D-Modem/hardware/hardware/README.md

<!-- SPDX-License-Identifier: CERN-OHL-S-2.0 -->
<!-- Copyright (C) 2026 D-Modem Authors -->
# pico-serial hardware

`netlist/build_netlist.py` defines every part and every connection on the
board. The netlist, the readable net list, the JLC parts list, the
schematic and the PCB are all generated from it, so change the script,
not the outputs.

It makes three boards. The **hood board** (the default) fits a standard DB25
hood. **pico-serial W** (`--variant w`, [SPEC-W.md](../SPEC-W.md)) adds an
RM2 Bluetooth module and lives in a 3D-printed hood (`enclosure/`). Its
files carry a `-w` suffix; see [pico-serial W](#pico-serial-w-bluetooth).
**pico-serial Line** (`--variant line`, [SPEC-L.md](../SPEC-L.md)) is a
different device on the same RP2040 core: a USB-C stick that connects to a
telephone line, for D-Modem; files `-line`, see
[pico-serial Line](#pico-serial-line-phone-line-stick).

Everything targets **KiCad 9**: KiCad 9 file formats and the KiCad 9.0
symbol and footprint libraries. KiCad 10 opens it too.

| File | What it is |
|---|---|
| `netlist/build_netlist.py` | The circuit: parts, nets, the checks |
| `netlist/pico-serial.net` | KiCad netlist (generated) |
| `netlist/NETLIST.md` | Every net and every part, readable (generated) |
| `netlist/bom-jlc.csv` | JLC assembly parts list with LCSC numbers (generated) |
| `kicad/build_schematic.py` | Draws the schematic from the netlist script |
| `kicad/pico-serial.kicad_sch` | KiCad schematic, one A2 sheet (generated) |
| `kicad/pico-serial.kicad_sym` | SP3238E and MAX3243E symbols, which KiCad doesn't ship (generated) |
| `kicad/preview.svg` | Rough drawing of the sheet for a quick look (generated) |
| `kicad/build_pcb.py` | Lays out and routes the PCB: outline, rules, placement, planes |
| `kicad/pico-serial.kicad_pcb` | KiCad PCB, 4 layers (generated) |
| `kicad/pico-serial.kicad_dru` | Two board-specific DRC rules (the DB25 cups and USB-C shell at the edges) |
| `kicad/fab/` | Gerbers + drill (zip) and the JLC placement file (generated) |
| `kicad/render-top.png`, `render-bottom.png` | KiCad 3D renders, without part models (generated) |
| `netlist/pico-serial-w.net`, `NETLIST-w.md`, `bom-jlc-w.csv` | The same for pico-serial W (generated) |
| `kicad/pico-serial-w.*`, `preview-w.svg`, `render-w-*.png` | pico-serial W's schematic, PCB, rules and renders |
| `kicad/lib/make_footprints.py` | Writes `lib/pico-serial.pretty/`: the RM2 (from its datasheet's drawing), the M2 screw hole, the RJ11 and the telecom fuse |
| `netlist/*-line.*`, `kicad/pico-serial-line.*`, `kicad/render-line-*.png` | pico-serial Line's netlist, BOM, schematic, PCB, rules and renders |
| `netlist/*-wb.*`, `kicad/pico-serial-wb.*`, `kicad/render-wb-*.png` | pico-serial WB's netlist, BOM, schematic, PCB, rules and renders |
| `enclosure/stick.py`, `enclosure/out-line/` | The Line stick's printed shell, its board outline and placement |
| `kicad/fp-lib-table` | Points KiCad at `lib/pico-serial.pretty` |

## Regenerate

```sh
python3 hardware/netlist/build_netlist.py       # checks + netlist, NETLIST.md, BOM
python3 hardware/kicad/build_schematic.py   # checks + schematic and preview
python3 hardware/kicad/build_pcb.py --kicad-fp kicad-footprints --route --fab   # PCB (see below)
```

Add `--variant w` to each for pico-serial W.

Neither needs KiCad or a network connection. The schematic script uses
symbols cached in `kicad/lib/symbol-cache.sexp`.

To check every pin against KiCad's own libraries, and to refresh the
symbol cache, point the scripts at the KiCad 9.0 library checkouts:

```sh
git clone --depth 1 --branch 9.0.6 https://gitlab.com/kicad/libraries/kicad-symbols.git
git clone --depth 1 --branch 9.0.6 https://gitlab.com/kicad/libraries/kicad-footprints.git
python3 hardware/netlist/build_netlist.py --kicad-sym kicad-symbols --kicad-fp kicad-footprints
python3 hardware/kicad/build_schematic.py --kicad-sym9 kicad-symbols
```

It stops with an error, and writes nothing, if:
- a pin is neither connected nor listed as deliberately open;
- a net has only one pin;
- a net has two outputs;
- an RS-232 line doesn't have exactly one driver and one receiver;
- a power input isn't on a supply net;
- with the KiCad checkouts: a pin number or name differs from KiCad's
  symbol, or a footprint lacks a pad for a pin.

## What's in it

The circuit follows `../SPEC.md` (draft 0.3): §4.2–4.8 for the parts and
§4.6 for the GPIO map.

- **Power and USB:**
  - USB-C (HRO TYPE-C-31-M-12) with its own 5.1 kΩ on each CC pin;
  - 0.5 A PTC fuse, 5 V TVS diode, USBLC6 ESD protection;
  - AP2112K 3.3 V regulator, VBUS ÷2 sense into GP29.
- **RP2040:**
  - Raspberry Pi's minimal design: per-pin decoupling, 12 MHz crystal
    with 15 pF caps and 1 kΩ on XOUT, 27 Ω USB series resistors;
  - W25Q128JV flash;
  - BOOTSEL and RESET buttons, 10 kΩ RUN pull-up.
- **RS-232:**
  - SP3238E (chip A, DCE) and MAX3243E (chip B, DTE) on the same 8 DB25
    pins, so every line has one driver and one receiver;
  - each chip has 220 nF + 1 µF charge-pump caps and 1 µF + 100 nF on VCC;
  - both chips are held off by 100 kΩ pull-downs until firmware chooses
    a role.
- **DB25:** solder-cup female (MH Connectors MHDB25SS). Pin 7 to GND, pin
  1 to GND through a 0 Ω link. All other unused pins stay open.
- **Optional:** six status LEDs on GP22–27, not fitted (DNP).
- **Test pads:** VBUS, 3V3, 1V1, GND, SWCLK, SWDIO, RUN, GP28, and the TX/RX
  lines of both chips.

The two RS-232 chips have no KiCad symbol. Their pin tables are copied
from the datasheets (MaxLinear SP3238E rev 1.0.1; TI MAX3243E SLLS657E,
Table 6-2) and marked as such in the script. Every other part's pins
match KiCad's library symbols.

## The schematic

`kicad/pico-serial.kicad_sch` is one A2 sheet in blocks:
- USB-C, protection and supply;
- RP2040 and its decoupling;
- crystal, flash and buttons;
- chip A (DCE) and chip B (DTE), each with its charge-pump capacitors;
- the DB25;
- the optional LEDs;
- test pads and the power flags ERC needs.

Every pin ends in a short wire with a net label or power symbol, so parts
connect by name, not by long wires. Each part carries its LCSC number, a
note on its purpose, and its footprint.

The schematic script refuses to write if:
- the connections read back from the drawing differ from the netlist in
  any way (a missing pin, an extra join, a pin touching the middle of a
  wire);
- any two texts, labels or symbols overlap.

It's generated, so hand edits are overwritten on the next run. Either
change `build_netlist.py` and regenerate, or stop generating and edit in
KiCad from then on.

## The PCB

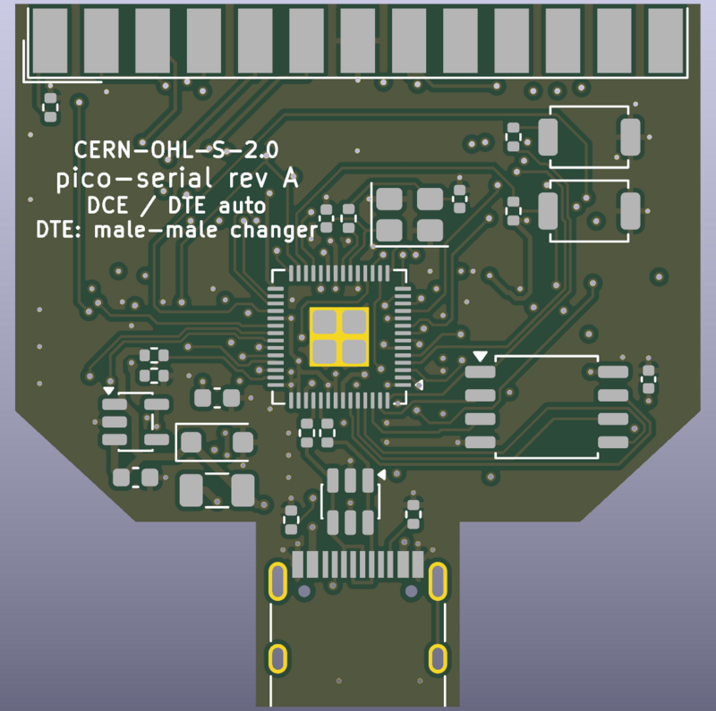
[picture p2: hardware/kicad/render-top.png]
Top

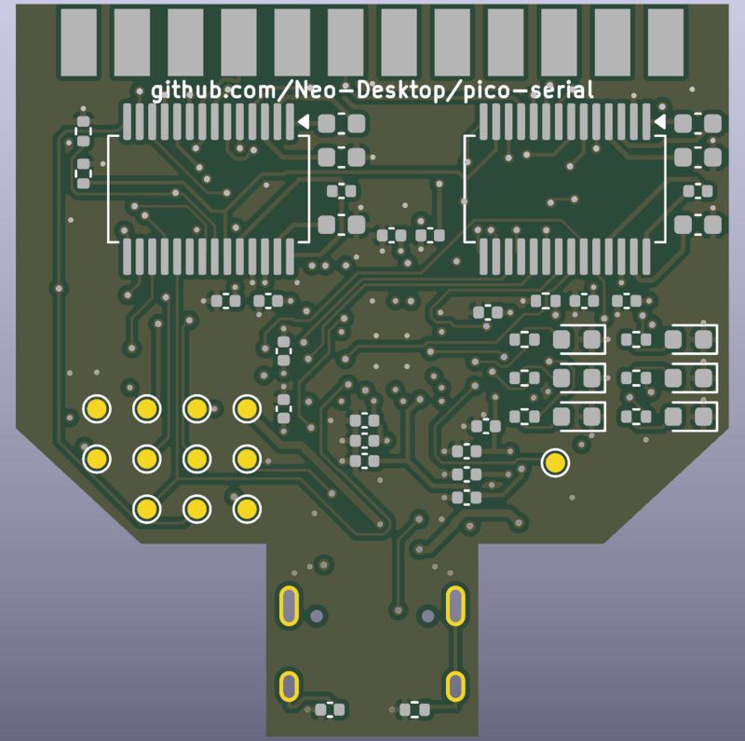
[picture p3: hardware/kicad/render-bottom.png]
Bottom


`kicad/pico-serial.kicad_pcb`, made by `kicad/build_pcb.py` with KiCad
9's Python module (pcbnew). **Status:** fully routed; KiCad 9.0.9's DRC
finds no errors, no warnings and nothing unconnected, and the PCB matches
the schematic exactly (DRC's schematic parity check). CI checks all of
this on every change (`.github/workflows/hardware.yml`). Not yet
reviewed by a person, and nothing has been built.

- **Board:** about 37 × 38 mm, 4 layers, 1.6 mm; JLCPCB's standard
  4-layer process with margin (0.127 mm clearance, 0.15 mm tracks,
  0.25 mm via drills). The outline is SPEC §7.2's inferred one: full width at the DB25,
  narrowing behind, and a tongue for the USB-C into the hood's cable exit.
  It's set at the top of the script; **confirm it on a sample hood**.
- **DB25:** the board's front edge slides between the solder cups: pins
  1-13 on top, 14-25 underneath.
- **Top:** RP2040, flash, crystal, buttons; USB-C, ESD, fuse, TVS and the
  regulator at the back.
- **Bottom:** both transceivers with their charge pumps, right behind the
  cups (seen from the top, chip A/U5 is on the left and chip B/U6 on the
  right, the order with the fewest crossing connections); the RP2040's
  decoupling, about 2 mm from its pins; test pads; the
  optional LEDs.
- **Layers:**
  - F.Cu: signals, then a GND pour;
  - In1.Cu: solid GND plane under everything;
  - In2.Cu: signals, then a +3V3 pour in the space left;
  - B.Cu: signals, then a GND pour.
- **Vias:** every GND and +3V3 pad gets its own short stub and via before
  routing. The RP2040's +3V3 pins have theirs under the package, between
  the pins and the exposed pad, so the ring around it stays free for the
  signals; the exposed pad has four.
- **Kept clear:**
  - the USB D+/D- path from the RP2040 to the series resistors and the
    ESD chip has no vias across it;
  - nothing passes under the crystal on the top layer (keep-outs between
    its pads); the In1 GND plane shields it from the rest;
  - a 0.35 mm band inside the board edge has no tracks or vias
    (Freerouting doesn't apply KiCad's edge clearance).
- **Silkscreen:** on top, name and revision, "DCE / DTE auto", the
  gender-changer note and `CERN-OHL-S-2.0`; underneath, between the cups
  and the chips, `github.com/D-Modem/hardware` (the licence's
  Source Location). Reference designators are on the fab layers; there's
  no room for them on the silkscreen.
- **Linked to the schematic:** every footprint carries its symbol's ID,
  and every pad its net under the name KiCad gives it.

### Test pads (bottom)

1 mm pads on a 2.6 mm grid behind the flash, for pogo pins; GP28 sits
apart, by the RP2040's left side. Coordinates in mm, from the middle of
the DB25 edge, toward the USB-C:

| y \ x | 6.5 | 9.1 | 11.7 | 14.3 |
|---|---|---|---|---|
| 21.0 | TP1 VBUS | TP2 3V3 | TP3 1V1 | TP4 GND |
| 23.6 | TP5 SWCLK | TP6 SWDIO | TP7 RUN | TP9 A_TX |
| 26.2 | TP10 A_RX | TP11 B_TX | TP12 B_RX | |

TP8 (GP28) is at x = -9.5, y = 23.8.

### Rebuilding it

```sh
python3 hardware/kicad/build_pcb.py --kicad-fp kicad-footprints \
    --route --freerouting freerouting-1.9.0.jar --fab
```

- **Needs:** KiCad 9 (its Python module and `kicad-cli`), the KiCad 9.0
  footprint libraries, Java, `xvfb-run`, and
  [Freerouting](https://github.com/freerouting/freerouting) 1.9.0.
  Freerouting 2.1 ignores its pass limit on the command line, so 1.9 it
  is; it wants a display, hence `xvfb-run`.
- **Routing:** Freerouting routes everything but GND, which the plane and
  the vias already connect. It runs in rounds, each starting from the
  last (`--rounds`). Then a small grid router in the script (A* on a
  0.1 mm grid over the three signal layers, checked against KiCad's own
  copper shapes) joins anything still apart.
- **Repeatable:** Freerouting gives the same result for the same board and
  pass count. If a pass count leaves something unrouted, the script tries
  the next in `--passes` (40, 30, 50, 35, 45) and keeps the first that
  routes everything. It says which it kept, and warns if none did.
- **Without `--route`** it writes the placed, unrouted board (with its
  vias and planes); `--ses` imports a saved Freerouting session instead.
- **`--fab`** writes `fab/pico-serial-gerbers.zip` and
  `fab/pico-serial-cpl-jlc.csv`. Upload the zip, `netlist/bom-jlc.csv` and
  the CPL file to JLCPCB. The DB25 is hand-soldered, so it's in neither
  list.
- **Before ordering assembly:** parts go on both sides (two-sided
  assembly costs extra). Check every part's rotation in JLC's preview,
  bottom-side ones especially: the CPL comes straight from KiCad, and
  JLC's footprints don't always agree on 0°.

## Using it in KiCad

1. Open `kicad/pico-serial.kicad_pro` in KiCad 9 or 10. The project
   table points at `pico-serial.kicad_sym`, which has the two RS-232
   symbols. Every symbol is also embedded in the schematic.
2. Run ERC: clean (KiCad 9.0.9, with the 9.0 libraries).
3. Open the PCB and run DRC, with the schematic parity check: clean.
4. The PCB is linked to the schematic, so **Update PCB from Schematic**
   works as usual. DRC's parity check, the same comparison, finds no
   difference. (The update itself hasn't been run: there was no KiCad GUI
   where this was made.)

## Before ordering

- **Have a person review the layout.** It's autorouted, so check what a
  router doesn't weigh: the crystal and its loop, the decoupling, the USB
  pair, the RS-232 lines near the cups. It routes cleanly, not
  necessarily well.
- Lock the board outline from the sample connector and hood (SPEC §7, §9),
  and check the board slides between the DB25's cups.
- Bench test the SP3238E's leakage while shut down (SPEC §8). If it fails,
  the DCE chip changes to the TI TRS3238E (TSSOP-28) and its footprint
  changes too.

## pico-serial W (Bluetooth)

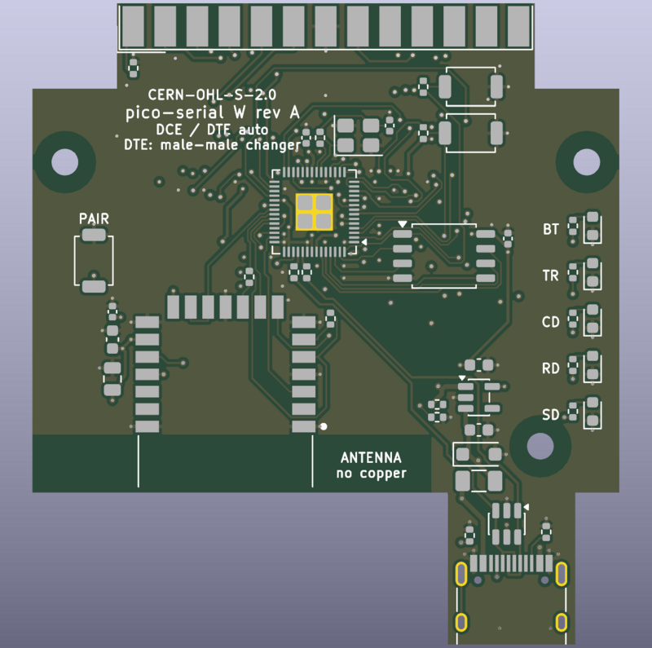
[picture p4: hardware/kicad/render-w-top.png]
W top

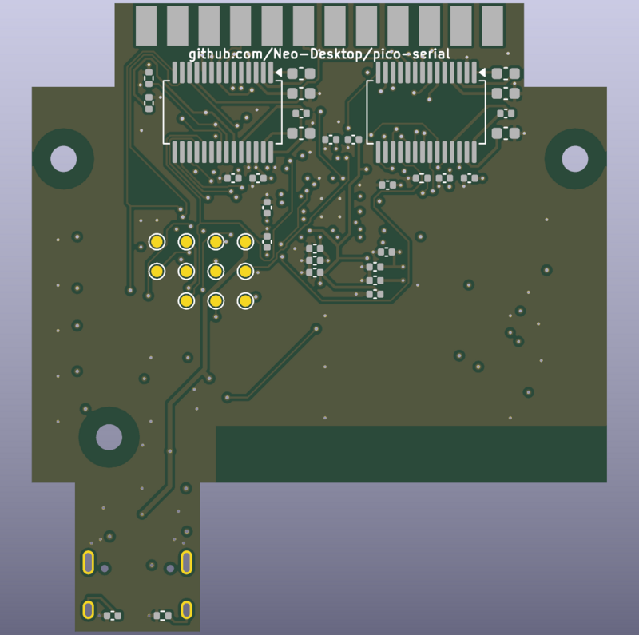
[picture p5: hardware/kicad/render-w-bottom.png]
W bottom


The same circuit plus a Raspberry Pi RM2 radio module, on a larger board
for the 3D-printed hood ([SPEC-W.md](../SPEC-W.md), `enclosure/`).
Every script takes `--variant w`; its files are `pico-serial-w.*`.

```sh
python3 hardware/netlist/build_netlist.py --variant w
python3 hardware/kicad/build_schematic.py --variant w
python3 hardware/kicad/build_pcb.py --variant w --kicad-fp kicad-footprints \
    --route --freerouting freerouting-1.9.0.jar --fab
```

**Status:** fully routed. DRC finds no errors and nothing unconnected,
and the PCB matches its schematic; ERC is clean. CI checks both boards.
Not reviewed by a person, nothing built.

- **Circuit changes** (SPEC-W §3): the RM2 on GP23-25 and GP29, wired as on
  Pico W (470 Ω and 10 kΩ into the shared GP24); 10 µF + 100 nF + 22 µF
  at its supply; five LEDs, fitted (BT, TR, CD on RP2040 pins; RD and SD
  on the RM2's own GPIOs); VBUS sense on the RM2's GPIO0; a pairing button
  on GP28 (so no GP28 test pad).
- **Outline and fixed positions** come from `enclosure/w_hood.py`, not
  from this script: the outline, three M2 screw holes, the RM2 (antenna
  end flush with the board's back edge), the USB-C in its tongue, the
  LEDs under the hood's light tubes and the button under its pinhole.
  Change them there and both stay in step.
- **Front half:** the DB25, both RS-232 chips, the RP2040, flash, crystal
  and buttons are placed as on the hood board. The front strip is 0.5 mm
  narrower (thumbscrew pockets), so chip A and its charge pumps sit
  0.6 mm further in.
- **Antenna keep-out:** a rule area with no copper on any layer (tracks,
  vias, pads, pours, planes) over the strip of board inside the RM2's
  35.5 × 18.5 mm keep-out. The rest of it is air inside the hood.
- **Screw holes:** 2.3 mm, unplated, with 5.4 mm kept free of copper and
  parts (screw head and the hood's bosses). They're board-only footprints
  (`lib/pico-serial.pretty/MountingHole_M2`), not in the schematic.
- **RM2 footprint:** `lib/make_footprints.py`, from the datasheet's
  Figure 6: 21 pads, 1.5 mm pitch, reaching 0.5 mm past the module. Check
  it against a real module before ordering.
- **Assembly:** the RM2 isn't stocked at LCSC, so it's marked
  hand-fitted and is in neither the BOM nor the CPL. Solder it by hand or
  send it to JLC as a consigned part. The DB25 is hand-soldered as on the
  hood board.
- **Before ordering:** everything under "Before ordering" above, plus a
  test print of the hood, to confirm the screw holes, LED and button
  positions.

## pico-serial Line (phone-line stick)

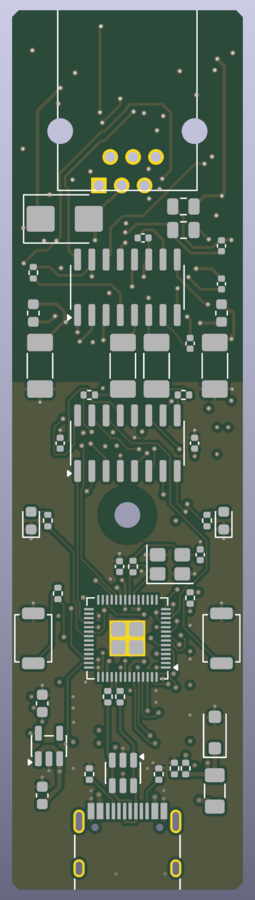
[picture p6: hardware/kicad/render-line-top.png]
Line top

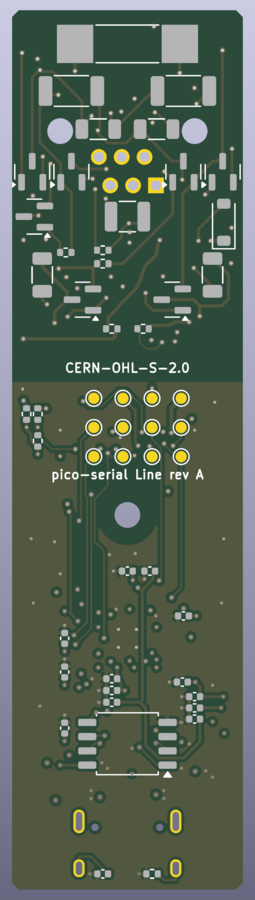
[picture p7: hardware/kicad/render-line-bottom.png]
Line bottom


A USB-C stick for a telephone line, shaped like Apple's USB Modem
([SPEC-L.md](../SPEC-L.md)): the RP2040 core and a Skyworks Si3056 +
Si3018 DAA. The modem itself is D-Modem on the computer or phone
(`dmodemd --usb`). Every script takes `--variant line`; the shell is
`enclosure/stick.py`.

```sh
python3 hardware/netlist/build_netlist.py --variant line
python3 hardware/kicad/build_schematic.py --variant line
python3 hardware/enclosure/stick.py          # the shell; needs CadQuery
python3 hardware/kicad/build_pcb.py --variant line --kicad-fp kicad-footprints \
    --route --freerouting freerouting-1.9.0.jar --fab
```

**Status:** fully routed (190 vias, 1036 tracks). KiCad's DRC finds no
errors and nothing unconnected, and the PCB matches its schematic; ERC is
clean. Not reviewed by a person, nothing built: **have the line side and
the isolation gap checked by someone who knows telecom safety before it
goes near a phone line.**

- **Board:** 78.4 × 20.6 mm, 4 layers, on the outline `stick.py` sets.
  The RJ11 at the front edge, its opening flush with the stick's end;
  the USB-C at the back.
- **Line side** (front, about 30 mm): the surge suppressor, the 1.25 A
  telecom fuse, the bridge, the Si3018 and its hook switch, DC
  termination and caller-ID parts, on both sides of the board. **No
  ground plane or pour** (Skyworks AN67): the planes and pours stop at
  the isolation gap.
- **Isolation gap:** a 2.5 mm band across the board, every layer, with no
  tracks, vias or pours; only the four Y2 capacitors (C1, C2: the data
  path; C8, C9: TIP and RING to ground) straddle it. A DRC rule
  (`pico-serial-line.kicad_dru`) also holds 2.5 mm between any line-side
  and USB-side copper.
- **Net classes:** `TipRing` (TIP, RING, the bridge's +: the ringing
  signal and loop current) 0.3 mm tracks, 0.4 mm clearance; `Line` (the
  Si3018's low-voltage side) 0.25 mm.
- **USB side:** the Si3056 by the gap, the one screw, the two LEDs under
  the shell's light tubes, the RP2040 with its flash underneath, then the
  USB-C with its ESD, fuse and regulator.
- **Hand-fitted or consigned:** the Si3056 and Si3018 (DigiKey; the
  Si3056 is "not for new designs") and the through-hole RJ11. They're in
  neither the JLC BOM nor the CPL.
- **Not checked yet:** the RJ11's body against a real one (its drawing
  gives the pins and pegs; the body's edges are read off it), and the
  shell's fit (not printed).

## pico-serial WB (wideband bare-pair stick)

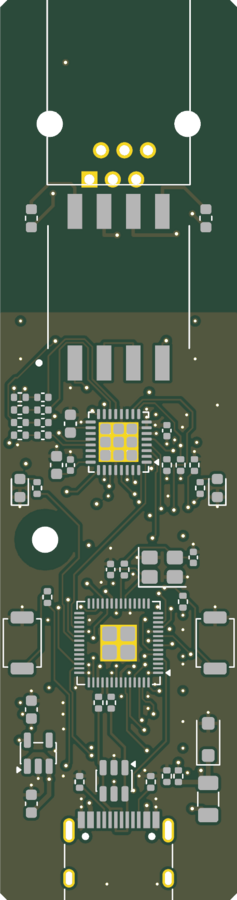
[picture p8: hardware/kicad/render-wb-top.png]
WB top

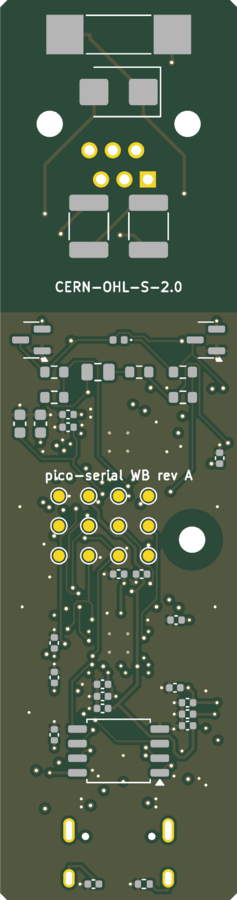
[picture p9: hardware/kicad/render-wb-bottom.png]
WB bottom


The Line stick's sibling for bare copper pairs ([SPEC-WB.md](../SPEC-WB.md)):
the same RP2040 core and USB end, a TI TLV320AIC3204 codec sampling at
96 kHz, and a Pulse PE-65848 line transformer. Two WB sticks talk to each
other over the pair; the modem is D-Modem's wideband mode on the
computer or phone. Every script takes `--variant wb`; the shell is the
Line stick's (`enclosure/stick.py --variant wb`).

```sh
python3 hardware/netlist/build_netlist.py --variant wb
python3 hardware/kicad/build_schematic.py --variant wb
python3 hardware/enclosure/stick.py --variant wb     # the shell; needs CadQuery
python3 hardware/kicad/build_pcb.py --variant wb --kicad-fp kicad-footprints \
    --route --freerouting freerouting-1.9.0.jar --fab
```

**Status:** fully routed. KiCad's DRC finds no errors and nothing unconnected, and the PCB matches its schematic; ERC is clean. Fab files in `kicad/fab/`. Not reviewed by a person, nothing built.

- **Board:** the Line stick's outline and USB end (RP2040, flash, USB-C,
  regulator). The screw is 6.4 mm off the centre line and the two LEDs
  (LINK and DATA) 3 mm further forward than on the Line stick, so the
  codec's connections can run down the middle; `stick.py --variant wb`
  moves the shell's boss and light tubes to match.
- **Pair side** (front): the RJ11, the 1.25 A telecom fuse and the
  sidactor underneath, ferrites beside the transformer, and the DC block
  (two 1 µF 250 V in series, 0.5 µF / 500 V) in the transformer's split
  line winding. **No ground plane or pour.**
- **Isolation gap:** a 4 mm band across the board under the transformer,
  every layer, no tracks, vias or pours. Only the transformer crosses
  it: its codec winding's pads and its line winding's are 10 mm apart. A
  DRC rule (`pico-serial-wb.kicad_dru`) also holds 2.5 mm between any
  pair-side (`TipRing`) and USB-side copper.
- **Codec side:** the hybrid on the bottom behind the transformer (60.4 Ω
  drive resistors, the ×10 replica arm, the 1 kΩ + 1 µF into each mixer
  input), the clamps (a 5 V TVS across the winding, a BAV99 on each
  end), and the codec on top with its supply and reference capacitors.
- **Hand-fitted:** the through-hole RJ11. The transformer is a JLC part
  (C7261159), but stock is low (about 250).
- **Not checked yet:** the transformer's bandwidth and saturation (its
  datasheet gives neither: sweep one from 1 to 200 kHz), the hybrid's
  values on a real cable, and the shell's fit (not printed). The 1812 DC
  block capacitors sit on the bottom, under the shell's 2.2 mm clearance.
