D-Modem/hardware/docs/README.md

# pico-serial documentation

## Specs

- [SPEC.md](../SPEC.md): pico-serial, the DB25 adapter
- [SPEC-W.md](../SPEC-W.md): pico-serial W, the Bluetooth variant
- [SPEC-L.md](../SPEC-L.md): pico-serial Line, the phone-line stick
- [SPEC-WB.md](../SPEC-WB.md): pico-serial WB, the wideband bare-pair stick

## Firmware

- [firmware/README.md](../firmware/README.md): build, flash, what it does, Bluetooth, automatic baud rate, tests, the Line and WB sticks
- [firmware/PROTOCOL.md](../firmware/PROTOCOL.md): the control protocol for host apps
- [Protocol reference](protocol-reference.md): every request, constant and wire struct in the protocol headers, made from them (`firmware/tools/protocol_ref.py`)

## Hardware

- [hardware/README.md](../hardware/README.md): the netlist script, schematic, PCB, test pads, ordering
- [hardware/enclosure/README.md](../hardware/enclosure/README.md): the 3D-printed enclosures
- Generated net lists: [NETLIST.md](../hardware/netlist/NETLIST.md), [NETLIST-w.md](../hardware/netlist/NETLIST-w.md), [NETLIST-line.md](../hardware/netlist/NETLIST-line.md), [NETLIST-wb.md](../hardware/netlist/NETLIST-wb.md)

## Licensing

- [LICENSING.md](../LICENSING.md)
