D-Modem/hardware/hardware/netlist/NETLIST-line.md

<!-- SPDX-License-Identifier: CERN-OHL-S-2.0 -->
<!-- Copyright (C) 2026 D-Modem Authors -->
# pico-serial Line netlist

Generated by `build_netlist.py`; edit that script, not this file.

99 parts, 76 nets. DNP = not fitted by default.

## Nets

| Net | Pins |
|---|---|
| `+1V1` | C13.1, C14.1, C15.1, TP3.1 (1), U1.23 (DVDD), U1.45 (VREG_VOUT), U1.50 (DVDD) |
| `+3V3` | C3.1, C4.1, C5.1, C6.1, C7.1, C8.1, C9.1, C10.1, C11.1, C12.1, C18.1, C19.1, R10.1, R11.1, R12.1, R13.1, TP2.1 (1), U1.1 (IOVDD), U1.10 (IOVDD), U1.22 (IOVDD), U1.33 (IOVDD), U1.42 (IOVDD), U1.43 (ADC_AVDD), U1.44 (VREG_IN), U1.48 (USB_VDD), U1.49 (IOVDD), U2.8 (VCC), U3.5 (VOUT), U5.4 (VD) |
| `BOOTSEL_SW` | R9.2, SW1.1 (1) |
| `CC1` | J1.A5 (CC1), R1.1 |
| `CC2` | J1.B5 (CC2), R2.1 |
| `DAA_C1A` | R14.1, U5.10 (C1A) |
| `DAA_C1A_R` | C21.1, R14.2 |
| `DAA_C2A` | R15.1, U5.9 (C2A) |
| `DAA_C2A_R` | C22.1, R15.2 |
| `DAA_FC` | U1.8 (GPIO6), U5.7 (FC/~{RGDT}) |
| `DAA_FSYNC` | TP10.1 (1), U1.5 (GPIO3), U5.2 (~{FSYNC}) |
| `DAA_INT_N` | R13.2, U1.11 (GPIO8), U5.11 (AOUT/~{INT}) |
| `DAA_M0` | U1.12 (GPIO9), U5.14 (M0) |
| `DAA_MCLK` | U1.32 (GPIO21), U5.1 (MCLK) |
| `DAA_OFHK_N` | R12.2, U1.14 (GPIO11), U5.16 (~{OFHK}) |
| `DAA_RESET_N` | U1.9 (GPIO7), U5.8 (~{RESET}) |
| `DAA_RGDT_N` | R11.2, U1.13 (GPIO10), U5.15 (~{RGDT}/FSD/M1) |
| `DAA_SCLK` | TP9.1 (1), U1.4 (GPIO2), U5.3 (SCLK) |
| `DAA_SDI` | TP12.1 (1), U1.7 (GPIO5), U5.6 (SDI) |
| `DAA_SDO` | TP11.1 (1), U1.6 (GPIO4), U5.5 (SDO) |
| `DAA_VA` | C20.1, U5.13 (VA) |
| `GND` | C1.2, C2.2, C3.2, C4.2, C5.2, C6.2, C7.2, C8.2, C9.2, C10.2, C11.2, C12.2, C13.2, C14.2, C15.2, C16.2, C17.2, C18.2, C19.2, C20.2, C29.2, C30.2, D1.2 (A), D5.1 (K), D6.1 (K), J1.A1 (GND), J1.A12 (GND), J1.B1 (GND), J1.B12 (GND), R1.2, R2.2, R3.2, R5.2, SW1.2 (2), SW2.2 (2), TP4.1 (1), U1.19 (TESTEN), U1.57 (GND), U2.4 (GND), U3.2 (GND), U4.2 (GND), U5.12 (GND), Y1.2 (2), Y1.4 (4) |
| `GP28` | TP8.1 (1), U1.40 (GPIO28_ADC2) |
| `LED_OH` | R29.1, U1.34 (GPIO22) |
| `LED_OH_A` | D5.2 (A), R29.2 |
| `LED_RI` | R30.1, U1.35 (GPIO23) |
| `LED_RI_A` | D6.2 (A), R30.2 |
| `LINE_RING` | J2.3 (RING), R28.2, RV1.2 |
| `LINE_RING_F` | D4.3 (K/A), FB2.1, R26.2 |
| `LINE_RING_M` | C30.1, FB2.2, R28.1 |
| `LINE_TIP` | F2.1, J2.4 (TIP) |
| `LINE_TIP_F` | D3.3 (K/A), FB1.1, R25.2 |
| `LINE_TIP_M` | C29.1, FB1.2, R27.1 |
| `LINE_TIP_P` | F2.2, R27.2, RV1.1 |
| `LINE_VP` | C27.2, C28.2, D3.2 (K), D4.2 (K), Q1.3 (C), Q2.2 (E), R24.2 |
| `LS_C1B` | C21.2, U6.5 (C1B) |
| `LS_C2B` | C22.2, U6.6 (C2B) |
| `LS_DCT` | R16.1, U6.2 (DCT) |
| `LS_DCT2` | Q3.1 (B), R19.2, R20.1, U6.16 (DCT2) |
| `LS_DCT3` | Q5.2 (E), U6.14 (DCT3) |
| `LS_E` | Q1.2 (E), Q4.3 (C), R18.2, R21.1, R23.1 |
| `LS_HB` | D2.1 (K), Q1.1 (B), Q2.3 (C), R19.1, R22.2, R23.2 |
| `LS_IB` | R17.1, U6.4 (IB) |
| `LS_IGND` | C24.2, C25.2, C26.2, C28.1, D3.1 (A), D4.1 (A), R17.2, U6.11 (SC), U6.15 (IGND) |
| `LS_Q2B` | C27.1, Q2.1 (B), Q3.3 (C), R24.1 |
| `LS_Q5B` | Q5.1 (B), R20.2 |
| `LS_Q5C` | Q5.3 (C), R21.2 |
| `LS_QB` | Q4.1 (B), R22.1, U6.13 (QB) |
| `LS_QE` | D2.2 (A), Q3.2 (E), U6.1 (QE) |
| `LS_QE2` | Q4.2 (E), U6.12 (QE2) |
| `LS_RNG1` | R25.1, U6.8 (RNG1) |
| `LS_RNG2` | R26.1, U6.9 (RNG2) |
| `LS_RX` | C23.2, U6.3 (RX) |
| `LS_TOP` | C23.1, C26.1, R16.2, R18.1 |
| `LS_VREG` | C24.1, U6.7 (VREG) |
| `LS_VREG2` | C25.1, U6.10 (VREG2) |
| `QSPI_SCLK` | U1.52 (QSPI_SCLK), U2.6 (CLK) |
| `QSPI_SD0` | U1.53 (QSPI_SD0), U2.5 (DI/IO_{0}) |
| `QSPI_SD1` | U1.55 (QSPI_SD1), U2.2 (DO/IO_{1}) |
| `QSPI_SD2` | U1.54 (QSPI_SD2), U2.3 (~{WP}/IO_{2}) |
| `QSPI_SD3` | U1.51 (QSPI_SD3), U2.7 (~{HOLD}/~{RESET}/IO_{3}) |
| `QSPI_SS` | R9.1, U1.56 (QSPI_SS), U2.1 (~{CS}) |
| `RUN` | R10.2, SW2.1 (1), TP7.1 (1), U1.26 (RUN) |
| `SWCLK` | TP5.1 (1), U1.24 (SWCLK) |
| `SWDIO` | TP6.1 (1), U1.25 (SWD) |
| `USB_CONN_DM` | J1.A7 (D-), J1.B7 (D-), R7.1, U4.3 (I/O2), U4.4 (I/O2) |
| `USB_CONN_DP` | J1.A6 (D+), J1.B6 (D+), R6.1, U4.1 (I/O1), U4.6 (I/O1) |
| `USB_DM` | R7.2, U1.46 (USB_DM) |
| `USB_DP` | R6.2, U1.47 (USB_DP) |
| `USB_SHIELD` | C1.1, J1.S1 (SHIELD), R3.1 |
| `VBUS` | C2.1, D1.1 (K), F1.2, R4.1, TP1.1 (1), U3.1 (VIN), U3.3 (EN), U4.5 (VBUS) |
| `VBUS_IN` | F1.1, J1.A4 (VBUS), J1.A9 (VBUS), J1.B4 (VBUS), J1.B9 (VBUS) |
| `VBUS_SENSE` | R4.2, R5.1, U1.41 (GPIO29_ADC3) |
| `XIN` | C16.1, U1.20 (XIN), Y1.1 (1) |
| `XOUT` | R8.1, U1.21 (XOUT) |
| `XTAL_OUT` | C17.1, R8.2, Y1.3 (3) |

## Parts

| Ref | Value | LCSC | Footprint | Note |
|---|---|---|---|---|
| C1 | 4.7nF | C1538 | `Capacitor_SMD:C_0402_1005Metric` | shell to GND, RF |
| C2 | 10uF | C19702 | `Capacitor_SMD:C_0603_1608Metric` | LDO input |
| C3 | 10uF | C19702 | `Capacitor_SMD:C_0603_1608Metric` | LDO output, 3V3 bulk |
| C4 | 100nF | C1525 | `Capacitor_SMD:C_0402_1005Metric` | IOVDD pin 1 |
| C5 | 100nF | C1525 | `Capacitor_SMD:C_0402_1005Metric` | IOVDD pin 10 |
| C6 | 100nF | C1525 | `Capacitor_SMD:C_0402_1005Metric` | IOVDD pin 22 |
| C7 | 100nF | C1525 | `Capacitor_SMD:C_0402_1005Metric` | IOVDD pin 33 |
| C8 | 100nF | C1525 | `Capacitor_SMD:C_0402_1005Metric` | IOVDD pin 42 |
| C9 | 100nF | C1525 | `Capacitor_SMD:C_0402_1005Metric` | IOVDD pin 49 |
| C10 | 100nF | C1525 | `Capacitor_SMD:C_0402_1005Metric` | USB_VDD |
| C11 | 100nF | C1525 | `Capacitor_SMD:C_0402_1005Metric` | ADC_AVDD |
| C12 | 1uF | C52923 | `Capacitor_SMD:C_0402_1005Metric` | VREG_VIN |
| C13 | 1uF | C52923 | `Capacitor_SMD:C_0402_1005Metric` | VREG_VOUT |
| C14 | 100nF | C1525 | `Capacitor_SMD:C_0402_1005Metric` | DVDD pin 23 |
| C15 | 100nF | C1525 | `Capacitor_SMD:C_0402_1005Metric` | DVDD pin 50 |
| C16 | 15pF | C1548 | `Capacitor_SMD:C_0402_1005Metric` | crystal load |
| C17 | 15pF | C1548 | `Capacitor_SMD:C_0402_1005Metric` | crystal load |
| C18 | 100nF | C1525 | `Capacitor_SMD:C_0402_1005Metric` | flash VCC |
| C19 | 100nF | C1525 | `Capacitor_SMD:C_0402_1005Metric` | Si3056 VD (C50) |
| C20 | 100nF | C1525 | `Capacitor_SMD:C_0402_1005Metric` | Si3056 VA (C51) |
| C21 | 33pF Y2 | C2915768 | `Capacitor_SMD:C_1808_4520Metric` | isolation barrier, Y2 safety |
| C22 | 33pF Y2 | C2915768 | `Capacitor_SMD:C_1808_4520Metric` | isolation barrier, Y2 safety |
| C23 | 1uF 50V | C28323 | `Capacitor_SMD:C_0805_2012Metric` |  |
| C24 | 100nF | C1525 | `Capacitor_SMD:C_0402_1005Metric` |  |
| C25 | 100nF | C1525 | `Capacitor_SMD:C_0402_1005Metric` |  |
| C26 | 2.7nF | C106251 | `Capacitor_SMD:C_0402_1005Metric` |  |
| C27 | 10nF | C60133 | `Capacitor_SMD:C_0402_1005Metric` |  |
| C28 | 10nF 250V | C106841 | `Capacitor_SMD:C_0805_2012Metric` |  |
| C29 | 680pF Y2 | C524545 | `Capacitor_SMD:C_1808_4520Metric` | TIP/RING to ground, Y2 safety (Murata) |
| C30 | 680pF Y2 | C524545 | `Capacitor_SMD:C_1808_4520Metric` | TIP/RING to ground, Y2 safety (Murata) |
| D1 | SMF5.0A | C151296 | `Diode_SMD:D_SOD-123F` | 5 V TVS, unidirectional |
| D2 | BZT52C43 | C2847220 | `Diode_SMD:D_SOD-123` | 43 V, 500 mW |
| D3 | MMBD3004S | C7436538 | `Package_TO_SOT_SMD:SOT-23` | two 350 V diodes in series |
| D4 | MMBD3004S | C7436538 | `Package_TO_SOT_SMD:SOT-23` | two 350 V diodes in series |
| D5 | LED_OH | C2286 | `LED_SMD:LED_0603_1608Metric` | OH status LED |
| D6 | LED_RI | C2286 | `LED_SMD:LED_0603_1608Metric` | RI status LED |
| F1 | 0.5A | C163512 | `Fuse:Fuse_1206_3216Metric` | Littelfuse 1206L050YR PTC |
| F2 | 1.25A | C99554 | `pico-serial:Fuse_Littelfuse_0461` | Littelfuse TeleLink 04611.25ER, 600 V |
| FB1 | 600R@100MHz | C19330 | `Inductor_SMD:L_0603_1608Metric` | Murata BLM18AG601SN1D, 200 mA |
| FB2 | 600R@100MHz | C19330 | `Inductor_SMD:L_0603_1608Metric` | Murata BLM18AG601SN1D, 200 mA |
| J1 | USB_C | C165948 | `Connector_USB:USB_C_Receptacle_HRO_TYPE-C-31-M-12` | HRO TYPE-C-31-M-12 |
| J2 | RJ11 | C189750 | `pico-serial:RJ11_Ckmtw_R-RJ11R06P-A800` | Ckmtw R-RJ11R06P-A800, 6P6C right angle; hand-soldered |
| Q1 | MMBTA42 | C94389 | `Package_TO_SOT_SMD:SOT-23` | NPN 300 V |
| Q2 | MMBTA92 | C82049 | `Package_TO_SOT_SMD:SOT-23` | PNP 300 V |
| Q3 | MMBTA42 | C94389 | `Package_TO_SOT_SMD:SOT-23` | NPN 300 V |
| Q4 | MMBTA06 | C77760 | `Package_TO_SOT_SMD:SOT-23` | NPN 80 V (the datasheet's MMBT2484 or MMBTA06) |
| Q5 | MMBTA06 | C77760 | `Package_TO_SOT_SMD:SOT-23` | NPN 80 V (the datasheet's MMBT2484 or MMBTA06) |
| R1 | 5.1k | C25905 | `Resistor_SMD:R_0402_1005Metric` | CC1 Rd: separate resistor per CC pin |
| R2 | 5.1k | C25905 | `Resistor_SMD:R_0402_1005Metric` | CC2 Rd |
| R3 | 1M | C26083 | `Resistor_SMD:R_0402_1005Metric` | shell bleed |
| R4 | 100k | C25741 | `Resistor_SMD:R_0402_1005Metric` | VBUS divider top |
| R5 | 100k | C25741 | `Resistor_SMD:R_0402_1005Metric` | VBUS divider bottom |
| R6 | 27R | C25100 | `Resistor_SMD:R_0402_1005Metric` | USB D+ series |
| R7 | 27R | C25100 | `Resistor_SMD:R_0402_1005Metric` | USB D- series |
| R8 | 1k | C11702 | `Resistor_SMD:R_0402_1005Metric` | crystal drive limit |
| R9 | 1k | C11702 | `Resistor_SMD:R_0402_1005Metric` | BOOTSEL |
| R10 | 10k | C25744 | `Resistor_SMD:R_0402_1005Metric` | RUN pull-up; RP2040 has a weak internal one, this adds noise margin |
| R11 | 4.7k | C25900 | `Resistor_SMD:R_0402_1005Metric` | DAA_RGDT_N pull-up |
| R12 | 4.7k | C25900 | `Resistor_SMD:R_0402_1005Metric` | DAA_OFHK_N pull-up |
| R13 | 4.7k | C25900 | `Resistor_SMD:R_0402_1005Metric` | DAA_INT_N pull-up |
| R14 | 56.2R | C51048309 | `Resistor_SMD:R_0402_1005Metric` | 1% |
| R15 | 56.2R | C51048309 | `Resistor_SMD:R_0402_1005Metric` | 1% |
| R16 | 1.07k | C51048343 | `Resistor_SMD:R_2010_5025Metric` | 1%, 750 mW |
| R17 | 1M | C26083 | `Resistor_SMD:R_0402_1005Metric` | 1% |
| R18 | 536R | C305048 | `Resistor_SMD:R_1206_3216Metric` | 1%, 250 mW |
| R19 | 3.65k | C877404 | `Resistor_SMD:R_2010_5025Metric` | 1%, 750 mW |
| R20 | 150R | C25082 | `Resistor_SMD:R_0402_1005Metric` |  |
| R21 | 73.2R | C2991291 | `Resistor_SMD:R_1210_3225Metric` | 1%, 500 mW |
| R22 | 2.49k | C6263440 | `Resistor_SMD:R_1206_3216Metric` | 1%, 500 mW |
| R23 | 100k | C25741 | `Resistor_SMD:R_0402_1005Metric` |  |
| R24 | 100k | C25741 | `Resistor_SMD:R_0402_1005Metric` |  |
| R25 | 20M | C71198 | `Resistor_SMD:R_1206_3216Metric` | 1%, 200 V (caller ID) |
| R26 | 20M | C71198 | `Resistor_SMD:R_1206_3216Metric` | 1%, 200 V (caller ID) |
| R27 | 0R | C17168 | `Resistor_SMD:R_0402_1005Metric` |  |
| R28 | 0R | C17168 | `Resistor_SMD:R_0402_1005Metric` |  |
| R29 | 1k | C11702 | `Resistor_SMD:R_0402_1005Metric` | OH LED current |
| R30 | 1k | C11702 | `Resistor_SMD:R_0402_1005Metric` | RI LED current |
| RV1 | P3100SC | C151191 | `Diode_SMD:D_SMB` | Littelfuse P3100SCLRP, 275 V, 250 A 8/20 |
| SW1 | BOOTSEL | C720477 | `Button_Switch_SMD:SW_SPST_TS-1088-xR020` | XUNPU TS-1088-AR02016 |
| SW2 | RESET | C720477 | `Button_Switch_SMD:SW_SPST_TS-1088-xR020` | XUNPU TS-1088-AR02016 |
| TP1 | VBUS |  | `TestPoint:TestPoint_Pad_D1.0mm` |  |
| TP2 | 3V3 |  | `TestPoint:TestPoint_Pad_D1.0mm` |  |
| TP3 | 1V1 |  | `TestPoint:TestPoint_Pad_D1.0mm` |  |
| TP4 | GND |  | `TestPoint:TestPoint_Pad_D1.0mm` |  |
| TP5 | SWCLK |  | `TestPoint:TestPoint_Pad_D1.0mm` |  |
| TP6 | SWDIO |  | `TestPoint:TestPoint_Pad_D1.0mm` |  |
| TP7 | RUN |  | `TestPoint:TestPoint_Pad_D1.0mm` |  |
| TP8 | GP28 |  | `TestPoint:TestPoint_Pad_D1.0mm` |  |
| TP9 | SCLK |  | `TestPoint:TestPoint_Pad_D1.0mm` |  |
| TP10 | FSYNC |  | `TestPoint:TestPoint_Pad_D1.0mm` |  |
| TP11 | SDO |  | `TestPoint:TestPoint_Pad_D1.0mm` |  |
| TP12 | SDI |  | `TestPoint:TestPoint_Pad_D1.0mm` |  |
| U1 | RP2040 | C2040 | `Package_DFN_QFN:QFN-56-1EP_7x7mm_P0.4mm_EP3.2x3.2mm` |  |
| U2 | W25Q128JVS | C97521 | `Package_SO:SOIC-8_5.3x5.3mm_P1.27mm` |  |
| U3 | AP2112K-3.3 | C51118 | `Package_TO_SOT_SMD:SOT-23-5` |  |
| U4 | USBLC6-2SC6 | C7519 | `Package_TO_SOT_SMD:SOT-23-6` |  |
| U5 | Si3056-D-FS |  | `Package_SO:SOIC-16_3.9x9.9mm_P1.27mm` | Skyworks Si3056 DAA, system side; from DigiKey, not at LCSC; hand-soldered |
| U6 | Si3018-F-FS |  | `Package_SO:SOIC-16_3.9x9.9mm_P1.27mm` | Skyworks Si3018 DAA, line side; DigiKey, not at LCSC; hand-soldered |
| Y1 | 12MHz | C20625731 | `Crystal:Crystal_SMD_3225-4Pin_3.2x2.5mm` | Abracon ABM8-272-T3 |

## Not connected (on purpose)

- J1.A8 (SBU1)
- J1.B8 (SBU2)
- J2.1 (1)
- J2.2 (2)
- J2.5 (5)
- J2.6 (6)
- U1.2 (GPIO0)
- U1.3 (GPIO1)
- U1.15 (GPIO12)
- U1.16 (GPIO13)
- U1.17 (GPIO14)
- U1.18 (GPIO15)
- U1.27 (GPIO16)
- U1.28 (GPIO17)
- U1.29 (GPIO18)
- U1.30 (GPIO19)
- U1.31 (GPIO20)
- U1.36 (GPIO24)
- U1.37 (GPIO25)
- U1.38 (GPIO26_ADC0)
- U1.39 (GPIO27_ADC1)
- U3.4 (NC)
