D-Modem/hardware/hardware/netlist/NETLIST-wb.md

<!-- SPDX-License-Identifier: CERN-OHL-S-2.0 -->
<!-- Copyright (C) 2026 D-Modem Authors -->
# pico-serial WB netlist

Generated by `build_netlist.py`; edit that script, not this file.

92 parts, 68 nets. DNP = not fitted by default.

## Nets

| Net | Pins |
|---|---|
| `+1V1` | C13.1, C14.1, C15.1, TP3.1 (1), U1.23 (DVDD), U1.45 (VREG_VOUT), U1.50 (DVDD) |
| `+3V3` | C3.1, C4.1, C5.1, C6.1, C7.1, C8.1, C9.1, C10.1, C11.1, C12.1, C18.1, C19.1, C20.1, C21.1, D3.2 (K), D4.2 (K), R10.1, R11.1, R12.1, TP2.1 (1), U1.1 (IOVDD), U1.10 (IOVDD), U1.22 (IOVDD), U1.33 (IOVDD), U1.42 (IOVDD), U1.43 (ADC_AVDD), U1.44 (VREG_IN), U1.48 (USB_VDD), U1.49 (IOVDD), U2.8 (VCC), U3.5 (VOUT), U5.6 (IOVDD), U5.26 (LDOIN/HPVDD), U5.30 (LDO_SELECT) |
| `BOOTSEL_SW` | R9.2, SW1.1 (1) |
| `CC1` | J1.A5 (CC1), R1.1 |
| `CC2` | J1.B5 (CC2), R2.1 |
| `CODEC_AVDD` | C22.1, C23.1, U5.24 (AVDD) |
| `CODEC_BCLK` | TP9.1 (1), U1.4 (GPIO2), U5.2 (BCLK) |
| `CODEC_DIN` | TP12.1 (1), U1.7 (GPIO5), U5.4 (DIN/MFP1) |
| `CODEC_DOUT` | TP11.1 (1), U1.6 (GPIO4), U5.5 (DOUT/MFP2) |
| `CODEC_DVDD` | C24.1, C25.1, U5.29 (DVDD) |
| `CODEC_IN13` | C28.2, U5.13 (IN1_L) |
| `CODEC_IN14` | C29.2, U5.14 (IN1_R) |
| `CODEC_IN16` | C30.2, U5.16 (IN2_R) |
| `CODEC_IN21` | C31.2, U5.21 (IN3_R) |
| `CODEC_IN_NC` | C32.1, U5.15 (IN2_L), U5.20 (IN3_L) |
| `CODEC_MCLK` | U1.32 (GPIO21), U5.1 (MCLK) |
| `CODEC_MFP5` | U1.12 (GPIO9), U5.32 (GPIO/MFP5) |
| `CODEC_REF` | C26.1, U5.18 (REF) |
| `CODEC_RESET_N` | R13.1, U1.11 (GPIO8), U5.31 (~{RESET}) |
| `CODEC_SCL` | R12.2, U1.9 (GPIO7), U5.9 (SCL/~{SS}) |
| `CODEC_SDA` | R11.2, U1.8 (GPIO6), U5.10 (SDA/MOSI) |
| `CODEC_WCLK` | TP10.1 (1), U1.5 (GPIO3), U5.3 (WCLK) |
| `GND` | C1.2, C2.2, C3.2, C4.2, C5.2, C6.2, C7.2, C8.2, C9.2, C10.2, C11.2, C12.2, C13.2, C14.2, C15.2, C16.2, C17.2, C18.2, C19.2, C20.2, C21.2, C22.2, C23.2, C24.2, C25.2, C26.2, C32.2, D1.2 (A), D3.1 (A), D4.1 (A), D5.1 (K), D6.1 (K), J1.A1 (GND), J1.A12 (GND), J1.B1 (GND), J1.B12 (GND), R1.2, R2.2, R3.2, R5.2, R13.2, SW1.2 (2), SW2.2 (2), TP4.1 (1), U1.19 (TESTEN), U1.57 (GND), U2.4 (GND), U3.2 (GND), U4.2 (GND), U5.7 (IOVSS), U5.8 (SCLK/MFP3), U5.12 (SPI_SELECT), U5.17 (AVSS), U5.28 (DVSS), U5.33 (EP), Y1.2 (2), Y1.4 (4) |
| `GP28` | TP8.1 (1), U1.40 (GPIO28_ADC2) |
| `HP_L` | R14.1, R16.1, U5.25 (HPL) |
| `HP_R` | R15.1, R17.1, U5.27 (HPR) |
| `LED_DATA` | R24.1, U1.35 (GPIO23) |
| `LED_DATA_A` | D6.2 (A), R24.2 |
| `LED_LINK` | R23.1, U1.34 (GPIO22) |
| `LED_LINK_A` | D5.2 (A), R23.2 |
| `LINE_BLK1` | C33.1, T1.7 (7) |
| `LINE_BLK2` | C34.2, T1.6 (6) |
| `LINE_BLKM` | C33.2, C34.1 |
| `LINE_RING` | FB2.1, J2.3 (RING), RV1.2 |
| `LINE_RING_X` | FB2.2, T1.5 (5) |
| `LINE_TIP` | F2.1, J2.4 (TIP) |
| `LINE_TIP_P` | F2.2, FB1.1, RV1.1 |
| `LINE_TIP_X` | FB1.2, T1.8 (8) |
| `MIX_13` | C28.1, R19.2 |
| `MIX_14` | C29.1, R20.2 |
| `MIX_16` | C30.1, R21.2 |
| `MIX_21` | C31.1, R22.2 |
| `QSPI_SCLK` | U1.52 (QSPI_SCLK), U2.6 (CLK) |
| `QSPI_SD0` | U1.53 (QSPI_SD0), U2.5 (DI/IO_{0}) |
| `QSPI_SD1` | U1.55 (QSPI_SD1), U2.2 (DO/IO_{1}) |
| `QSPI_SD2` | U1.54 (QSPI_SD2), U2.3 (~{WP}/IO_{2}) |
| `QSPI_SD3` | U1.51 (QSPI_SD3), U2.7 (~{HOLD}/~{RESET}/IO_{3}) |
| `QSPI_SS` | R9.1, U1.56 (QSPI_SS), U2.1 (~{CS}) |
| `REP_A` | R16.2, R18.1, R22.1 |
| `REP_B` | C27.2, R17.2, R20.1 |
| `REP_M` | C27.1, R18.2 |
| `RUN` | R10.2, SW2.1 (1), TP7.1 (1), U1.26 (RUN) |
| `SWCLK` | TP5.1 (1), U1.24 (SWCLK) |
| `SWDIO` | TP6.1 (1), U1.25 (SWD) |
| `USB_CONN_DM` | J1.A7 (D-), J1.B7 (D-), R7.1, U4.3 (I/O2), U4.4 (I/O2) |
| `USB_CONN_DP` | J1.A6 (D+), J1.B6 (D+), R6.1, U4.1 (I/O1), U4.6 (I/O1) |
| `USB_DM` | R7.2, U1.46 (USB_DM) |
| `USB_DP` | R6.2, U1.47 (USB_DP) |
| `USB_SHIELD` | C1.1, J1.S1 (SHIELD), R3.1 |
| `VBUS` | C2.1, D1.1 (K), F1.2, R4.1, TP1.1 (1), U3.1 (VIN), U3.3 (EN), U4.5 (VBUS) |
| `VBUS_IN` | F1.1, J1.A4 (VBUS), J1.A9 (VBUS), J1.B4 (VBUS), J1.B9 (VBUS) |
| `VBUS_SENSE` | R4.2, R5.1, U1.41 (GPIO29_ADC3) |
| `XF_A` | D2.1, D3.3 (K/A), R14.2, R19.1, T1.1 (1) |
| `XF_B` | D2.2, D4.3 (K/A), R15.2, R21.1, T1.4 (4) |
| `XF_MID` | T1.2 (2), T1.3 (3) |
| `XIN` | C16.1, U1.20 (XIN), Y1.1 (1) |
| `XOUT` | R8.1, U1.21 (XOUT) |
| `XTAL_OUT` | C17.1, R8.2, Y1.3 (3) |

## Parts

| Ref | Value | LCSC | Footprint | Note |
|---|---|---|---|---|
| C1 | 4.7nF | C1538 | `Capacitor_SMD:C_0402_1005Metric` | shell to GND, RF |
| C2 | 10uF | C19702 | `Capacitor_SMD:C_0603_1608Metric` | LDO input |
| C3 | 10uF | C19702 | `Capacitor_SMD:C_0603_1608Metric` | LDO output, 3V3 bulk |
| C4 | 100nF | C1525 | `Capacitor_SMD:C_0402_1005Metric` | IOVDD pin 1 |
| C5 | 100nF | C1525 | `Capacitor_SMD:C_0402_1005Metric` | IOVDD pin 10 |
| C6 | 100nF | C1525 | `Capacitor_SMD:C_0402_1005Metric` | IOVDD pin 22 |
| C7 | 100nF | C1525 | `Capacitor_SMD:C_0402_1005Metric` | IOVDD pin 33 |
| C8 | 100nF | C1525 | `Capacitor_SMD:C_0402_1005Metric` | IOVDD pin 42 |
| C9 | 100nF | C1525 | `Capacitor_SMD:C_0402_1005Metric` | IOVDD pin 49 |
| C10 | 100nF | C1525 | `Capacitor_SMD:C_0402_1005Metric` | USB_VDD |
| C11 | 100nF | C1525 | `Capacitor_SMD:C_0402_1005Metric` | ADC_AVDD |
| C12 | 1uF | C52923 | `Capacitor_SMD:C_0402_1005Metric` | VREG_VIN |
| C13 | 1uF | C52923 | `Capacitor_SMD:C_0402_1005Metric` | VREG_VOUT |
| C14 | 100nF | C1525 | `Capacitor_SMD:C_0402_1005Metric` | DVDD pin 23 |
| C15 | 100nF | C1525 | `Capacitor_SMD:C_0402_1005Metric` | DVDD pin 50 |
| C16 | 15pF | C1548 | `Capacitor_SMD:C_0402_1005Metric` | crystal load |
| C17 | 15pF | C1548 | `Capacitor_SMD:C_0402_1005Metric` | crystal load |
| C18 | 100nF | C1525 | `Capacitor_SMD:C_0402_1005Metric` | flash VCC |
| C19 | 100nF | C1525 | `Capacitor_SMD:C_0402_1005Metric` | codec IOVDD |
| C20 | 100nF | C1525 | `Capacitor_SMD:C_0402_1005Metric` | codec LDOIN |
| C21 | 10uF | C19702 | `Capacitor_SMD:C_0603_1608Metric` | codec LDOIN, headphone driver supply |
| C22 | 100nF | C1525 | `Capacitor_SMD:C_0402_1005Metric` | A-LDO output |
| C23 | 10uF | C19702 | `Capacitor_SMD:C_0603_1608Metric` | A-LDO output |
| C24 | 100nF | C1525 | `Capacitor_SMD:C_0402_1005Metric` | D-LDO output |
| C25 | 10uF | C19702 | `Capacitor_SMD:C_0603_1608Metric` | D-LDO output |
| C26 | 10uF | C19702 | `Capacitor_SMD:C_0603_1608Metric` | reference filter (datasheet 10.2.1.1) |
| C27 | 10nF C0G | C2971995 | `Capacitor_SMD:C_0805_2012Metric` | hybrid replica (cable C), tune per cable |
| C28 | 1uF | C52923 | `Capacitor_SMD:C_0402_1005Metric` | IN1_L: P, line +: AC coupling |
| C29 | 1uF | C52923 | `Capacitor_SMD:C_0402_1005Metric` | IN1_R: P, replica -: AC coupling |
| C30 | 1uF | C52923 | `Capacitor_SMD:C_0402_1005Metric` | IN2_R: M, line -: AC coupling |
| C31 | 1uF | C52923 | `Capacitor_SMD:C_0402_1005Metric` | IN3_R: M, replica +: AC coupling |
| C32 | 100nF | C1525 | `Capacitor_SMD:C_0402_1005Metric` | unused inputs (datasheet 10.2.2.1) |
| C33 | 1uF 250V | C381468 | `Capacitor_SMD:C_1812_4532Metric` | X7R, DC block (two in series) |
| C34 | 1uF 250V | C381468 | `Capacitor_SMD:C_1812_4532Metric` | X7R, DC block (two in series) |
| D1 | SMF5.0A | C151296 | `Diode_SMD:D_SOD-123F` | 5 V TVS, unidirectional |
| D2 | ESDSLC5V0LB | C2762104 | `Diode_SMD:D_0402_1005Metric` | 5 V bidirectional TVS, 0.8 pF, DFN1006 |
| D3 | BAV99 | C2500 | `Package_TO_SOT_SMD:SOT-23` | two diodes in series, clamp to 3.3 V and ground |
| D4 | BAV99 | C2500 | `Package_TO_SOT_SMD:SOT-23` | two diodes in series, clamp to 3.3 V and ground |
| D5 | LED_LINK | C2286 | `LED_SMD:LED_0603_1608Metric` | LINK status LED |
| D6 | LED_DATA | C2286 | `LED_SMD:LED_0603_1608Metric` | DATA status LED |
| F1 | 0.5A | C163512 | `Fuse:Fuse_1206_3216Metric` | Littelfuse 1206L050YR PTC |
| F2 | 1.25A | C99554 | `pico-serial:Fuse_Littelfuse_0461` | Littelfuse TeleLink 04611.25ER, 600 V |
| FB1 | 600R@100MHz | C19330 | `Inductor_SMD:L_0603_1608Metric` | Murata BLM18AG601SN1D, 200 mA |
| FB2 | 600R@100MHz | C19330 | `Inductor_SMD:L_0603_1608Metric` | Murata BLM18AG601SN1D, 200 mA |
| J1 | USB_C | C165948 | `Connector_USB:USB_C_Receptacle_HRO_TYPE-C-31-M-12` | HRO TYPE-C-31-M-12 |
| J2 | RJ11 | C189750 | `pico-serial:RJ11_Ckmtw_R-RJ11R06P-A800` | Ckmtw R-RJ11R06P-A800, 6P6C right angle; hand-soldered |
| R1 | 5.1k | C25905 | `Resistor_SMD:R_0402_1005Metric` | CC1 Rd: separate resistor per CC pin |
| R2 | 5.1k | C25905 | `Resistor_SMD:R_0402_1005Metric` | CC2 Rd |
| R3 | 1M | C26083 | `Resistor_SMD:R_0402_1005Metric` | shell bleed |
| R4 | 100k | C25741 | `Resistor_SMD:R_0402_1005Metric` | VBUS divider top |
| R5 | 100k | C25741 | `Resistor_SMD:R_0402_1005Metric` | VBUS divider bottom |
| R6 | 27R | C25100 | `Resistor_SMD:R_0402_1005Metric` | USB D+ series |
| R7 | 27R | C25100 | `Resistor_SMD:R_0402_1005Metric` | USB D- series |
| R8 | 1k | C11702 | `Resistor_SMD:R_0402_1005Metric` | crystal drive limit |
| R9 | 1k | C11702 | `Resistor_SMD:R_0402_1005Metric` | BOOTSEL |
| R10 | 10k | C25744 | `Resistor_SMD:R_0402_1005Metric` | RUN pull-up; RP2040 has a weak internal one, this adds noise margin |
| R11 | 4.7k | C25900 | `Resistor_SMD:R_0402_1005Metric` | I2C pull-up |
| R12 | 4.7k | C25900 | `Resistor_SMD:R_0402_1005Metric` | I2C pull-up |
| R13 | 10k | C25744 | `Resistor_SMD:R_0402_1005Metric` | codec held in reset until the firmware starts |
| R14 | 60.4R | C2933247 | `Resistor_SMD:R_0603_1608Metric` | 1%, line drive |
| R15 | 60.4R | C2933247 | `Resistor_SMD:R_0603_1608Metric` | 1%, line drive |
| R16 | 604R | C32183 | `Resistor_SMD:R_0603_1608Metric` | 1%, hybrid replica |
| R17 | 604R | C32183 | `Resistor_SMD:R_0603_1608Metric` | 1%, hybrid replica |
| R18 | 1.21k | C22835 | `Resistor_SMD:R_0603_1608Metric` | 1%, hybrid replica (cable R) |
| R19 | 1k | C11702 | `Resistor_SMD:R_0402_1005Metric` | IN1_L: P, line +: input series R |
| R20 | 1k | C11702 | `Resistor_SMD:R_0402_1005Metric` | IN1_R: P, replica -: input series R |
| R21 | 1k | C11702 | `Resistor_SMD:R_0402_1005Metric` | IN2_R: M, line -: input series R |
| R22 | 1k | C11702 | `Resistor_SMD:R_0402_1005Metric` | IN3_R: M, replica +: input series R |
| R23 | 1k | C11702 | `Resistor_SMD:R_0402_1005Metric` | LINK LED current |
| R24 | 1k | C11702 | `Resistor_SMD:R_0402_1005Metric` | DATA LED current |
| RV1 | P3100SC | C151191 | `Diode_SMD:D_SMB` | Littelfuse P3100SCLRP, 275 V, 250 A 8/20 |
| SW1 | BOOTSEL | C720477 | `Button_Switch_SMD:SW_SPST_TS-1088-xR020` | XUNPU TS-1088-AR02016 |
| SW2 | RESET | C720477 | `Button_Switch_SMD:SW_SPST_TS-1088-xR020` | XUNPU TS-1088-AR02016 |
| T1 | PE-65848NL | C7261159 | `pico-serial:Pulse_PE-65848` | Pulse PE-65848NLT line transformer, 1500 Vrms |
| TP1 | VBUS |  | `TestPoint:TestPoint_Pad_D1.0mm` |  |
| TP2 | 3V3 |  | `TestPoint:TestPoint_Pad_D1.0mm` |  |
| TP3 | 1V1 |  | `TestPoint:TestPoint_Pad_D1.0mm` |  |
| TP4 | GND |  | `TestPoint:TestPoint_Pad_D1.0mm` |  |
| TP5 | SWCLK |  | `TestPoint:TestPoint_Pad_D1.0mm` |  |
| TP6 | SWDIO |  | `TestPoint:TestPoint_Pad_D1.0mm` |  |
| TP7 | RUN |  | `TestPoint:TestPoint_Pad_D1.0mm` |  |
| TP8 | GP28 |  | `TestPoint:TestPoint_Pad_D1.0mm` |  |
| TP9 | BCLK |  | `TestPoint:TestPoint_Pad_D1.0mm` |  |
| TP10 | WCLK |  | `TestPoint:TestPoint_Pad_D1.0mm` |  |
| TP11 | DOUT |  | `TestPoint:TestPoint_Pad_D1.0mm` |  |
| TP12 | DIN |  | `TestPoint:TestPoint_Pad_D1.0mm` |  |
| U1 | RP2040 | C2040 | `Package_DFN_QFN:QFN-56-1EP_7x7mm_P0.4mm_EP3.2x3.2mm` |  |
| U2 | W25Q128JVS | C97521 | `Package_SO:SOIC-8_5.3x5.3mm_P1.27mm` |  |
| U3 | AP2112K-3.3 | C51118 | `Package_TO_SOT_SMD:SOT-23-5` |  |
| U4 | USBLC6-2SC6 | C7519 | `Package_TO_SOT_SMD:SOT-23-6` |  |
| U5 | TLV320AIC3204 | C24109 | `Package_DFN_QFN:QFN-32-1EP_5x5mm_P0.5mm_EP3.45x3.45mm` | TI TLV320AIC3204IRHBR stereo codec, 96 kHz |
| Y1 | 12MHz | C20625731 | `Crystal:Crystal_SMD_3225-4Pin_3.2x2.5mm` | Abracon ABM8-272-T3 |

## Not connected (on purpose)

- J1.A8 (SBU1)
- J1.B8 (SBU2)
- J2.1 (1)
- J2.2 (2)
- J2.5 (5)
- J2.6 (6)
- U1.2 (GPIO0)
- U1.3 (GPIO1)
- U1.13 (GPIO10)
- U1.14 (GPIO11)
- U1.15 (GPIO12)
- U1.16 (GPIO13)
- U1.17 (GPIO14)
- U1.18 (GPIO15)
- U1.27 (GPIO16)
- U1.28 (GPIO17)
- U1.29 (GPIO18)
- U1.30 (GPIO19)
- U1.31 (GPIO20)
- U1.36 (GPIO24)
- U1.37 (GPIO25)
- U1.38 (GPIO26_ADC0)
- U1.39 (GPIO27_ADC1)
- U3.4 (NC)
- U5.11 (MISO/MFP4)
- U5.19 (MICBIAS)
- U5.22 (LOL)
- U5.23 (LOR)
