D-Modem/hardware/hardware/enclosure/out-wb/placement.md

<!-- SPDX-License-Identifier: CERN-OHL-S-2.0 -->
<!-- Copyright (C) 2026 D-Modem Authors -->
# pico-serial WB: placement fixed by the stick

Generated by `stick.py`. Coordinates in mm; x = 0 at the RJ11 end's outer face, +x toward the USB-C end; y = 0 on the centre line. Board top = the side facing the top half.

| Item | Position | Notes |
|---|---|---|
| Board outline | `board-outline.dxf` | x 1.8–80.2, y ±10.3 |
| RJ11 (top) | opening at x = 0.0, rear contact row at x = 17.42, centred y = 0 | Ckmtw R-RJ11R06P-A800, opening flush with the end face |
| USB-C (top) | mouth at x = 80.9, centred y = 0 | overhangs the board edge by 0.7; 1.1 inside the end face, in a 13.2 × 7.6 opening |
| Screw holes, Ø2.3, no copper within Ø5.4 | (48.8, -6.4) | M2 × 8 self-tapping, from below |
| LEDs, 0603 (top) | LINK (44.3, 8.6), DATA (44.3, -8.6) | under light tubes |
| Isolation gap | across x 24.8–28.8 | line side toward the RJ11, USB side beyond |
| Height limits | top ≤ 13.0 mm, bottom ≤ 1.9 mm (through-hole pins trimmed) | |
