D-Modem/hardware/hardware/netlist/bom-jlc-wb.csv

Comment | Designator | Footprint | LCSC Part #
4.7nF | C1 | C_0402_1005Metric | C1538
10uF | C2,C3,C21,C23,C25,C26 | C_0603_1608Metric | C19702
100nF | C4,C5,C6,C7,C8,C9,C10,C11,C14,C15,C18,C19,C20,C22,C24,C32 | C_0402_1005Metric | C1525
1uF | C12,C13,C28,C29,C30,C31 | C_0402_1005Metric | C52923
15pF | C16,C17 | C_0402_1005Metric | C1548
10nF C0G | C27 | C_0805_2012Metric | C2971995
1uF 250V | C33,C34 | C_1812_4532Metric | C381468
SMF5.0A | D1 | D_SOD-123F | C151296
ESDSLC5V0LB | D2 | D_0402_1005Metric | C2762104
BAV99 | D3,D4 | SOT-23 | C2500
LED_LINK | D5 | LED_0603_1608Metric | C2286
LED_DATA | D6 | LED_0603_1608Metric | C2286
0.5A | F1 | Fuse_1206_3216Metric | C163512
1.25A | F2 | Fuse_Littelfuse_0461 | C99554
600R@100MHz | FB1,FB2 | L_0603_1608Metric | C19330
USB_C | J1 | USB_C_Receptacle_HRO_TYPE-C-31-M-12 | C165948
5.1k | R1,R2 | R_0402_1005Metric | C25905
1M | R3 | R_0402_1005Metric | C26083
100k | R4,R5 | R_0402_1005Metric | C25741
27R | R6,R7 | R_0402_1005Metric | C25100
1k | R8,R9,R19,R20,R21,R22,R23,R24 | R_0402_1005Metric | C11702
10k | R10,R13 | R_0402_1005Metric | C25744
4.7k | R11,R12 | R_0402_1005Metric | C25900
60.4R | R14,R15 | R_0603_1608Metric | C2933247
604R | R16,R17 | R_0603_1608Metric | C32183
1.21k | R18 | R_0603_1608Metric | C22835
P3100SC | RV1 | D_SMB | C151191
BOOTSEL | SW1 | SW_SPST_TS-1088-xR020 | C720477
RESET | SW2 | SW_SPST_TS-1088-xR020 | C720477
PE-65848NL | T1 | Pulse_PE-65848 | C7261159
RP2040 | U1 | QFN-56-1EP_7x7mm_P0.4mm_EP3.2x3.2mm | C2040
W25Q128JVS | U2 | SOIC-8_5.3x5.3mm_P1.27mm | C97521
AP2112K-3.3 | U3 | SOT-23-5 | C51118
USBLC6-2SC6 | U4 | SOT-23-6 | C7519
TLV320AIC3204 | U5 | QFN-32-1EP_5x5mm_P0.5mm_EP3.45x3.45mm | C24109
12MHz | Y1 | Crystal_SMD_3225-4Pin_3.2x2.5mm | C20625731
