D-Modem/hardware/hardware/enclosure/out-line/assembly.step

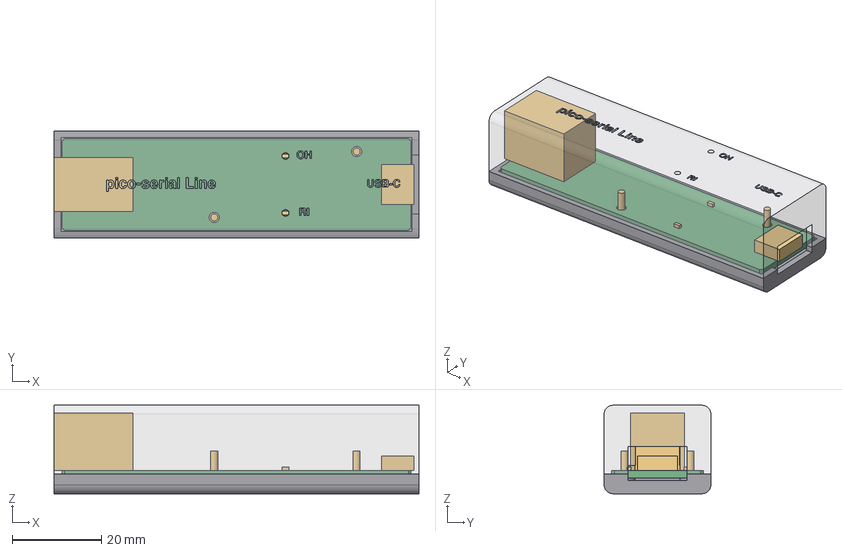
[picture p10: CAD file, 2026-10-22]
hardware/enclosure/out-line/assembly.step
82.0 x 24.0 x 19.9 mm
stick-bottom
stick-top
pcb
rj11
usb
led_OH
led_RI
M2_screw_1
M2_screw_2
