D-Modem/hardware/hardware/enclosure/out/assembly.step

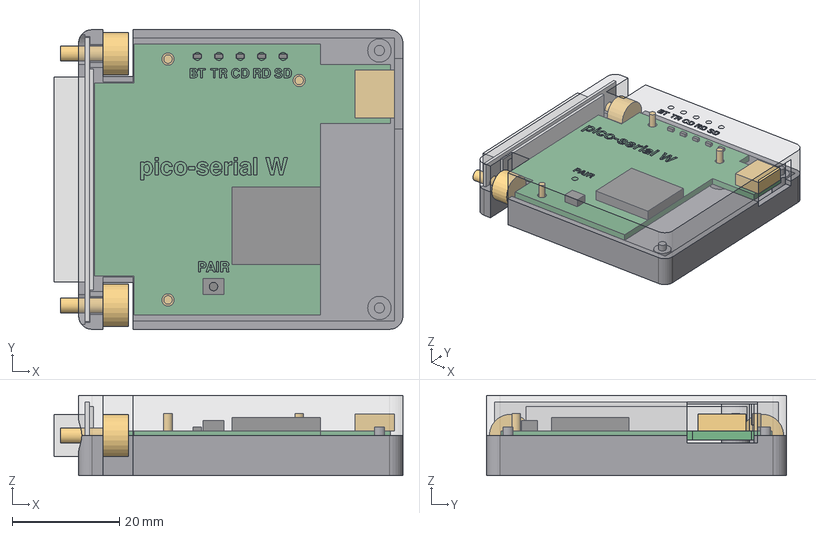
[picture p11: CAD file, 2026-10-18]
hardware/enclosure/out/assembly.step
65.2 x 56.0 x 15.0 mm
hood-bottom
hood-top
pcb
db25
rm2
usb
led_BT
led_TR
led_CD
led_RD
led_SD
pair_button
thumbscrew_m1
thumbscrew_p1
M2_screw_1
M2_screw_2
M2_screw_3
