D-Modem/hardware/hardware/enclosure/out/rf-keepout.dxf

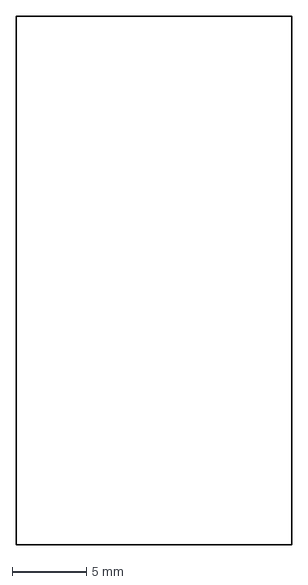
[picture p12: CAD file, 2026-10-18]
hardware/enclosure/out/rf-keepout.dxf
18.5 x 35.5 mm
