D-Modem/hardware/hardware/enclosure/out-line/stick-top.step

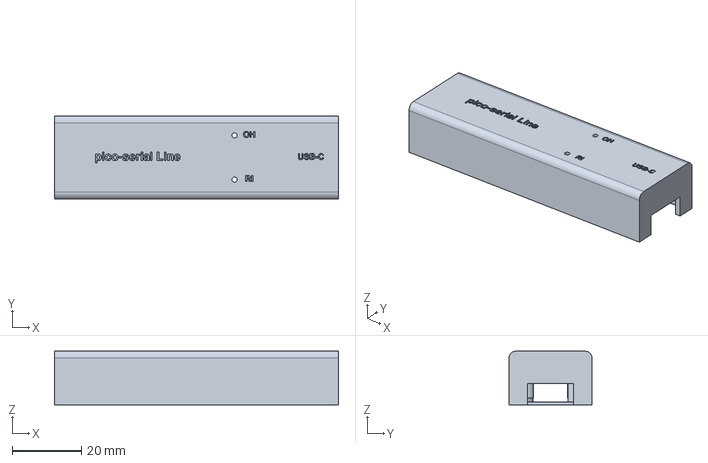
[picture p13: CAD file, 2026-10-22]
hardware/enclosure/out-line/stick-top.step
82.0 x 24.0 x 15.5 mm
