D-Modem/hardware/hardware/enclosure/out-wb/board-outline.dxf

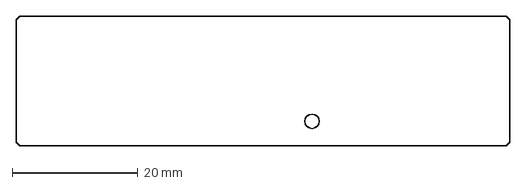
[picture p14: CAD file, 2026-10-27]
hardware/enclosure/out-wb/board-outline.dxf
78.4 x 20.6 mm
