D-Modem/hardware/hardware/enclosure/out/hood-bottom.step

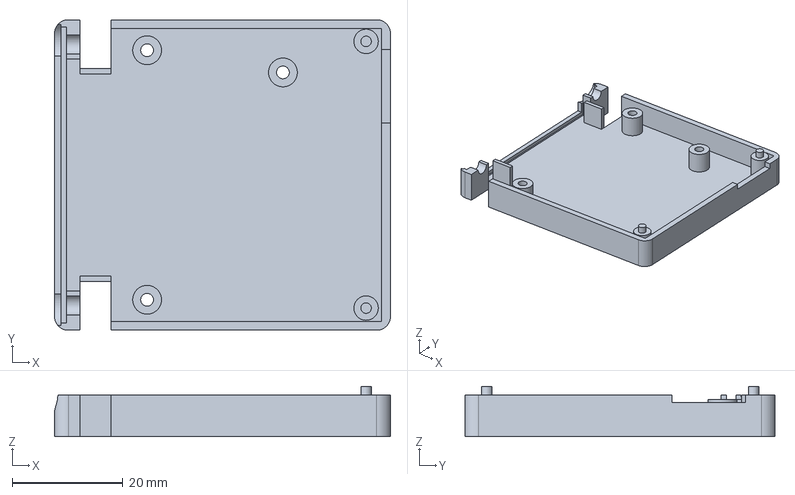
[picture p15: CAD file, 2026-10-18]
hardware/enclosure/out/hood-bottom.step
60.6 x 56.0 x 9.10 mm
