D-Modem/hardware/hardware/enclosure/out-line/board-outline.dxf

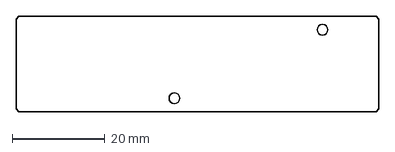
[picture p16: CAD file, 2026-10-22]
hardware/enclosure/out-line/board-outline.dxf
78.4 x 20.6 mm
