D-Modem/hardware/hardware/enclosure/out-line/stick-bottom.step

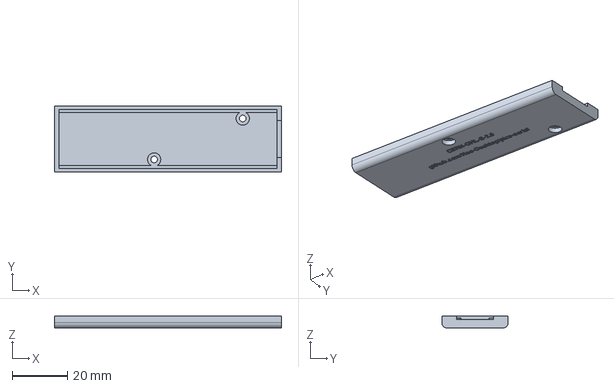
[picture p17: CAD file, 2026-10-22]
hardware/enclosure/out-line/stick-bottom.step
82.0 x 24.0 x 4.40 mm
