D-Modem/hardware/hardware/enclosure/out/board-outline.dxf

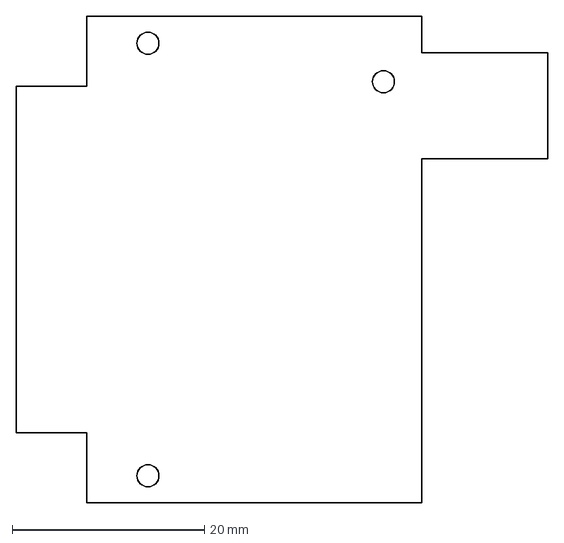
[picture p18: CAD file, 2026-10-18]
hardware/enclosure/out/board-outline.dxf
55.3 x 50.6 mm
