D-Modem/hardware/hardware/enclosure/out/hood-top.step

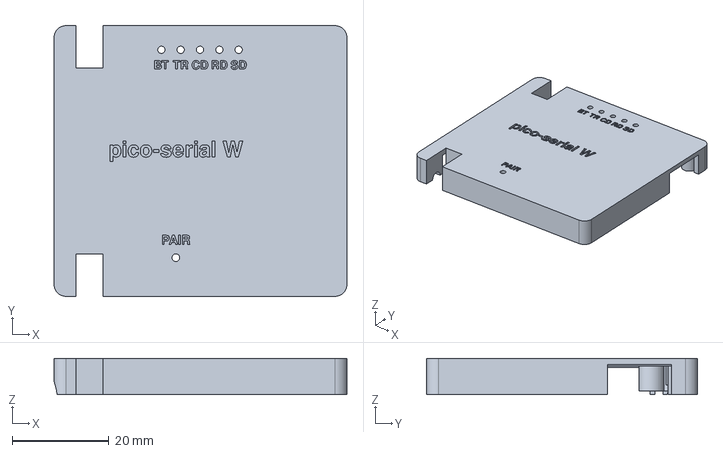
[picture p19: CAD file, 2026-10-18]
hardware/enclosure/out/hood-top.step
60.6 x 56.0 x 7.50 mm
