D-Modem/hardware/(list of files, cad)

Other CAD files:
hardware/enclosure/out-wb/assembly.step
hardware/enclosure/out-wb/stick-top.step
hardware/enclosure/out-wb/stick-bottom.step
hardware/enclosure/out-line/stick-bottom.stl
hardware/enclosure/out-line/stick-top.stl
hardware/enclosure/out-wb/stick-bottom.stl
hardware/enclosure/out-wb/stick-top.stl
hardware/enclosure/out/hood-bottom.stl
hardware/enclosure/out/hood-top.stl
