D-Modem/hardware/hardware/kicad/pico-serial.kicad_pcb

## KiCad design hardware/kicad/pico-serial.kicad_pcb (2026-10-29)

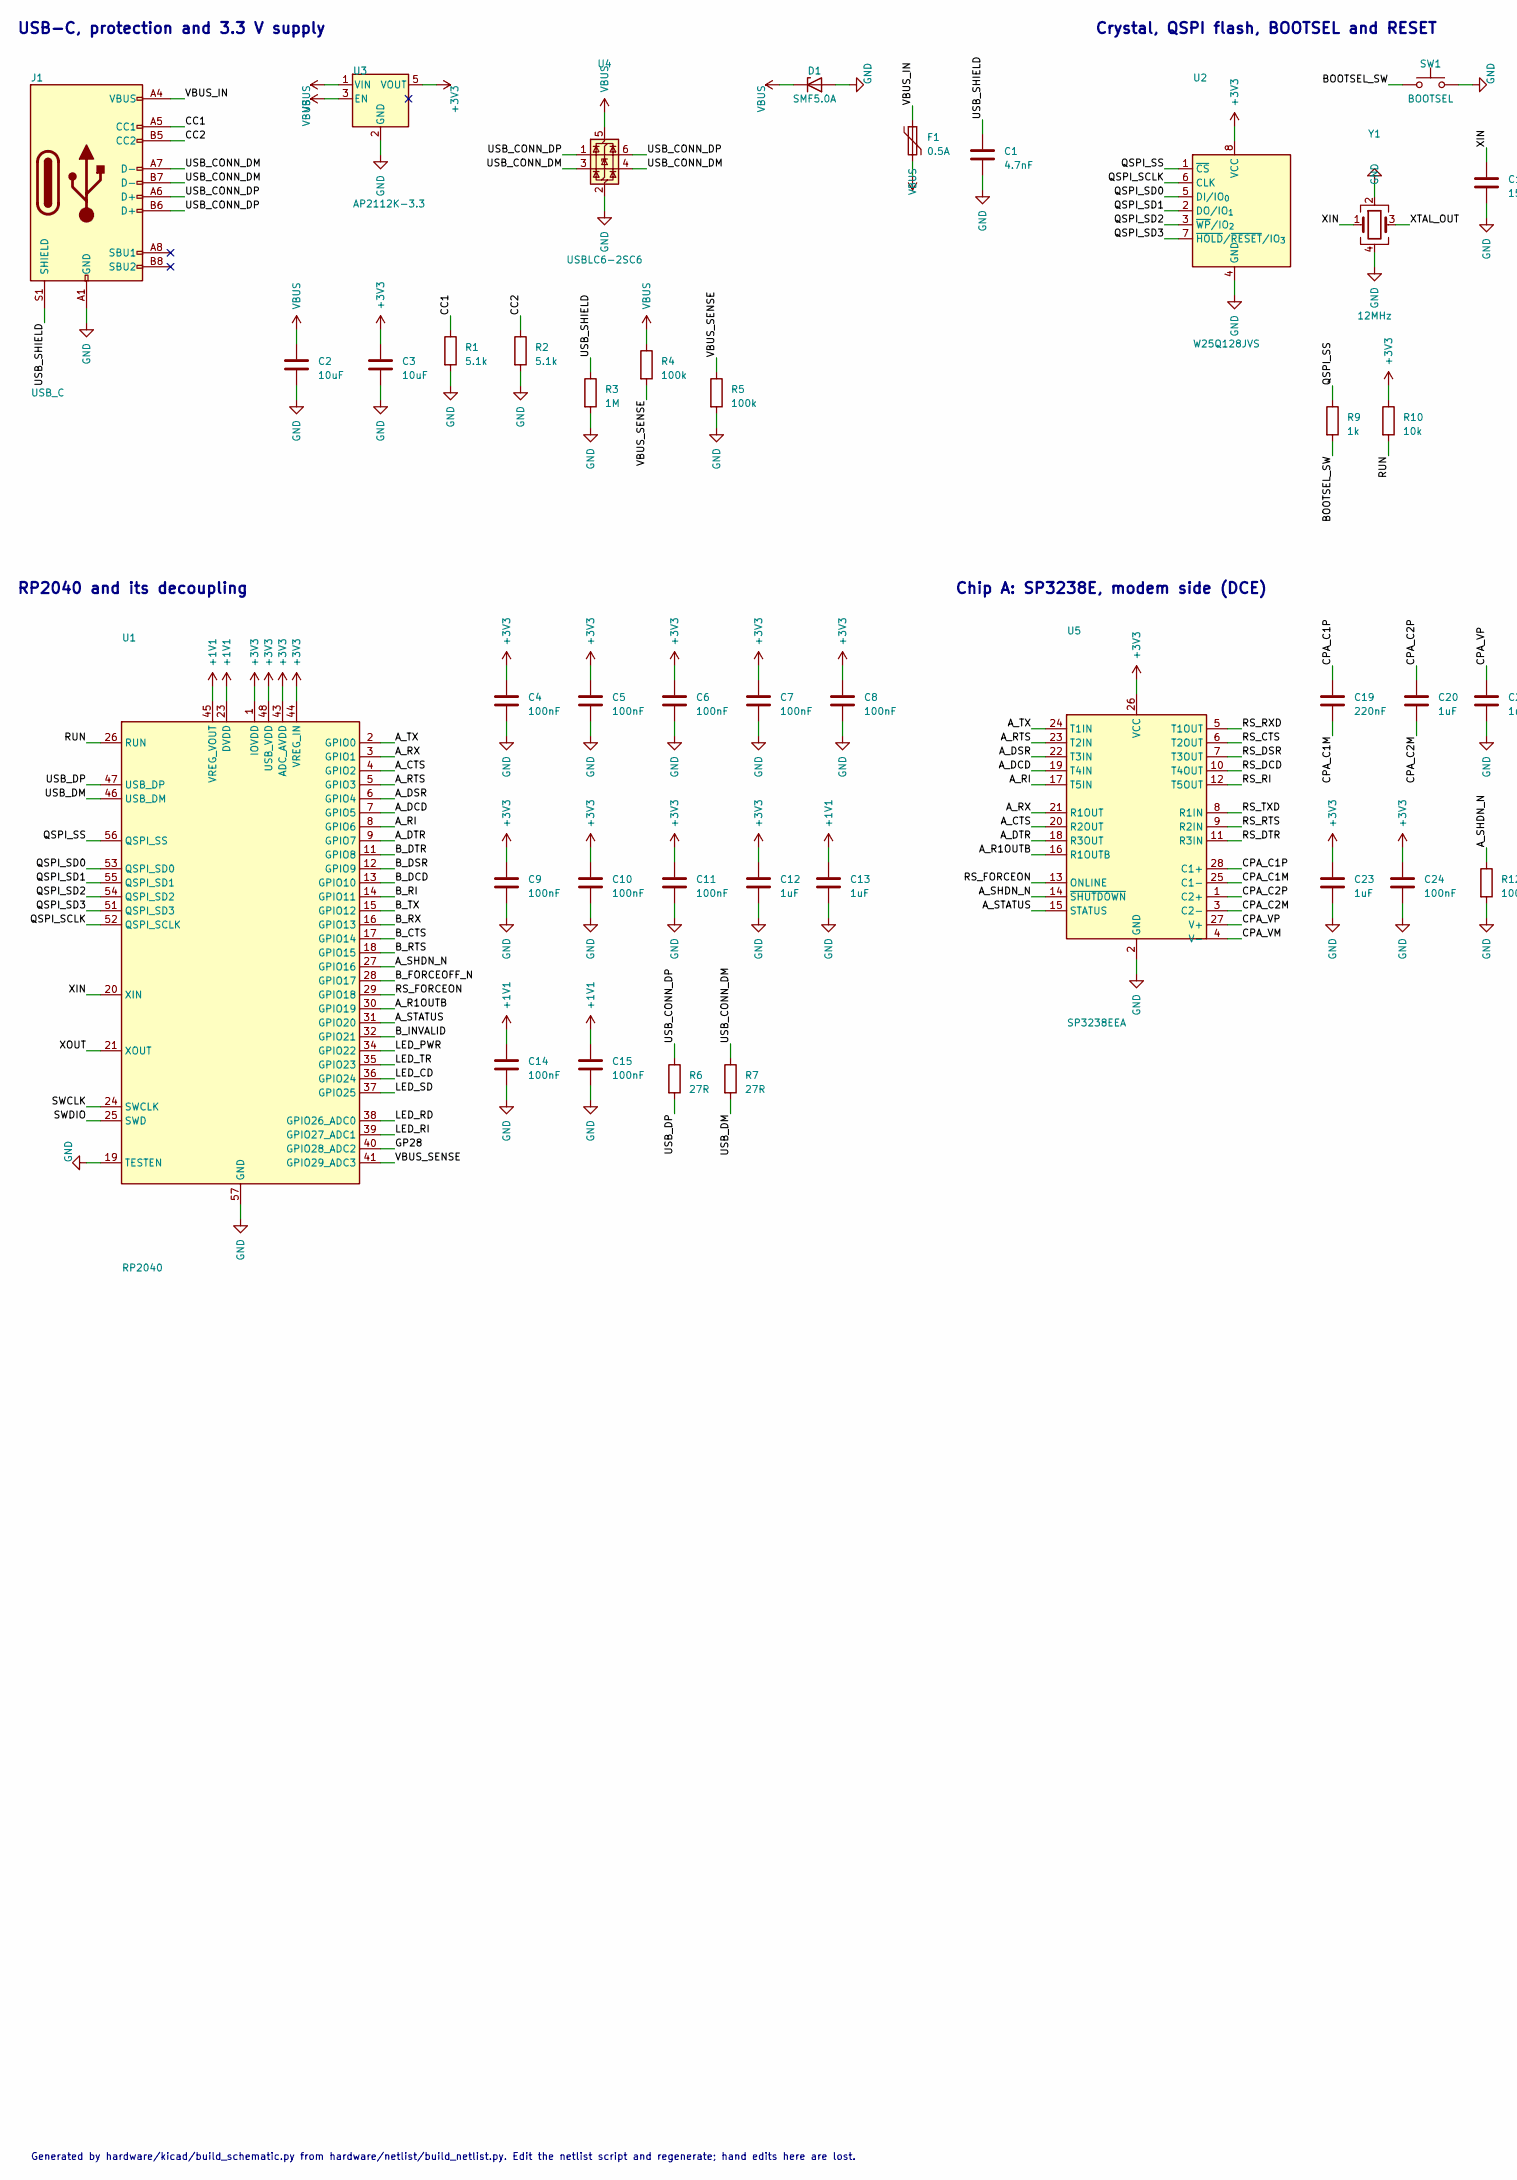
[picture p20: schematic pico-serial.kicad_sch, pico-serial: USB-C to DB25 RS-232 (DCE/DTE), part in row 1, column 1]

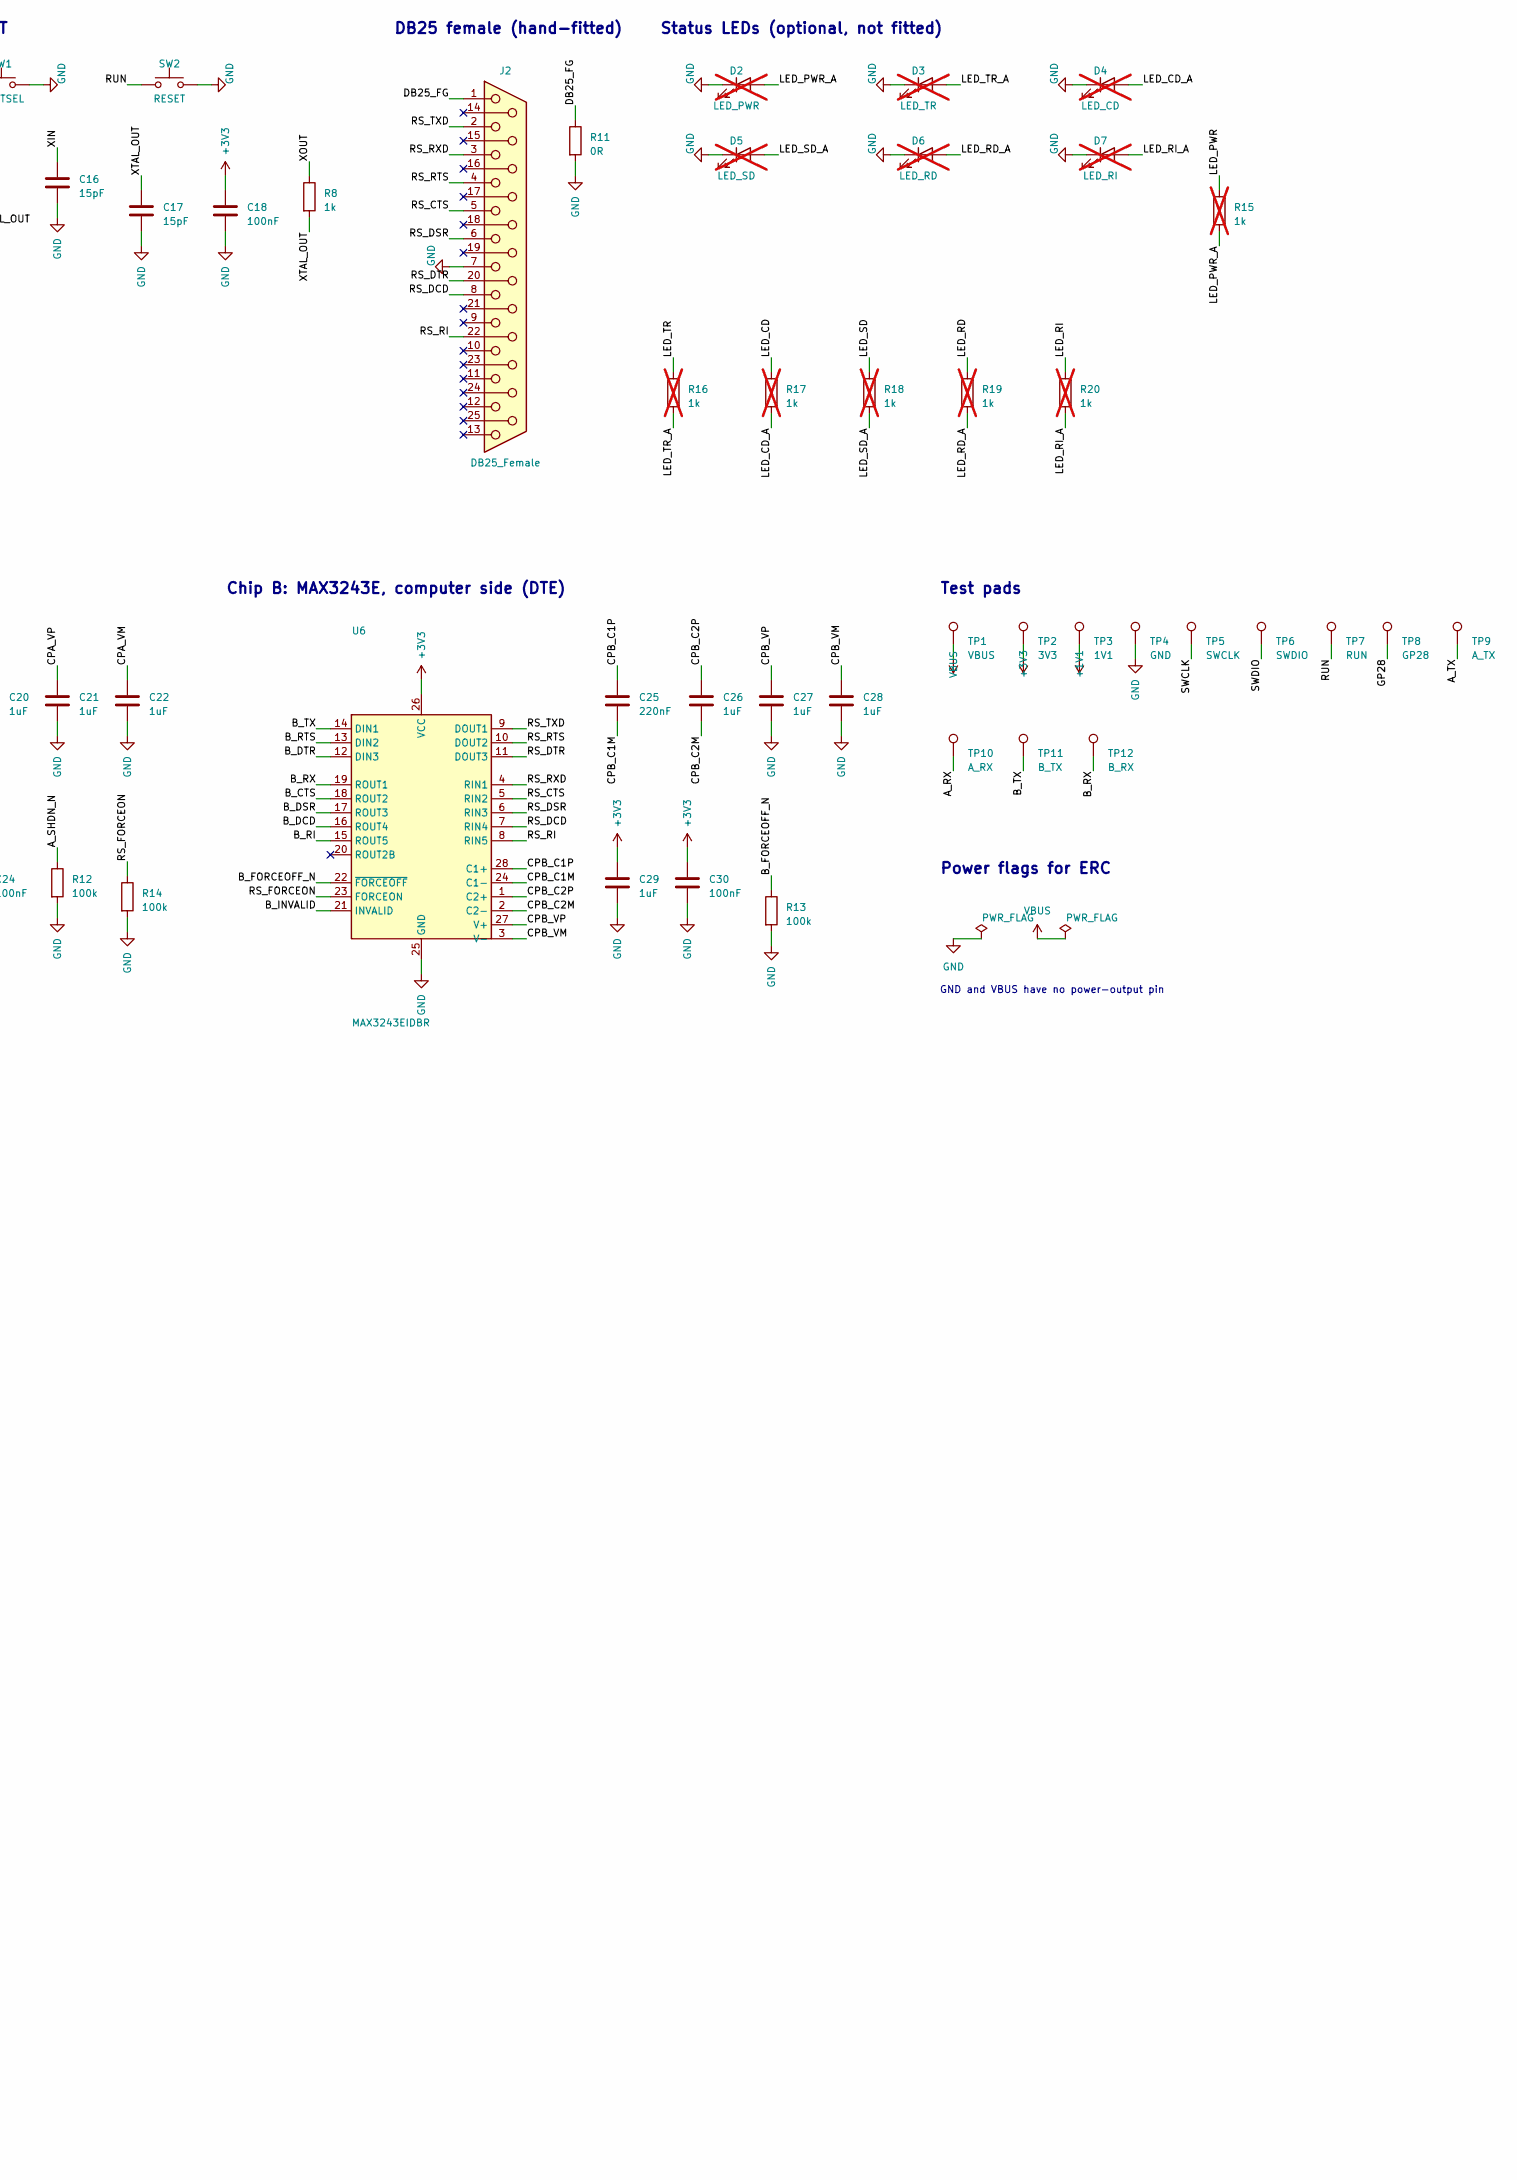
[picture p21: schematic pico-serial.kicad_sch, pico-serial: USB-C to DB25 RS-232 (DCE/DTE), part in row 1, column 2]

Parts:
C1: 4.7nF; C_0402_1005Metric; LCSC C1538
C2, C3: 10uF; C_0603_1608Metric; LCSC C19702
C4, C5, C6, C7, C8, C9, C10, C11, C14, C15, C18, C24, C30: 100nF; C_0402_1005Metric; LCSC C1525
C12, C13, C23, C29: 1uF; C_0402_1005Metric; LCSC C52923
C16, C17: 15pF; C_0402_1005Metric; LCSC C1548
C19, C25: 220nF; C_0402_1005Metric; LCSC C16772
C20, C21, C22, C26, C27, C28: 1uF; C_0603_1608Metric; LCSC C15849
D1: SMF5.0A; D_SOD-123F; LCSC C151296
D2: LED_PWR; LED_0603_1608Metric; LCSC C2286; not fitted
D3: LED_TR; LED_0603_1608Metric; LCSC C2286; not fitted
D4: LED_CD; LED_0603_1608Metric; LCSC C2286; not fitted
D5: LED_SD; LED_0603_1608Metric; LCSC C2286; not fitted
D6: LED_RD; LED_0603_1608Metric; LCSC C2286; not fitted
D7: LED_RI; LED_0603_1608Metric; LCSC C2286; not fitted
F1: 0.5A; Fuse_1206_3216Metric; LCSC C163512
J1: USB_C; USB_C_Receptacle_HRO_TYPE-C-31-M-12; LCSC C165948
J2: DB25_Female; DSUB-25_Socket_EdgeMount_P2.77mm; LCSC C19601171
R1, R2: 5.1k; R_0402_1005Metric; LCSC C25905
R3: 1M; R_0402_1005Metric; LCSC C26083
R4, R5, R12, R13, R14: 100k; R_0402_1005Metric; LCSC C25741
R6, R7: 27R; R_0402_1005Metric; LCSC C25100
R8, R9: 1k; R_0402_1005Metric; LCSC C11702
R10: 10k; R_0402_1005Metric; LCSC C25744
R11: 0R; R_0402_1005Metric; LCSC C17168
R15, R16, R17, R18, R19, R20: 1k; R_0402_1005Metric; LCSC C11702; not fitted
SW1: BOOTSEL; SW_SPST_TS-1088-xR020; LCSC C720477
SW2: RESET; SW_SPST_TS-1088-xR020; LCSC C720477
TP1: VBUS; TestPoint_Pad_D1.0mm
TP2: 3V3; TestPoint_Pad_D1.0mm
TP3: 1V1; TestPoint_Pad_D1.0mm
TP4: GND; TestPoint_Pad_D1.0mm
TP5: SWCLK; TestPoint_Pad_D1.0mm
TP6: SWDIO; TestPoint_Pad_D1.0mm
TP7: RUN; TestPoint_Pad_D1.0mm
TP8: GP28; TestPoint_Pad_D1.0mm
TP9: A_TX; TestPoint_Pad_D1.0mm
TP10: A_RX; TestPoint_Pad_D1.0mm
TP11: B_TX; TestPoint_Pad_D1.0mm
TP12: B_RX; TestPoint_Pad_D1.0mm
U1: RP2040; QFN-56-1EP_7x7mm_P0.4mm_EP3.2x3.2mm; LCSC C2040
U2: W25Q128JVS; SOIC-8_5.3x5.3mm_P1.27mm; LCSC C97521
U3: AP2112K-3.3; SOT-23-5; LCSC C51118
U4: USBLC6-2SC6; SOT-23-6; LCSC C7519
U5: SP3238EEA; SSOP-28_5.3x10.2mm_P0.65mm; LCSC C49669
U6: MAX3243EIDBR; SSOP-28_5.3x10.2mm_P0.65mm; LCSC C353887
Y1: 12MHz; Crystal_SMD_3225-4Pin_3.2x2.5mm; LCSC C20625731

Connections:
+1V1: C13.1, C14.1, C15.1, TP3.1, U1.23 (DVDD), U1.45 (VREG_VOUT), U1.50 (DVDD)
+3V3: C3.1, C4.1, C5.1, C6.1, C7.1, C8.1, C9.1, C10.1, C11.1, C12.1, C18.1, C23.1, C24.1, C29.1, C30.1, R10.1, TP2.1, U1.1 (IOVDD), U1.10 (IOVDD), U1.22 (IOVDD), U1.33 (IOVDD), U1.42 (IOVDD), U1.43 (ADC_AVDD), U1.44 (VREG_IN), U1.48 (USB_VDD), U1.49 (IOVDD), U2.8 (VCC), U3.5 (VOUT), U5.26 (VCC), U6.26 (VCC)
/A_CTS: U1.4 (GPIO2), U5.20 (R2OUT)
/A_DCD: U1.7 (GPIO5), U5.19 (T4IN)
/A_DSR: U1.6 (GPIO4), U5.22 (T3IN)
/A_DTR: U1.9 (GPIO7), U5.18 (R3OUT)
/A_R1OUTB: U1.30 (GPIO19), U5.16 (R1OUTB)
/A_RI: U1.8 (GPIO6), U5.17 (T5IN)
/A_RTS: U1.5 (GPIO3), U5.23 (T2IN)
/A_RX: TP10.1, U1.3 (GPIO1), U5.21 (R1OUT)
/A_SHDN_N: R12.1, U1.27 (GPIO16), U5.14 (~SHUTDOWN)
/A_STATUS: U1.31 (GPIO20), U5.15 (STATUS)
/A_TX: TP9.1, U1.2 (GPIO0), U5.24 (T1IN)
/BOOTSEL_SW: R9.2, SW1.1
/B_CTS: U1.17 (GPIO14), U6.18 (ROUT2)
/B_DCD: U1.13 (GPIO10), U6.16 (ROUT4)
/B_DSR: U1.12 (GPIO9), U6.17 (ROUT3)
/B_DTR: U1.11 (GPIO8), U6.12 (DIN3)
/B_FORCEOFF_N: R13.1, U1.28 (GPIO17), U6.22 (~FORCEOFF)
/B_INVALID: U1.32 (GPIO21), U6.21 (INVALID)
/B_RI: U1.14 (GPIO11), U6.15 (ROUT5)
/B_RTS: U1.18 (GPIO15), U6.13 (DIN2)
/B_RX: TP12.1, U1.16 (GPIO13), U6.19 (ROUT1)
/B_TX: TP11.1, U1.15 (GPIO12), U6.14 (DIN1)
/CC1: J1.A5 (CC1), R1.1
/CC2: J1.B5 (CC2), R2.1
/CPA_C1M: C19.2, U5.25 (C1-)
/CPA_C1P: C19.1, U5.28 (C1+)
/CPA_C2M: C20.2, U5.3 (C2-)
/CPA_C2P: C20.1, U5.1 (C2+)
/CPA_VM: C22.1, U5.4 (V-)
/CPA_VP: C21.1, U5.27 (V+)
/CPB_C1M: C25.2, U6.24 (C1-)
/CPB_C1P: C25.1, U6.28 (C1+)
/CPB_C2M: C26.2, U6.2 (C2-)
/CPB_C2P: C26.1, U6.1 (C2+)
/CPB_VM: C28.1, U6.3 (V-)
/CPB_VP: C27.1, U6.27 (V+)
/DB25_FG: J2.1, R11.1
/GP28: TP8.1, U1.40 (GPIO28_ADC2)
/LED_CD: R17.1, U1.36 (GPIO24)
/LED_CD_A: D4.2 (A), R17.2
/LED_PWR: R15.1, U1.34 (GPIO22)
/LED_PWR_A: D2.2 (A), R15.2
/LED_RD: R19.1, U1.38 (GPIO26_ADC0)
/LED_RD_A: D6.2 (A), R19.2
/LED_RI: R20.1, U1.39 (GPIO27_ADC1)
/LED_RI_A: D7.2 (A), R20.2
/LED_SD: R18.1, U1.37 (GPIO25)
/LED_SD_A: D5.2 (A), R18.2
/LED_TR: R16.1, U1.35 (GPIO23)
/LED_TR_A: D3.2 (A), R16.2
/QSPI_SCLK: U1.52 (QSPI_SCLK), U2.6 (CLK)
/QSPI_SD0: U1.53 (QSPI_SD0), U2.5 (DI/IO_{0})
/QSPI_SD1: U1.55 (QSPI_SD1), U2.2 (DO/IO_{1})
/QSPI_SD2: U1.54 (QSPI_SD2), U2.3 (~WP/IO_{2})
/QSPI_SD3: U1.51 (QSPI_SD3), U2.7 (~HOLD/~RESET/IO_{3})
/QSPI_SS: R9.1, U1.56 (QSPI_SS), U2.1 (~CS)
/RS_CTS: J2.5, U5.6 (T2OUT), U6.5 (RIN2)
/RS_DCD: J2.8, U5.10 (T4OUT), U6.7 (RIN4)
/RS_DSR: J2.6, U5.7 (T3OUT), U6.6 (RIN3)
/RS_DTR: J2.20, U5.11 (R3IN), U6.11 (DOUT3)
/RS_FORCEON: R14.1, U1.29 (GPIO18), U5.13 (ONLINE), U6.23 (FORCEON)
/RS_RI: J2.22, U5.12 (T5OUT), U6.8 (RIN5)
/RS_RTS: J2.4, U5.9 (R2IN), U6.10 (DOUT2)
/RS_RXD: J2.3, U5.5 (T1OUT), U6.4 (RIN1)
/RS_TXD: J2.2, U5.8 (R1IN), U6.9 (DOUT1)
/RUN: R10.2, SW2.1, TP7.1, U1.26 (RUN)
/SWCLK: TP5.1, U1.24 (SWCLK)
/SWDIO: TP6.1, U1.25 (SWD)
/USB_CONN_DM: J1.A7 (D-), J1.B7 (D-), R7.1, U4.3 (I/O2), U4.4 (I/O2)
/USB_CONN_DP: J1.A6 (D+), J1.B6 (D+), R6.1, U4.1 (I/O1), U4.6 (I/O1)
/USB_DM: R7.2, U1.46 (USB_DM)
/USB_DP: R6.2, U1.47 (USB_DP)
/USB_SHIELD: C1.1, J1.S1 (SHIELD), R3.1
/VBUS_IN: F1.1, J1.A4 (VBUS), J1.A9 (VBUS), J1.B4 (VBUS), J1.B9 (VBUS)
/VBUS_SENSE: R4.2, R5.1, U1.41 (GPIO29_ADC3)
/XIN: C16.1, U1.20 (XIN), Y1.1
/XOUT: R8.1, U1.21 (XOUT)
/XTAL_OUT: C17.1, R8.2, Y1.3
GND: C1.2, C2.2, C3.2, C4.2, C5.2, C6.2, C7.2, C8.2, C9.2, C10.2, C11.2, C12.2, C13.2, C14.2, C15.2, C16.2, C17.2, C18.2, C21.2, C22.2, C23.2, C24.2, C27.2, C28.2, C29.2, C30.2, D1.2 (A), D2.1 (K), D3.1 (K), D4.1 (K), D5.1 (K), D6.1 (K), D7.1 (K), J1.A1 (GND), J1.A12 (GND), J1.B1 (GND), J1.B12 (GND), J2.7, R1.2, R2.2, R3.2, R5.2, R11.2, R12.2, R13.2, R14.2, SW1.2, SW2.2, TP4.1, U1.19 (TESTEN), U1.57 (GND), U2.4 (GND), U3.2 (GND), U4.2 (GND), U5.2 (GND), U6.25 (GND), Y1.2, Y1.4
VBUS: C2.1, D1.1 (K), F1.2, R4.1, TP1.1, U3.1 (VIN), U3.3 (EN), U4.5 (VBUS)

Notes on the sheet:
GND and VBUS have no power-output pin
USB-C, protection and 3.3 V supply
Crystal, QSPI flash, BOOTSEL and RESET
DB25 female (hand-fitted)
Status LEDs (optional, not fitted)
RP2040 and its decoupling
Chip A: SP3238E, modem side (DCE)
Chip B: MAX3243E, computer side (DTE)
Test pads
Power flags for ERC
Generated by hardware/kicad/build_schematic.py from hardware/netlist/build_netlist.py. Edit the netlist script and regenerate; hand edits here are lost.

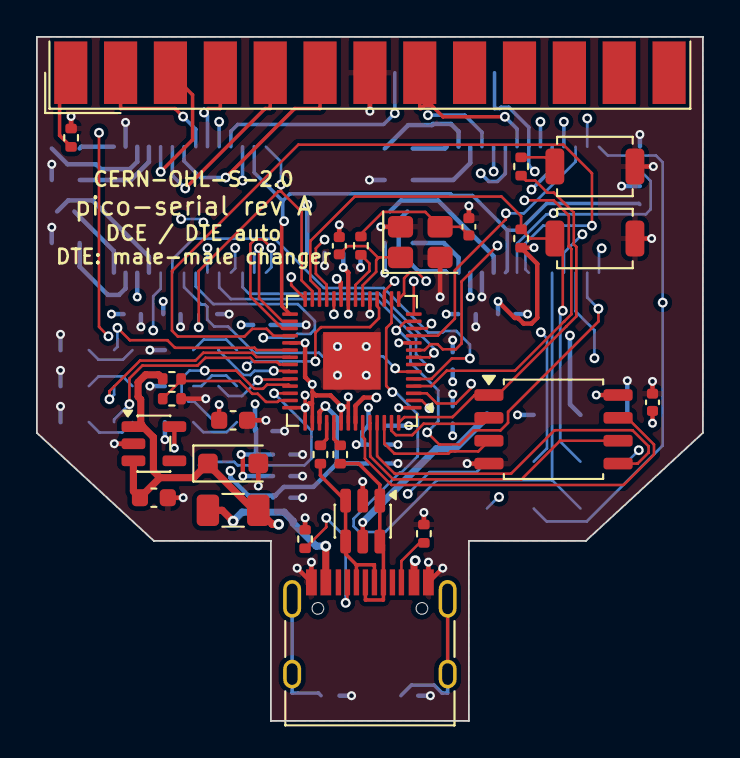
[picture p22: board pico-serial.kicad_pcb from above]

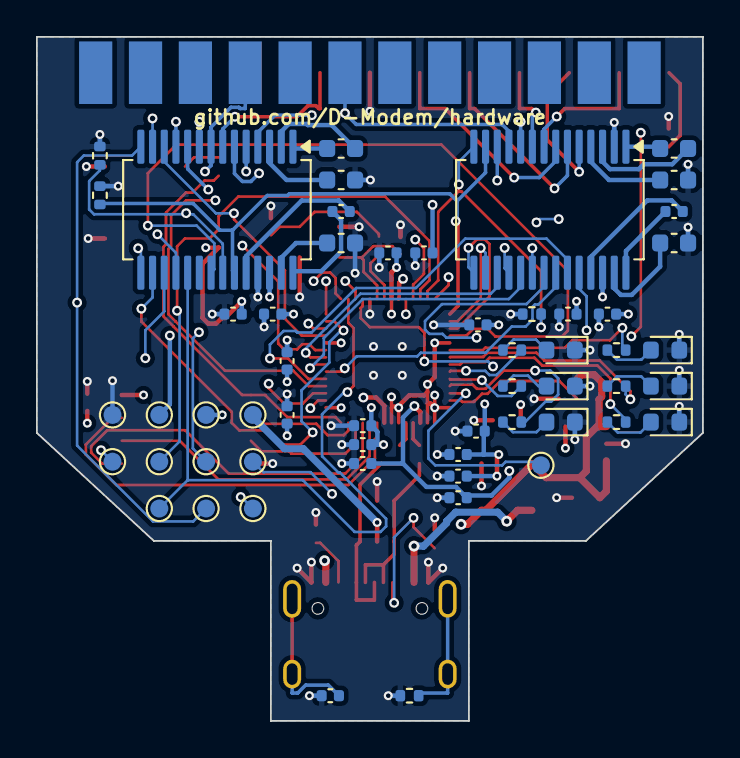
[picture p23: board pico-serial.kicad_pcb from below]

Board: 4 copper layers, 37.0 x 38.0 mm, 81 parts (55 on the bottom side), 82 nets.
