D-Modem/hardware/hardware/kicad/pico-serial-wb.kicad_pcb

## KiCad design hardware/kicad/pico-serial-wb.kicad_pcb (2026-10-27)

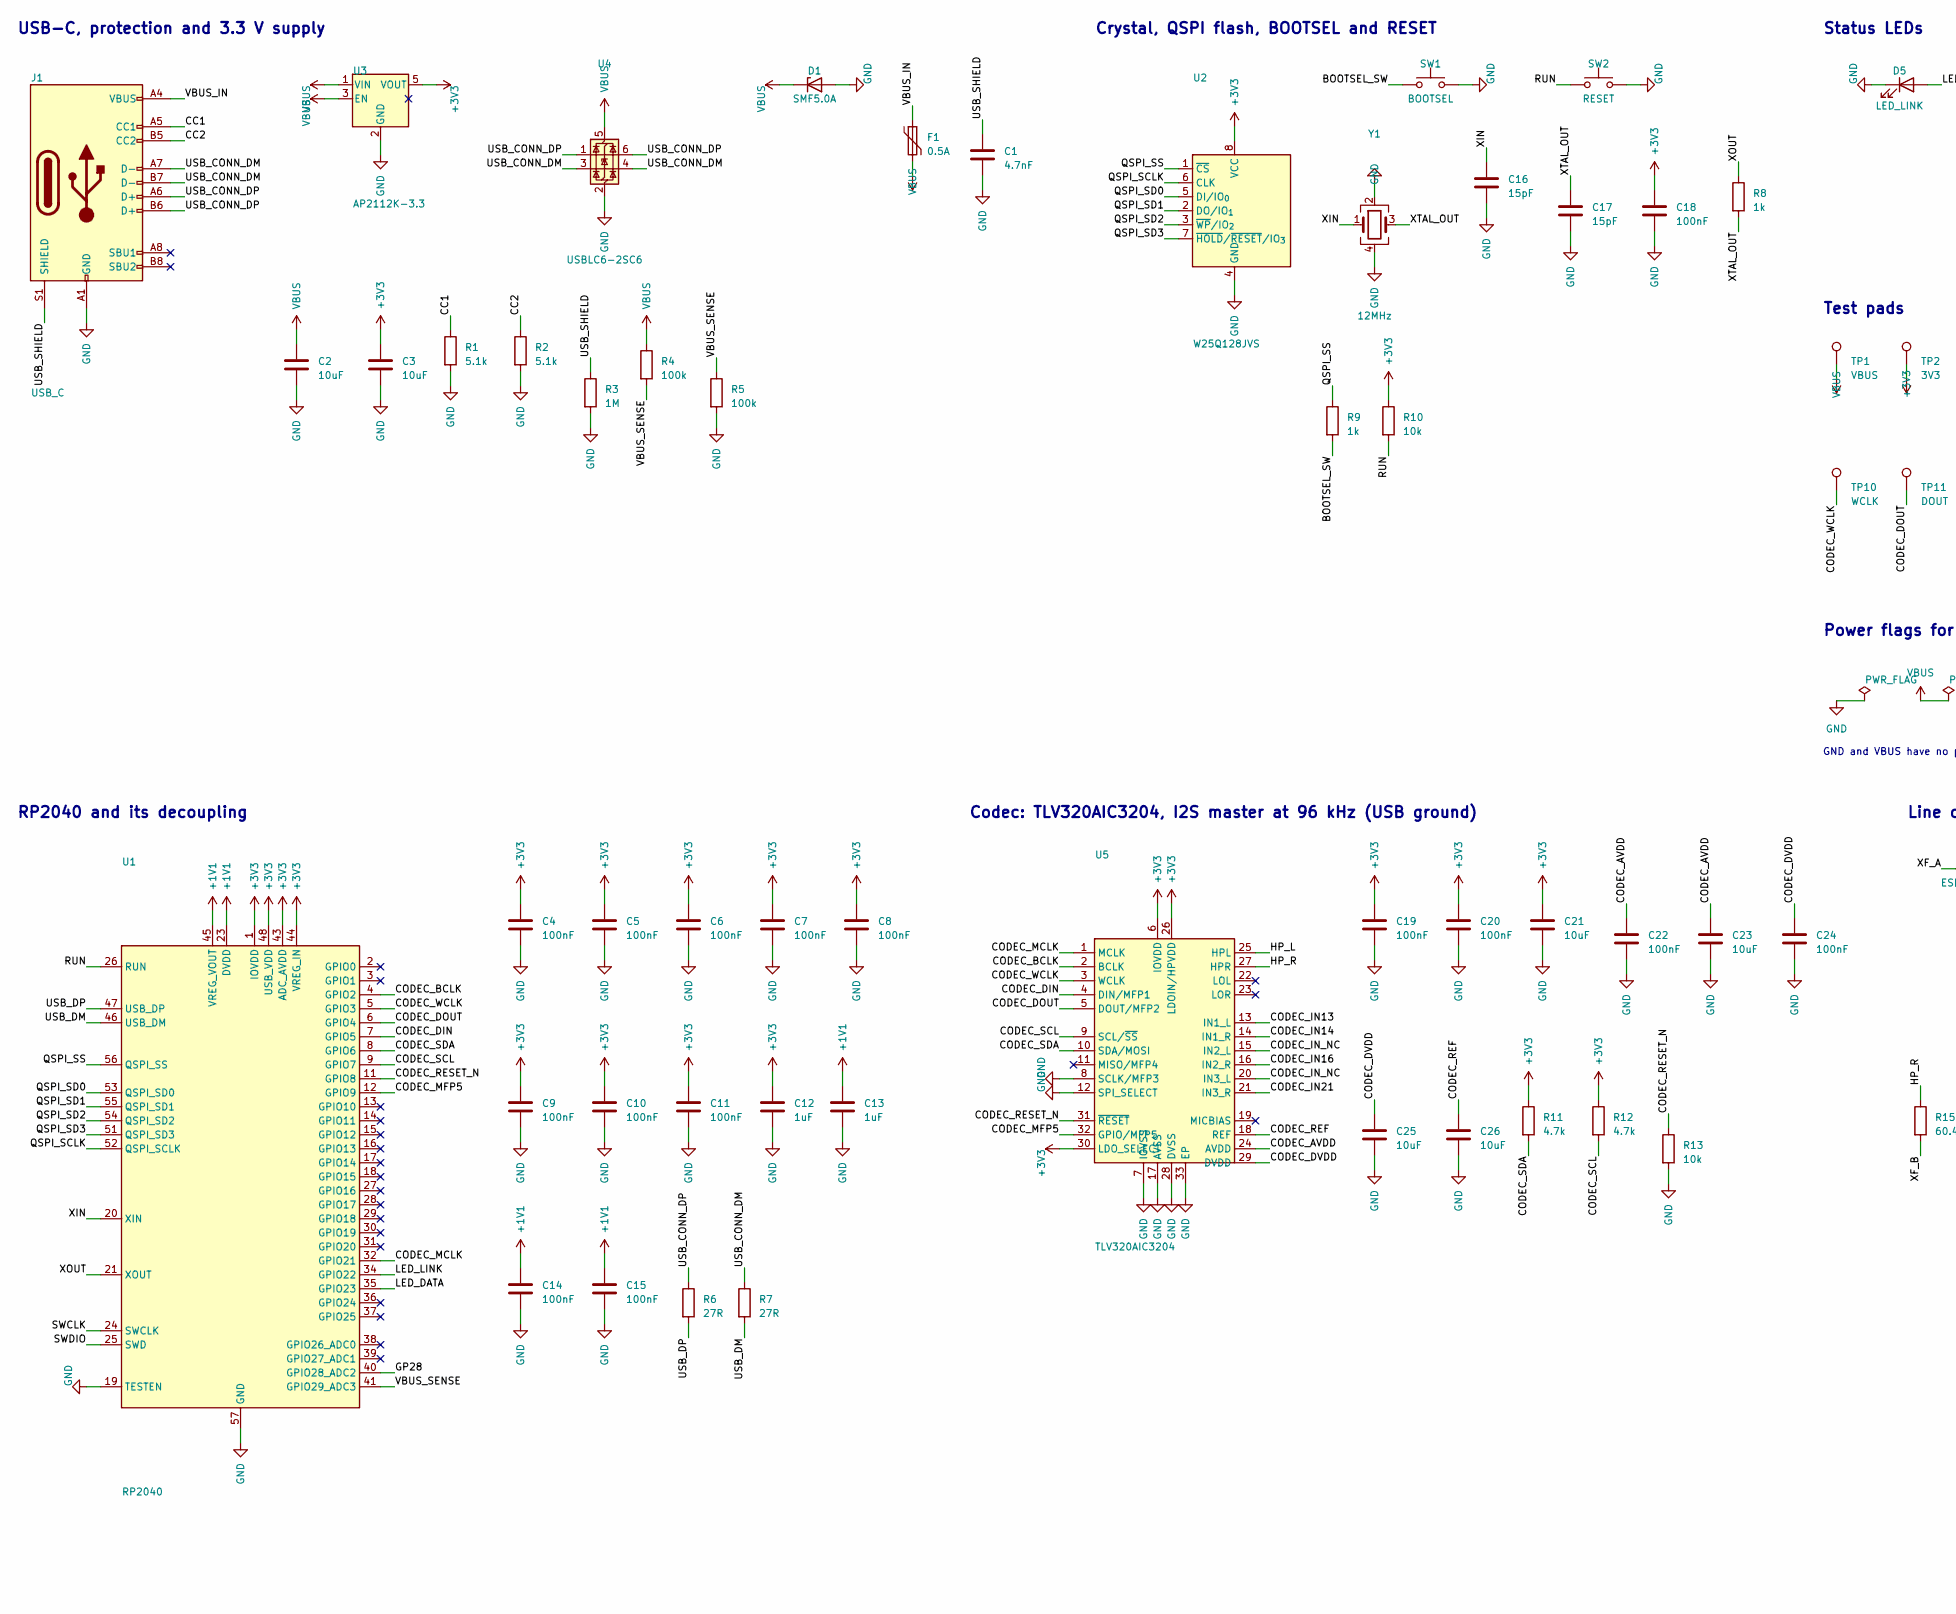
[picture p24: schematic pico-serial-wb.kicad_sch, pico-serial WB: USB-C wideband bare-pair interface for D-Mo…, part in row 1, column 1]

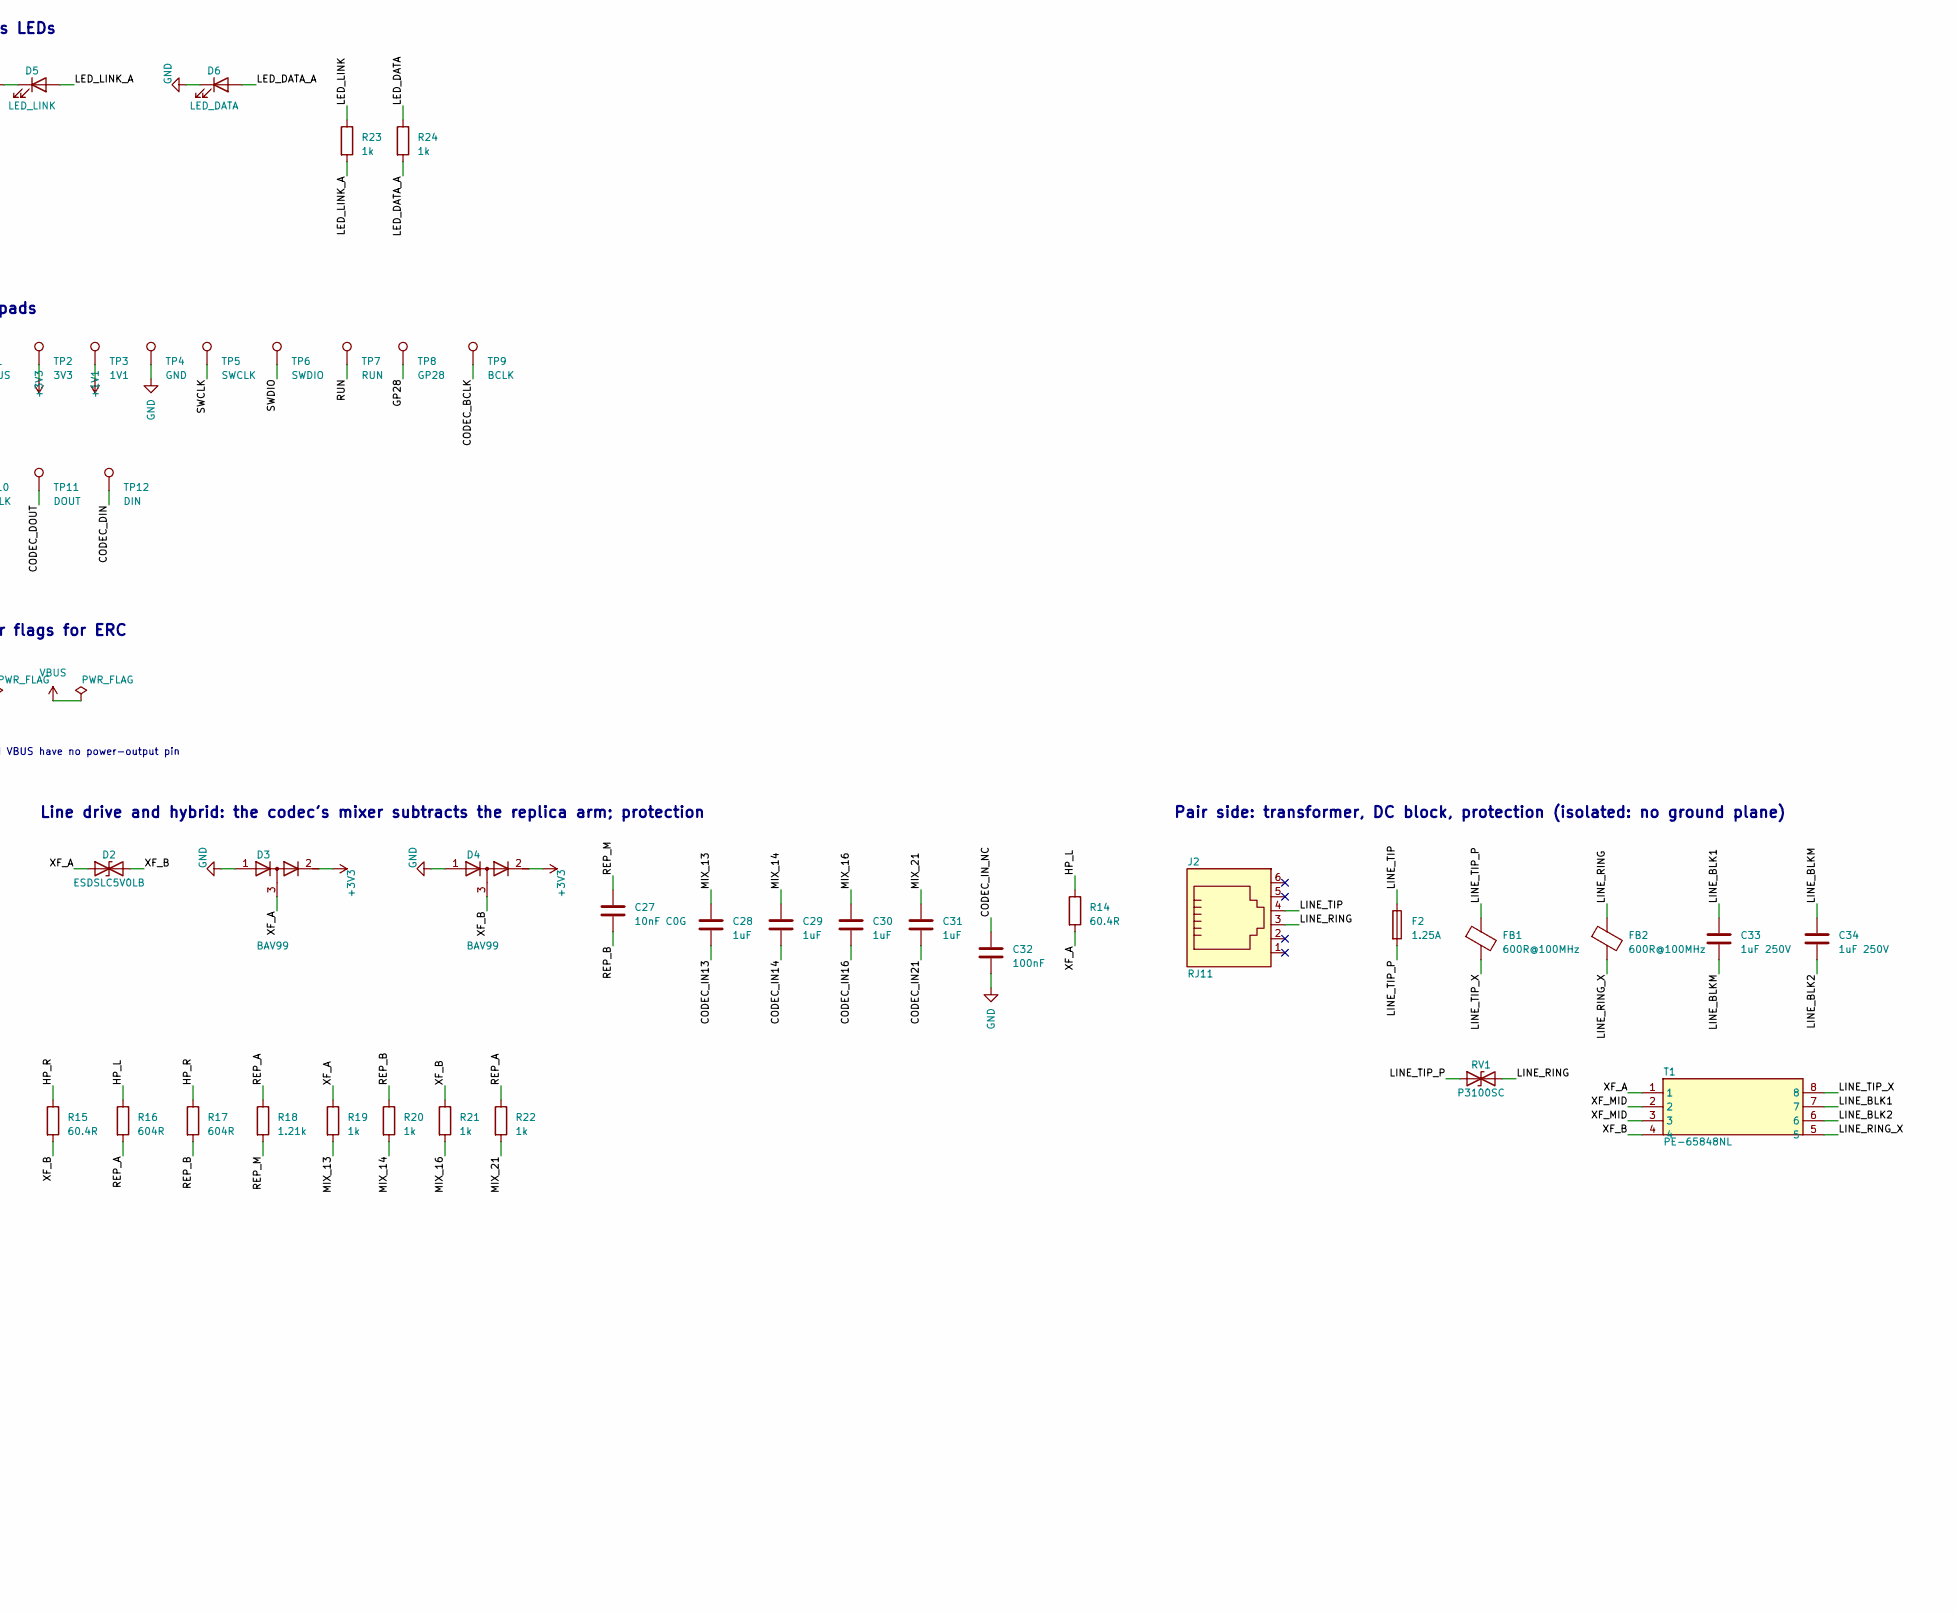
[picture p25: schematic pico-serial-wb.kicad_sch, pico-serial WB: USB-C wideband bare-pair interface for D-Mo…, part in row 1, column 2]

Parts:
C1: 4.7nF; C_0402_1005Metric; LCSC C1538
C2, C3, C21, C23, C25, C26: 10uF; C_0603_1608Metric; LCSC C19702
C4, C5, C6, C7, C8, C9, C10, C11, C14, C15, C18, C19, C20, C22, C24, C32: 100nF; C_0402_1005Metric; LCSC C1525
C12, C13, C28, C29, C30, C31: 1uF; C_0402_1005Metric; LCSC C52923
C16, C17: 15pF; C_0402_1005Metric; LCSC C1548
C27: 10nF C0G; C_0805_2012Metric; LCSC C2971995
C33, C34: 1uF 250V; C_1812_4532Metric; LCSC C381468
D1: SMF5.0A; D_SOD-123F; LCSC C151296
D2: ESDSLC5V0LB; D_0402_1005Metric; LCSC C2762104
D3, D4: BAV99; SOT-23; LCSC C2500
D5: LED_LINK; LED_0603_1608Metric; LCSC C2286
D6: LED_DATA; LED_0603_1608Metric; LCSC C2286
F1: 0.5A; Fuse_1206_3216Metric; LCSC C163512
F2: 1.25A; Fuse_Littelfuse_0461; LCSC C99554
FB1, FB2: 600R@100MHz; L_0603_1608Metric; LCSC C19330
J1: USB_C; USB_C_Receptacle_HRO_TYPE-C-31-M-12; LCSC C165948
J2: RJ11; RJ11_Ckmtw_R-RJ11R06P-A800; LCSC C189750
R1, R2: 5.1k; R_0402_1005Metric; LCSC C25905
R3: 1M; R_0402_1005Metric; LCSC C26083
R4, R5: 100k; R_0402_1005Metric; LCSC C25741
R6, R7: 27R; R_0402_1005Metric; LCSC C25100
R8, R9, R19, R20, R21, R22, R23, R24: 1k; R_0402_1005Metric; LCSC C11702
R10, R13: 10k; R_0402_1005Metric; LCSC C25744
R11, R12: 4.7k; R_0402_1005Metric; LCSC C25900
R14, R15: 60.4R; R_0603_1608Metric; LCSC C2933247
R16, R17: 604R; R_0603_1608Metric; LCSC C32183
R18: 1.21k; R_0603_1608Metric; LCSC C22835
RV1: P3100SC; D_SMB; LCSC C151191
SW1: BOOTSEL; SW_SPST_TS-1088-xR020; LCSC C720477
SW2: RESET; SW_SPST_TS-1088-xR020; LCSC C720477
T1: PE-65848NL; Pulse_PE-65848; LCSC C7261159
TP1: VBUS; TestPoint_Pad_D1.0mm
TP2: 3V3; TestPoint_Pad_D1.0mm
TP3: 1V1; TestPoint_Pad_D1.0mm
TP4: GND; TestPoint_Pad_D1.0mm
TP5: SWCLK; TestPoint_Pad_D1.0mm
TP6: SWDIO; TestPoint_Pad_D1.0mm
TP7: RUN; TestPoint_Pad_D1.0mm
TP8: GP28; TestPoint_Pad_D1.0mm
TP9: BCLK; TestPoint_Pad_D1.0mm
TP10: WCLK; TestPoint_Pad_D1.0mm
TP11: DOUT; TestPoint_Pad_D1.0mm
TP12: DIN; TestPoint_Pad_D1.0mm
U1: RP2040; QFN-56-1EP_7x7mm_P0.4mm_EP3.2x3.2mm; LCSC C2040
U2: W25Q128JVS; SOIC-8_5.3x5.3mm_P1.27mm; LCSC C97521
U3: AP2112K-3.3; SOT-23-5; LCSC C51118
U4: USBLC6-2SC6; SOT-23-6; LCSC C7519
U5: TLV320AIC3204; QFN-32-1EP_5x5mm_P0.5mm_EP3.45x3.45mm; LCSC C24109
Y1: 12MHz; Crystal_SMD_3225-4Pin_3.2x2.5mm; LCSC C20625731

Connections:
+1V1: C13.1, C14.1, C15.1, TP3.1, U1.23 (DVDD), U1.45 (VREG_VOUT), U1.50 (DVDD)
+3V3: C3.1, C4.1, C5.1, C6.1, C7.1, C8.1, C9.1, C10.1, C11.1, C12.1, C18.1, C19.1, C20.1, C21.1, D3.2 (K), D4.2 (K), R10.1, R11.1, R12.1, TP2.1, U1.1 (IOVDD), U1.10 (IOVDD), U1.22 (IOVDD), U1.33 (IOVDD), U1.42 (IOVDD), U1.43 (ADC_AVDD), U1.44 (VREG_IN), U1.48 (USB_VDD), U1.49 (IOVDD), U2.8 (VCC), U3.5 (VOUT), U5.6 (IOVDD), U5.26 (LDOIN/HPVDD), U5.30 (LDO_SELECT)
/BOOTSEL_SW: R9.2, SW1.1
/CC1: J1.A5 (CC1), R1.1
/CC2: J1.B5 (CC2), R2.1
/CODEC_AVDD: C22.1, C23.1, U5.24 (AVDD)
/CODEC_BCLK: TP9.1, U1.4 (GPIO2), U5.2 (BCLK)
/CODEC_DIN: TP12.1, U1.7 (GPIO5), U5.4 (DIN/MFP1)
/CODEC_DOUT: TP11.1, U1.6 (GPIO4), U5.5 (DOUT/MFP2)
/CODEC_DVDD: C24.1, C25.1, U5.29 (DVDD)
/CODEC_IN13: C28.2, U5.13 (IN1_L)
/CODEC_IN14: C29.2, U5.14 (IN1_R)
/CODEC_IN16: C30.2, U5.16 (IN2_R)
/CODEC_IN21: C31.2, U5.21 (IN3_R)
/CODEC_IN_NC: C32.1, U5.15 (IN2_L), U5.20 (IN3_L)
/CODEC_MCLK: U1.32 (GPIO21), U5.1 (MCLK)
/CODEC_MFP5: U1.12 (GPIO9), U5.32 (GPIO/MFP5)
/CODEC_REF: C26.1, U5.18 (REF)
/CODEC_RESET_N: R13.1, U1.11 (GPIO8), U5.31 (~RESET)
/CODEC_SCL: R12.2, U1.9 (GPIO7), U5.9 (SCL/~SS)
/CODEC_SDA: R11.2, U1.8 (GPIO6), U5.10 (SDA/MOSI)
/CODEC_WCLK: TP10.1, U1.5 (GPIO3), U5.3 (WCLK)
/GP28: TP8.1, U1.40 (GPIO28_ADC2)
/HP_L: R14.1, R16.1, U5.25 (HPL)
/HP_R: R15.1, R17.1, U5.27 (HPR)
/LED_DATA: R24.1, U1.35 (GPIO23)
/LED_DATA_A: D6.2 (A), R24.2
/LED_LINK: R23.1, U1.34 (GPIO22)
/LED_LINK_A: D5.2 (A), R23.2
/LINE_BLK1: C33.1, T1.7
/LINE_BLK2: C34.2, T1.6
/LINE_BLKM: C33.2, C34.1
/LINE_RING: FB2.1, J2.3, RV1.2 (A2)
/LINE_RING_X: FB2.2, T1.5
/LINE_TIP: F2.1, J2.4
/LINE_TIP_P: F2.2, FB1.1, RV1.1 (A1)
/LINE_TIP_X: FB1.2, T1.8
/MIX_13: C28.1, R19.2
/MIX_14: C29.1, R20.2
/MIX_16: C30.1, R21.2
/MIX_21: C31.1, R22.2
/QSPI_SCLK: U1.52 (QSPI_SCLK), U2.6 (CLK)
/QSPI_SD0: U1.53 (QSPI_SD0), U2.5 (DI/IO_{0})
/QSPI_SD1: U1.55 (QSPI_SD1), U2.2 (DO/IO_{1})
/QSPI_SD2: U1.54 (QSPI_SD2), U2.3 (~WP/IO_{2})
/QSPI_SD3: U1.51 (QSPI_SD3), U2.7 (~HOLD/~RESET/IO_{3})
/QSPI_SS: R9.1, U1.56 (QSPI_SS), U2.1 (~CS)
/REP_A: R16.2, R18.1, R22.1
/REP_B: C27.2, R17.2, R20.1
/REP_M: C27.1, R18.2
/RUN: R10.2, SW2.1, TP7.1, U1.26 (RUN)
/SWCLK: TP5.1, U1.24 (SWCLK)
/SWDIO: TP6.1, U1.25 (SWD)
/USB_CONN_DM: J1.A7 (D-), J1.B7 (D-), R7.1, U4.3 (I/O2), U4.4 (I/O2)
/USB_CONN_DP: J1.A6 (D+), J1.B6 (D+), R6.1, U4.1 (I/O1), U4.6 (I/O1)
/USB_DM: R7.2, U1.46 (USB_DM)
/USB_DP: R6.2, U1.47 (USB_DP)
/USB_SHIELD: C1.1, J1.S1 (SHIELD), R3.1
/VBUS_IN: F1.1, J1.A4 (VBUS), J1.A9 (VBUS), J1.B4 (VBUS), J1.B9 (VBUS)
/VBUS_SENSE: R4.2, R5.1, U1.41 (GPIO29_ADC3)
/XF_A: D2.1 (A1), D3.3 (common), R14.2, R19.1, T1.1
/XF_B: D2.2 (A2), D4.3 (common), R15.2, R21.1, T1.4
/XF_MID: T1.2, T1.3
/XIN: C16.1, U1.20 (XIN), Y1.1
/XOUT: R8.1, U1.21 (XOUT)
/XTAL_OUT: C17.1, R8.2, Y1.3
GND: C1.2, C2.2, C3.2, C4.2, C5.2, C6.2, C7.2, C8.2, C9.2, C10.2, C11.2, C12.2, C13.2, C14.2, C15.2, C16.2, C17.2, C18.2, C19.2, C20.2, C21.2, C22.2, C23.2, C24.2, C25.2, C26.2, C32.2, D1.2 (A), D3.1 (A), D4.1 (A), D5.1 (K), D6.1 (K), J1.A1 (GND), J1.A12 (GND), J1.B1 (GND), J1.B12 (GND), R1.2, R2.2, R3.2, R5.2, R13.2, SW1.2, SW2.2, TP4.1, U1.19 (TESTEN), U1.57 (GND), U2.4 (GND), U3.2 (GND), U4.2 (GND), U5.7 (IOVSS), U5.8 (SCLK/MFP3), U5.12 (SPI_SELECT), U5.17 (AVSS), U5.28 (DVSS), U5.33 (EP), Y1.2, Y1.4
VBUS: C2.1, D1.1 (K), F1.2, R4.1, TP1.1, U3.1 (VIN), U3.3 (EN), U4.5 (VBUS)

Notes on the sheet:
GND and VBUS have no power-output pin
USB-C, protection and 3.3 V supply
Crystal, QSPI flash, BOOTSEL and RESET
Status LEDs
Test pads
Power flags for ERC
RP2040 and its decoupling
Codec: TLV320AIC3204, I2S master at 96 kHz (USB ground)
Line drive and hybrid: the codec's mixer subtracts the replica arm; protection
Pair side: transformer, DC block, protection (isolated: no ground plane)
Generated by hardware/kicad/build_schematic.py from hardware/netlist/build_netlist.py. Edit the netlist script and regenerate; hand edits here are lost.

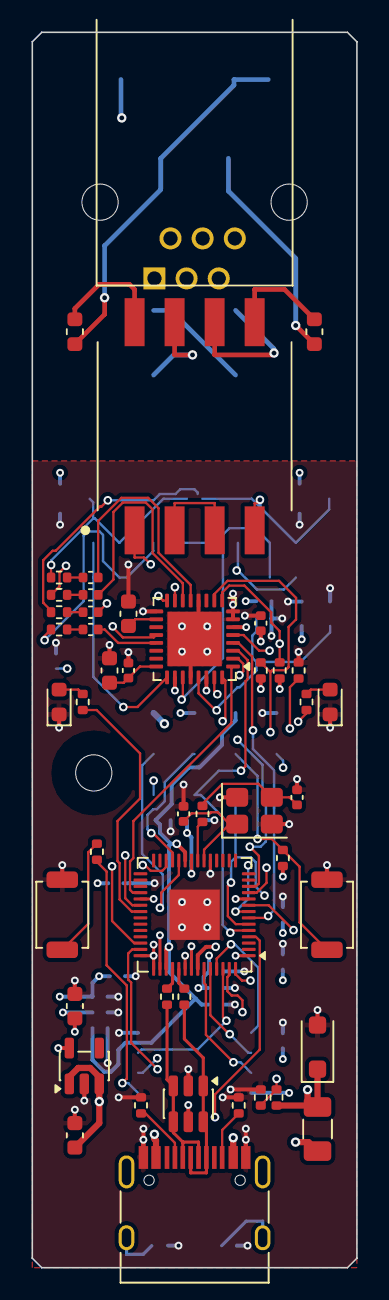
[picture p26: board pico-serial-wb.kicad_pcb from above]

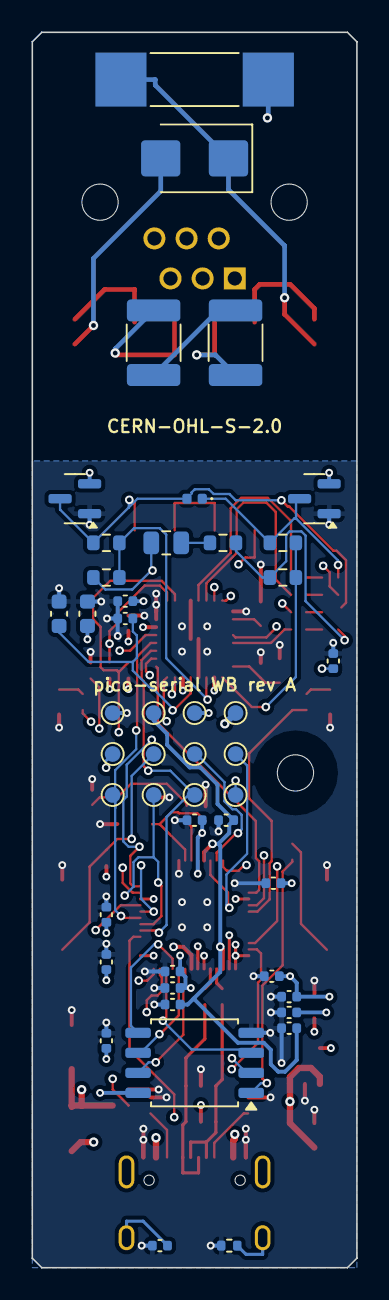
[picture p27: board pico-serial-wb.kicad_pcb from below]

Board: 4 copper layers, 20.6 x 78.4 mm, 93 parts (46 on the bottom side), 68 nets.

Other parts of the board:
H1: M2 screw; MountingHole_M2
