D-Modem/hardware/hardware/netlist/build_netlist.py

#!/usr/bin/env python3
# SPDX-License-Identifier: CERN-OHL-S-2.0
# Copyright (C) 2026 D-Modem Authors
"""pico-serial netlist: every part and connection on the board, in one place.

Two boards come from this script (--variant, or $PS_VARIANT for the
scripts that import it):
  hood  the wired board inside a standard DB25 hood (SPEC.md)
  w     pico-serial W: the same plus an RM2 Bluetooth module (SPEC-W.md)

Writes, next to this script (W files carry a "-w" suffix):
  pico-serial.net   KiCad netlist (import into Pcbnew: File > Import > Netlist)
  NETLIST.md        the same nets, readable: by net and by part
  bom-jlc.csv       JLC assembly BOM (Comment, Designator, Footprint, LCSC)
and firmware/src/generated/board_pins.h (board_pins_w.h).

Checks before writing (exit 1 on any error):
  - every pin of every part is on a net or listed as not connected
  - no net has fewer than two pins
  - no net has two outputs driving it
  - every RS-232 line has exactly one driver and one receiver
  - every power input sits on a supply net
  - with --kicad-sym/--kicad-fp: pin numbers and names match KiCad's
    symbol, and every pin has a pad in the footprint

Spec: ../../SPEC.md (section numbers below refer to it).
"""
import argparse, os, re, sys, uuid
from collections import defaultdict

# Design date, written into the netlist and the schematic's title block. A
# fixed value, so regenerating on another day changes nothing (CI diffs the
# output). Bump it with the revision when the circuit changes.
DATE = "2026-10-18"

VARIANTS = ("hood", "w", "line", "wb")
VARIANT = os.environ.get("PS_VARIANT", "hood")
if "--variant" in sys.argv[1:-1]:          # read early: the circuit is built on import
    VARIANT = sys.argv[sys.argv.index("--variant") + 1]
if VARIANT not in VARIANTS:
    raise SystemExit(f"unknown variant {VARIANT!r}; one of {VARIANTS}")
W = VARIANT == "w"
LINE = VARIANT == "line"     # the phone-line stick (SPEC-L.md): a DAA, no RS-232
WB = VARIANT == "wb"         # the wideband bare-pair stick (SPEC-WB.md): a codec and a transformer
STICK = LINE or WB           # the two sticks: no RS-232, the stick shell
SUFFIX = {"hood": "", "w": "-w", "line": "-line", "wb": "-wb"}[VARIANT]
HERE = os.path.dirname(os.path.abspath(__file__))
LOCAL_FP = os.path.join(HERE, "..", "kicad", "lib")   # our own footprints (pico-serial.pretty)

# ---------------------------------------------------------------------------
# Pin tables. RP2040, flash, LDO, USBLC6 and connectors are copied from
# KiCad's symbol library (checked with --kicad-sym). KiCad has no symbol for
# the two RS-232 chips; theirs come from the datasheets:
#   SP3238E  MaxLinear rev 1.0.1, pin description table
#   MAX3243E TI SLLS657E, Table 6-2 (DB/DW/PW 28-pin)
# Pin names and types follow KiCad 9.0 (kicad-symbols tag 9.0.x).
# ---------------------------------------------------------------------------
P, PI, PO, I, O, B, NC = "passive", "power_in", "power_out", "input", "output", "bidirectional", "no_connect"

RP2040 = {
    "1": ("IOVDD", PI), "2": ("GPIO0", B), "3": ("GPIO1", B), "4": ("GPIO2", B), "5": ("GPIO3", B),
    "6": ("GPIO4", B), "7": ("GPIO5", B), "8": ("GPIO6", B), "9": ("GPIO7", B), "10": ("IOVDD", P),
    "11": ("GPIO8", B), "12": ("GPIO9", B), "13": ("GPIO10", B), "14": ("GPIO11", B), "15": ("GPIO12", B),
    "16": ("GPIO13", B), "17": ("GPIO14", B), "18": ("GPIO15", B), "19": ("TESTEN", I), "20": ("XIN", I),
    "21": ("XOUT", O), "22": ("IOVDD", P), "23": ("DVDD", PI), "24": ("SWCLK", I), "25": ("SWD", B),
    "26": ("RUN", I), "27": ("GPIO16", B), "28": ("GPIO17", B), "29": ("GPIO18", B), "30": ("GPIO19", B),
    "31": ("GPIO20", B), "32": ("GPIO21", B), "33": ("IOVDD", P), "34": ("GPIO22", B), "35": ("GPIO23", B),
    "36": ("GPIO24", B), "37": ("GPIO25", B), "38": ("GPIO26_ADC0", B), "39": ("GPIO27_ADC1", B),
    "40": ("GPIO28_ADC2", B), "41": ("GPIO29_ADC3", B), "42": ("IOVDD", P), "43": ("ADC_AVDD", PI),
    "44": ("VREG_IN", PI), "45": ("VREG_VOUT", PO), "46": ("USB_DM", B), "47": ("USB_DP", B),
    "48": ("USB_VDD", PI), "49": ("IOVDD", P), "50": ("DVDD", P), "51": ("QSPI_SD3", B),
    "52": ("QSPI_SCLK", O), "53": ("QSPI_SD0", B), "54": ("QSPI_SD2", B), "55": ("QSPI_SD1", B),
    "56": ("QSPI_SS", O), "57": ("GND", PI),
}
SP3238E = {
    "1": ("C2+", P), "2": ("GND", PI), "3": ("C2-", P), "4": ("V-", P), "5": ("T1OUT", O),
    "6": ("T2OUT", O), "7": ("T3OUT", O), "8": ("R1IN", I), "9": ("R2IN", I), "10": ("T4OUT", O),
    "11": ("R3IN", I), "12": ("T5OUT", O), "13": ("ONLINE", I), "14": ("~{SHUTDOWN}", I),
    "15": ("STATUS", O), "16": ("R1OUTB", O),  # non-inverting R1 output, active in shutdown
    "17": ("T5IN", I), "18": ("R3OUT", O), "19": ("T4IN", I), "20": ("R2OUT", O), "21": ("R1OUT", O),
    "22": ("T3IN", I), "23": ("T2IN", I), "24": ("T1IN", I), "25": ("C1-", P), "26": ("VCC", PI),
    "27": ("V+", P), "28": ("C1+", P),
}
MAX3243E = {
    "1": ("C2+", P), "2": ("C2-", P), "3": ("V-", P), "4": ("RIN1", I), "5": ("RIN2", I),
    "6": ("RIN3", I), "7": ("RIN4", I), "8": ("RIN5", I), "9": ("DOUT1", O), "10": ("DOUT2", O),
    "11": ("DOUT3", O), "12": ("DIN3", I), "13": ("DIN2", I), "14": ("DIN1", I), "15": ("ROUT5", O),
    "16": ("ROUT4", O), "17": ("ROUT3", O), "18": ("ROUT2", O), "19": ("ROUT1", O),
    "20": ("ROUT2B", O),  # always-active non-inverting RIN2 output
    "21": ("INVALID", O), "22": ("~{FORCEOFF}", I), "23": ("FORCEON", I), "24": ("C1-", P),
    "25": ("GND", PI), "26": ("VCC", PI), "27": ("V+", P), "28": ("C1+", P),
}
W25Q = {"1": ("~{CS}", I), "2": ("DO/IO_{1}", B), "3": ("~{WP}/IO_{2}", B), "4": ("GND", PI),
        "5": ("DI/IO_{0}", B), "6": ("CLK", I), "7": ("~{HOLD}/~{RESET}/IO_{3}", B), "8": ("VCC", PI)}
AP2112K = {"1": ("VIN", PI), "2": ("GND", PI), "3": ("EN", I), "4": ("NC", NC), "5": ("VOUT", PO)}
USBLC6 = {"1": ("I/O1", P), "2": ("GND", P), "3": ("I/O2", P), "4": ("I/O2", P), "5": ("VBUS", P), "6": ("I/O1", P)}
USB_C16 = {"A1": ("GND", P), "A4": ("VBUS", P), "A5": ("CC1", B), "A6": ("D+", B), "A7": ("D-", B),
           "A8": ("SBU1", B), "A9": ("VBUS", P), "A12": ("GND", P), "B1": ("GND", P), "B4": ("VBUS", P),
           "B5": ("CC2", B), "B6": ("D+", B), "B7": ("D-", B), "B8": ("SBU2", B), "B9": ("VBUS", P),
           "B12": ("GND", P), "S1": ("SHIELD", P)}
# Raspberry Pi RM2 (RMC20452T), datasheet Table 2. GND pins are passive in
# KiCad terms; VDDIO and Vin are power inputs.
RM2 = {"1": ("GND", PI), "2": ("NC", NC), "3": ("SCLK", I), "4": ("GND", PI), "5": ("DATA_IN", I),
       "6": ("DATA_OUT", O), "7": ("GND", PI), "8": ("GPIO0", B), "9": ("CS", I), "10": ("~{IRQ}", O),
       "11": ("GND", PI), "12": ("WL_ON", I), "13": ("BT_ON", I), "14": ("VDDIO", PI), "15": ("GND", PI),
       "16": ("VIN", PI), "17": ("GPIO2", B), "18": ("GPIO1", B), "19": ("NC", NC), "20": ("NC", NC),
       "21": ("GND", PI)}
# Skyworks Si3056 Global Serial Interface DAA, system side (datasheet rev 1.03,
# Table 24) and its Si3018/19 line side (Table 25; the two have the same pins). Line-side pins are all
# passive: the barrier's own island, no supply pins in KiCad's sense.
SI3056 = {"1": ("MCLK", I), "2": ("~{FSYNC}", O), "3": ("SCLK", O), "4": ("VD", PI), "5": ("SDO", O),
          "6": ("SDI", I), "7": ("FC/~{RGDT}", I), "8": ("~{RESET}", I), "9": ("C2A", P), "10": ("C1A", P),
          "11": ("AOUT/~{INT}", O), "12": ("GND", PI), "13": ("VA", P), "14": ("M0", I),
          "15": ("~{RGDT}/FSD/M1", B), "16": ("~{OFHK}", I)}
SI3018 = {"1": ("QE", P), "2": ("DCT", P), "3": ("RX", P), "4": ("IB", P), "5": ("C1B", P), "6": ("C2B", P),
          "7": ("VREG", P), "8": ("RNG1", P), "9": ("RNG2", P), "10": ("VREG2", P), "11": ("SC", P),
          "12": ("QE2", P), "13": ("QB", P), "14": ("DCT3", P), "15": ("IGND", P), "16": ("DCT2", P)}
# TI TLV320AIC3204, RHB (QFN-32) package (SLOS602E, Pin Functions). AVDD,
# DVDD and REF are outputs here: the internal LDOs (LDO_SELECT high, A-LDO on)
# make them, and only their capacitors join them, so they're passive.
AIC3204 = {"1": ("MCLK", I), "2": ("BCLK", B), "3": ("WCLK", B), "4": ("DIN/MFP1", I), "5": ("DOUT/MFP2", O),
           "6": ("IOVDD", PI), "7": ("IOVSS", PI), "8": ("SCLK/MFP3", I), "9": ("SCL/~{SS}", I),
           "10": ("SDA/MOSI", B), "11": ("MISO/MFP4", O), "12": ("SPI_SELECT", I), "13": ("IN1_L", I),
           "14": ("IN1_R", I), "15": ("IN2_L", I), "16": ("IN2_R", I), "17": ("AVSS", PI), "18": ("REF", P),
           "19": ("MICBIAS", O), "20": ("IN3_L", I), "21": ("IN3_R", I), "22": ("LOL", O), "23": ("LOR", O),
           "24": ("AVDD", P), "25": ("HPL", O), "26": ("LDOIN/HPVDD", PI), "27": ("HPR", O), "28": ("DVSS", PI),
           "29": ("DVDD", P), "30": ("LDO_SELECT", I), "31": ("~{RESET}", I), "32": ("GPIO/MFP5", B),
           "33": ("EP", P)}
# Pulse PE-65848NL line transformer: two split windings, 1-2 + 3-4 and 8-7 + 6-5
# (Pulse drawing PE-65848NL rev M12; dots on 1, 3, 8 and 6).
XFMR8 = {str(n): (str(n), P) for n in range(1, 9)}
BJT = {"1": ("B", I), "2": ("E", P), "3": ("C", P)}      # SOT-23 B E C, as KiCad's Q_NPN_BEC / Q_PNP_BEC
DUALDIODE = {"1": ("A", P), "2": ("K", P), "3": ("K/A", P)}   # two in series: 1 anode, 2 cathode, 3 the middle
RJ = {str(n): ({3: "RING", 4: "TIP"}.get(n, str(n)), P if n in (3, 4) else NC) for n in range(1, 7)}  # 6P6C: TIP/RING the middle pair
DB25F = {str(n): (str(n) if n <= 13 else f"P{n}", P) for n in range(1, 26)}
XTAL4 = {"1": ("1", P), "2": ("2", P), "3": ("3", P), "4": ("4", P)}
TWO = {"1": ("~", P), "2": ("~", P)}
DIODE = {"1": ("K", P), "2": ("A", P)}
SW = {"1": ("1", P), "2": ("2", P)}
TP = {"1": ("1", P)}

# KiCad library symbol for each pin table (lib, symbol); None = no KiCad symbol
SYMBOLS = {
    id(RP2040): ("MCU_RaspberryPi", "RP2040"), id(W25Q): ("Memory_Flash", "W25Q128JVS"),
    id(AP2112K): ("Regulator_Linear", "AP2112K-3.3"), id(USBLC6): ("Power_Protection", "USBLC6-2SC6"),
    id(USB_C16): ("Connector", "USB_C_Receptacle_USB2.0_16P"), id(DB25F): ("Connector", "DB25_Socket"),
    id(XTAL4): ("Device", "Crystal_GND24"), id(DIODE): None, id(SW): ("Switch", "SW_Push"),
    id(TP): ("Connector", "TestPoint"), id(SP3238E): None, id(MAX3243E): None, id(RM2): None,
    id(SI3056): None, id(SI3018): None, id(AIC3204): None, id(XFMR8): None, id(BJT): None, id(DUALDIODE): None, id(RJ): None,
}

FP_R = "Resistor_SMD:R_0402_1005Metric"
FP_C = "Capacitor_SMD:C_0402_1005Metric"
FP_C6 = "Capacitor_SMD:C_0603_1608Metric"
FP_C8 = "Capacitor_SMD:C_0805_2012Metric"

# value -> (LCSC part, footprint); JLC "basic" parts unless noted
PASSIVES = {
    "100nF": ("C1525", FP_C), "1uF": ("C52923", FP_C), "1uF 50V": ("C15849", FP_C6),
    "220nF": ("C16772", FP_C), "10uF": ("C19702", FP_C6), "15pF": ("C1548", FP_C),
    "4.7nF": ("C1538", FP_C), "27R": ("C25100", FP_R),  # 27R is "extended"
    "5.1k": ("C25905", FP_R), "1k": ("C11702", FP_R), "10k": ("C25744", FP_R),
    "100k": ("C25741", FP_R), "1M": ("C26083", FP_R), "0R": ("C17168", FP_R),
    "22uF": ("C45783", FP_C8), "470R": ("C25117", FP_R), "4.7k": ("C25900", FP_R),
}

# The phone-line stick's parts (SPEC-L §3.1): key -> (value, LCSC, footprint,
# description). JLCPCB stock checked 2026-10-22. The two Skyworks chips are
# not stocked at LCSC: DigiKey (Si3056-D-FS, "not for new designs", ~4000 in
# stock; Si3018-F-FS active), fitted by hand or sent to JLC as consigned parts.
LINE_PARTS = {
    "Si3056": ("Si3056-D-FS", "", "Package_SO:SOIC-16_3.9x9.9mm_P1.27mm",
               "Skyworks Si3056 DAA, system side; from DigiKey, not at LCSC"),
    "Si3018": ("Si3018-F-FS", "", "Package_SO:SOIC-16_3.9x9.9mm_P1.27mm",
               "Skyworks Si3018 DAA, line side; DigiKey, not at LCSC"),
    "33pF Y2": ("33pF Y2", "C2915768", "Capacitor_SMD:C_1808_4520Metric", "isolation barrier, Y2 safety"),
    "680pF Y2": ("680pF Y2", "C524545", "Capacitor_SMD:C_1808_4520Metric", "TIP/RING to ground, Y2 safety (Murata)"),
    "10nF 250V": ("10nF 250V", "C106841", "Capacitor_SMD:C_0805_2012Metric", ""),
    "1uF 50V": ("1uF 50V", "C28323", "Capacitor_SMD:C_0805_2012Metric", ""),
    "2.7nF": ("2.7nF", "C106251", FP_C, ""),
    "10nF": ("10nF", "C60133", FP_C, ""),
    "100nF": ("100nF", "C1525", FP_C, ""),
    "1.07k 0.5W": ("1.07k", "C51048343", "Resistor_SMD:R_2010_5025Metric", "1%, 750 mW"),
    "3.65k 0.5W": ("3.65k", "C877404", "Resistor_SMD:R_2010_5025Metric", "1%, 750 mW"),
    "2.49k 0.5W": ("2.49k", "C6263440", "Resistor_SMD:R_1206_3216Metric", "1%, 500 mW"),
    "73.2R 0.5W": ("73.2R", "C2991291", "Resistor_SMD:R_1210_3225Metric", "1%, 500 mW"),
    "536R 0.25W": ("536R", "C305048", "Resistor_SMD:R_1206_3216Metric", "1%, 250 mW"),
    "20M": ("20M", "C71198", "Resistor_SMD:R_1206_3216Metric", "1%, 200 V (caller ID)"),
    "56.2R": ("56.2R", "C51048309", FP_R, "1%"),
    "150R": ("150R", "C25082", FP_R, ""),
    "100k": ("100k", "C25741", FP_R, ""),
    "1M": ("1M", "C26083", FP_R, "1%"),
    "0R line": ("0R", "C17168", FP_R, ""),
    "43V zener": ("BZT52C43", "C2847220", "Diode_SMD:D_SOD-123", "43 V, 500 mW"),
    "MMBTA42": ("MMBTA42", "C94389", "Package_TO_SOT_SMD:SOT-23", "NPN 300 V"),
    "MMBTA92": ("MMBTA92", "C82049", "Package_TO_SOT_SMD:SOT-23", "PNP 300 V"),
    "MMBT2484": ("MMBTA06", "C77760", "Package_TO_SOT_SMD:SOT-23", "NPN 80 V (the datasheet's MMBT2484 or MMBTA06)"),
    "dual diode": ("MMBD3004S", "C7436538", "Package_TO_SOT_SMD:SOT-23", "two 350 V diodes in series"),
    "ferrite": ("600R@100MHz", "C19330", "Inductor_SMD:L_0603_1608Metric", "Murata BLM18AG601SN1D, 200 mA"),
    "sidactor": ("P3100SC", "C151191", "Diode_SMD:D_SMB", "Littelfuse P3100SCLRP, 275 V, 250 A 8/20"),
    "telecom fuse": ("1.25A", "C99554", "pico-serial:Fuse_Littelfuse_0461", "Littelfuse TeleLink 04611.25ER, 600 V"),
    "RJ11": ("RJ11", "C189750", "pico-serial:RJ11_Ckmtw_R-RJ11R06P-A800", "Ckmtw R-RJ11R06P-A800, 6P6C right angle"),
}

# ---------------------------------------------------------------------------
parts = {}      # ref -> dict
nets = defaultdict(list)   # net -> [(ref, pin)]
noconnect = set()          # (ref, pin)
counters = defaultdict(int)
BLOCK = None               # schematic block the next parts belong to


def block(name):
    global BLOCK
    BLOCK = name


def part(prefix, value, pins, footprint, lcsc="", note="", dnp=False, assembly="jlc", desc="", ref=None):
    if ref is None:
        counters[prefix] += 1
        ref = f"{prefix}{counters[prefix]}"
    assert ref not in parts, ref
    parts[ref] = dict(ref=ref, value=value, pins=pins, footprint=footprint, lcsc=lcsc,
                      note=note, dnp=dnp, assembly=assembly, desc=desc, block=BLOCK)
    return ref


def conn(net, *nodes):
    """conn("NET", ("U1","2"), ...) puts each (ref, pin) on NET."""
    for ref, pin in nodes:
        assert pin in parts[ref]["pins"], f"{ref} has no pin {pin}"
        for n, members in nets.items():
            if (ref, pin) in members:
                raise SystemExit(f"{ref}.{pin} is already on {n}, can't also join {net}")
        nets[net].append((ref, pin))


def passive(kind, value, a, b, note="", dnp=False):
    """A two-pin R or C between nets a and b."""
    lcsc, fp = PASSIVES[value]
    ref = part(kind, value.split()[0], TWO, fp, lcsc, note, dnp)
    conn(a, (ref, "1"))
    conn(b, (ref, "2"))
    return ref


def nc(ref, *pins):
    for p in pins:
        noconnect.add((ref, p))


def tp(net, label):
    ref = part("TP", label, TP, "TestPoint:TestPoint_Pad_D1.0mm", assembly="none")
    conn(net, (ref, "1"))


# ===========================================================================
# The circuit
# ===========================================================================
GND, VBUS_IN, VBUS, V33, V11 = "GND", "VBUS_IN", "VBUS", "+3V3", "+1V1"
SUPPLIES = {GND, VBUS_IN, VBUS, V33, V11}

# --- §4.4 USB-C (UFP) -------------------------------------------------------
block("usb")
J1 = part("J", "USB_C", USB_C16, "Connector_USB:USB_C_Receptacle_HRO_TYPE-C-31-M-12", "C165948",
          desc="HRO TYPE-C-31-M-12")
conn(GND, *[(J1, p) for p in ("A1", "A12", "B1", "B12")])
conn(VBUS_IN, *[(J1, p) for p in ("A4", "A9", "B4", "B9")])
conn("CC1", (J1, "A5"))
conn("CC2", (J1, "B5"))
conn("USB_CONN_DP", (J1, "A6"), (J1, "B6"))
conn("USB_CONN_DM", (J1, "A7"), (J1, "B7"))
conn("USB_SHIELD", (J1, "S1"))
nc(J1, "A8", "B8")
passive("R", "5.1k", "CC1", GND, "CC1 Rd: separate resistor per CC pin")
passive("R", "5.1k", "CC2", GND, "CC2 Rd")
passive("R", "1M", "USB_SHIELD", GND, "shell bleed")
passive("C", "4.7nF", "USB_SHIELD", GND, "shell to GND, RF")

# --- §4.3 power ---------------------------------------------------------------
F1 = part("F", "0.5A", TWO, "Fuse:Fuse_1206_3216Metric", "C163512", desc="Littelfuse 1206L050YR PTC")
conn(VBUS_IN, (F1, "1")); conn(VBUS, (F1, "2"))
D1 = part("D", "SMF5.0A", DIODE, "Diode_SMD:D_SOD-123F", "C151296", desc="5 V TVS, unidirectional")
conn(VBUS, (D1, "1")); conn(GND, (D1, "2"))
U_ESD = part("U", "USBLC6-2SC6", USBLC6, "Package_TO_SOT_SMD:SOT-23-6", "C7519", ref="U4")
conn("USB_CONN_DP", (U_ESD, "1"), (U_ESD, "6"))
conn("USB_CONN_DM", (U_ESD, "3"), (U_ESD, "4"))
conn(VBUS, (U_ESD, "5")); conn(GND, (U_ESD, "2"))
U_LDO = part("U", "AP2112K-3.3", AP2112K, "Package_TO_SOT_SMD:SOT-23-5", "C51118", ref="U3")
conn(VBUS, (U_LDO, "1"), (U_LDO, "3")); conn(GND, (U_LDO, "2")); conn(V33, (U_LDO, "5"))
nc(U_LDO, "4")
passive("C", "10uF", VBUS, GND, "LDO input")
passive("C", "10uF", V33, GND, "LDO output, 3V3 bulk")
passive("R", "100k", VBUS, "VBUS_SENSE", "VBUS divider top")
passive("R", "100k", "VBUS_SENSE", GND, "VBUS divider bottom")

# --- §4.2 RP2040 ------------------------------------------------------------
block("mcu")
U1 = part("U", "RP2040", RP2040, "Package_DFN_QFN:QFN-56-1EP_7x7mm_P0.4mm_EP3.2x3.2mm", "C2040", ref="U1")
for p in ("1", "10", "22", "33", "42", "49"):
    conn(V33, (U1, p))
    passive("C", "100nF", V33, GND, f"IOVDD pin {p}")
conn(V33, (U1, "48")); passive("C", "100nF", V33, GND, "USB_VDD")
conn(V33, (U1, "43")); passive("C", "100nF", V33, GND, "ADC_AVDD")
conn(V33, (U1, "44")); passive("C", "1uF", V33, GND, "VREG_VIN")
conn(V11, (U1, "45"), (U1, "23"), (U1, "50"))
passive("C", "1uF", V11, GND, "VREG_VOUT")
passive("C", "100nF", V11, GND, "DVDD pin 23")
passive("C", "100nF", V11, GND, "DVDD pin 50")
conn(GND, (U1, "57"), (U1, "19"))          # EP, TESTEN
conn("USB_DP", (U1, "47")); conn("USB_DM", (U1, "46"))
passive("R", "27R", "USB_CONN_DP", "USB_DP", "USB D+ series")
passive("R", "27R", "USB_CONN_DM", "USB_DM", "USB D- series")

# crystal: 15 pF each side, 1k in series with XOUT
block("clock")
Y1 = part("Y", "12MHz", XTAL4, "Crystal:Crystal_SMD_3225-4Pin_3.2x2.5mm", "C20625731", desc="Abracon ABM8-272-T3")
conn("XIN", (U1, "20"), (Y1, "1"))
conn("XOUT", (U1, "21"))
conn("XTAL_OUT", (Y1, "3"))
conn(GND, (Y1, "2"), (Y1, "4"))
passive("R", "1k", "XOUT", "XTAL_OUT", "crystal drive limit")
passive("C", "15pF", "XIN", GND, "crystal load")
passive("C", "15pF", "XTAL_OUT", GND, "crystal load")

# flash
U2 = part("U", "W25Q128JVS", W25Q, "Package_SO:SOIC-8_5.3x5.3mm_P1.27mm", "C97521", ref="U2")
conn("QSPI_SS", (U1, "56"), (U2, "1"))
conn("QSPI_SD1", (U1, "55"), (U2, "2"))
conn("QSPI_SD2", (U1, "54"), (U2, "3"))
conn("QSPI_SD0", (U1, "53"), (U2, "5"))
conn("QSPI_SCLK", (U1, "52"), (U2, "6"))
conn("QSPI_SD3", (U1, "51"), (U2, "7"))
conn(V33, (U2, "8")); conn(GND, (U2, "4"))
passive("C", "100nF", V33, GND, "flash VCC")

# BOOTSEL: QSPI_SS to GND through 1k; RESET: RUN to GND
SW1 = part("SW", "BOOTSEL", SW, "Button_Switch_SMD:SW_SPST_TS-1088-xR020", "C720477", desc="XUNPU TS-1088-AR02016")
passive("R", "1k", "QSPI_SS", "BOOTSEL_SW", "BOOTSEL")
conn("BOOTSEL_SW", (SW1, "1")); conn(GND, (SW1, "2"))
SW2 = part("SW", "RESET", SW, "Button_Switch_SMD:SW_SPST_TS-1088-xR020", "C720477", desc="XUNPU TS-1088-AR02016")
conn("RUN", (U1, "26"), (SW2, "1")); conn(GND, (SW2, "2"))
passive("R", "10k", V33, "RUN", "RUN pull-up; RP2040 has a weak internal one, this adds noise margin")
conn("SWCLK", (U1, "24")); conn("SWDIO", (U1, "25"))

# RP2040 pin of each GPIO
GPIO_PIN = {n: str(n + 2) if n <= 7 else None for n in range(30)}
GPIO_PIN.update({8: "11", 9: "12", 10: "13", 11: "14", 12: "15", 13: "16", 14: "17", 15: "18",
                 16: "27", 17: "28", 18: "29", 19: "30", 20: "31", 21: "32", 22: "34", 23: "35",
                 24: "36", 25: "37", 26: "38", 27: "39", 28: "40", 29: "41"})

if not STICK:   # the hood and W boards: two RS-232 transceivers on a DB25
    # --- §4.5 RS-232: chip A (DCE, SP3238E) and chip B (DTE, MAX3243E) -----------
    block("rsa")
    UA = part("U", "SP3238EEA", SP3238E, "Package_SO:SSOP-28_5.3x10.2mm_P0.65mm", "C49669",
              desc="MaxLinear SP3238EEA-L/TR, chip A, DCE", ref="U5")
    block("rsb")
    UB = part("U", "MAX3243EIDBR", MAX3243E, "Package_SO:SSOP-28_5.3x10.2mm_P0.65mm", "C353887",
              desc="TI MAX3243EIDBR, chip B, DTE", ref="U6")


    def charge_pump(u, c1p, c1m, c2p, c2m, vp, vm, vcc, gnd, tag):
        conn(f"{tag}_C1P", (u, c1p)); conn(f"{tag}_C1M", (u, c1m))
        conn(f"{tag}_C2P", (u, c2p)); conn(f"{tag}_C2M", (u, c2m))
        conn(f"{tag}_VP", (u, vp)); conn(f"{tag}_VM", (u, vm))
        conn(V33, (u, vcc)); conn(GND, (u, gnd))
        passive("C", "220nF", f"{tag}_C1P", f"{tag}_C1M", f"chip {tag[-1]} C1 flying")
        passive("C", "1uF 50V", f"{tag}_C2P", f"{tag}_C2M", f"chip {tag[-1]} C2 flying")
        passive("C", "1uF 50V", f"{tag}_VP", GND, f"chip {tag[-1]} V+ reservoir")
        passive("C", "1uF 50V", f"{tag}_VM", GND, f"chip {tag[-1]} V- reservoir")
        passive("C", "1uF", V33, GND, f"chip {tag[-1]} VCC")
        passive("C", "100nF", V33, GND, f"chip {tag[-1]} VCC")


    block("rsa")
    charge_pump(UA, "28", "25", "1", "3", "27", "4", "26", "2", "CPA")
    block("rsb")
    charge_pump(UB, "28", "24", "1", "2", "27", "3", "26", "25", "CPB")

    block("db25")
    J2 = part("J", "DB25_Female", DB25F, "Connector_Dsub:DSUB-25_Socket_EdgeMount_P2.77mm", "C19601171",
              assembly="hand", desc="MH Connectors MHDB25SS, solder cups straddling the board edge")

    # Each DB25 signal pin: one driver from one chip, one receiver from the other.
    #             net      DB25  chip A pin  chip B pin
    RS232 = [("RS_TXD", "2", "8", "9"),     # A R1IN   / B DOUT1
             ("RS_RXD", "3", "5", "4"),     # A T1OUT  / B RIN1
             ("RS_RTS", "4", "9", "10"),    # A R2IN   / B DOUT2
             ("RS_CTS", "5", "6", "5"),     # A T2OUT  / B RIN2
             ("RS_DSR", "6", "7", "6"),     # A T3OUT  / B RIN3
             ("RS_DCD", "8", "10", "7"),    # A T4OUT  / B RIN4
             ("RS_DTR", "20", "11", "11"),  # A R3IN   / B DOUT3
             ("RS_RI", "22", "12", "8")]    # A T5OUT  / B RIN5
    for net, db, a, b in RS232:
        conn(net, (J2, db), (UA, a), (UB, b))
    conn(GND, (J2, "7"))
    conn("DB25_FG", (J2, "1"))
    passive("R", "0R", "DB25_FG", GND, "frame ground to GND; leave off to float pin 1")
    nc(J2, *[str(n) for n in range(1, 26) if str(n) not in {"1", "2", "3", "4", "5", "6", "7", "8", "20", "22"}])

    # --- §4.6 GPIO map ------------------------------------------------------------
    GPIO = {  # GPIO: (net, chip pin)
        0: ("A_TX", (UA, "24")),      # UART0 TX set A -> T1IN -> pin 3
        1: ("A_RX", (UA, "21")),      # UART0 RX set A <- R1OUT <- pin 2
        2: ("A_CTS", (UA, "20")),     # UART0 CTS set A <- R2OUT <- pin 4 (computer's RTS)
        3: ("A_RTS", (UA, "23")),     # UART0 RTS set A -> T2IN -> pin 5 (CTS to computer)
        4: ("A_DSR", (UA, "22")),     # T3IN -> pin 6
        5: ("A_DCD", (UA, "19")),     # T4IN -> pin 8
        6: ("A_RI", (UA, "17")),      # T5IN -> pin 22
        7: ("A_DTR", (UA, "18")),     # R3OUT <- pin 20
        8: ("B_DTR", (UB, "12")),     # DIN3 -> pin 20
        9: ("B_DSR", (UB, "17")),     # ROUT3 <- pin 6
        10: ("B_DCD", (UB, "16")),    # ROUT4 <- pin 8
        11: ("B_RI", (UB, "15")),     # ROUT5 <- pin 22
        12: ("B_TX", (UB, "14")),     # UART0 TX set B -> DIN1 -> pin 2
        13: ("B_RX", (UB, "19")),     # UART0 RX set B <- ROUT1 <- pin 3
        14: ("B_CTS", (UB, "18")),    # UART0 CTS set B <- ROUT2 <- pin 5
        15: ("B_RTS", (UB, "13")),    # UART0 RTS set B -> DIN2 -> pin 4
        16: ("A_SHDN_N", (UA, "14")), # chip A ~SHUTDOWN, pulled low
        17: ("B_FORCEOFF_N", (UB, "22")),  # chip B ~FORCEOFF, pulled low
        19: ("A_R1OUTB", (UA, "16")), # chip A always-on non-inverting R1 (pin 2)
        20: ("A_STATUS", (UA, "15")), # chip A STATUS, valid in shutdown
        21: ("B_INVALID", (UB, "21")),# chip B INVALID, valid in shutdown
    }
    for g, (net, node) in GPIO.items():
        conn(net, (U1, GPIO_PIN[g]), node)
    # GP18 drives chip A ONLINE and chip B FORCEON together
    conn("RS_FORCEON", (U1, GPIO_PIN[18]), (UA, "13"), (UB, "23"))
    block("rsa")
    passive("R", "100k", "A_SHDN_N", GND, "chip A off until firmware decides")
    block("rsb")
    passive("R", "100k", "B_FORCEOFF_N", GND, "chip B off until firmware decides")
    block("rsa")
    passive("R", "100k", "RS_FORCEON", GND, "auto power-down on until firmware decides")
    nc(UB, "20")  # ROUT2B unused (INVALID covers detection)
if not W:
    conn("VBUS_SENSE", (U1, GPIO_PIN[29]))   # W: on the RM2's GPIO0 instead (SPEC-W §3.3)

if W:
    # --- SPEC-W §3.1 RM2 radio, wired exactly like Pico W ------------------------
    block("radio")
    RM = part("U", "RM2", RM2, "pico-serial:RaspberryPi_RM2", assembly="hand", ref="U7",
              desc="Raspberry Pi RM2 (SC1169), CYW43439; DigiKey 2648-SC1169CT-ND, not at LCSC")
    conn(GND, *[(RM, p) for p in ("1", "4", "7", "11", "15", "21")])
    nc(RM, "2", "19", "20")
    conn("WL_ON", (U1, GPIO_PIN[23]), (RM, "12"), (RM, "13"))   # Wi-Fi and Bluetooth on together
    conn("WL_D", (U1, GPIO_PIN[24]), (RM, "5"))                 # gSPI data in, shared pin
    conn("WL_CS", (U1, GPIO_PIN[25]), (RM, "9"))
    conn("WL_CLK", (U1, GPIO_PIN[29]), (RM, "3"))
    conn(V33, (RM, "14"), (RM, "16"))
    conn("VBUS_SENSE", (RM, "8"))                               # RM2 GPIO0: VBUS present

if LINE:
    # --- SPEC-L §3: the telephone line, Si3056 + Si3019 DAA (datasheet Figure 17) ---
    # Values from the datasheet's bill of materials; parts: LINE_PARTS above.
    def lp(prefix, key, a=None, b=None, ref=None, pins=TWO, assembly="jlc"):
        v, lcsc, fp, desc = LINE_PARTS[key]
        r = part(prefix, v, pins, fp, lcsc, desc=desc, ref=ref, assembly=assembly)
        if a:
            conn(a, (r, "1"))
        if b:
            conn(b, (r, "2"))
        return r

    block("daa")   # system side: the RP2040's 3.3 V and ground
    UD = lp("U", "Si3056", ref="U5", pins=SI3056, assembly="hand")     # DigiKey: by hand, or JLC consigned
    conn(V33, (UD, "4")); conn(GND, (UD, "12"))
    for pin, net, g in (("1", "DAA_MCLK", 21), ("3", "DAA_SCLK", 2), ("2", "DAA_FSYNC", 3), ("5", "DAA_SDO", 4),
                        ("6", "DAA_SDI", 5), ("7", "DAA_FC", 6), ("8", "DAA_RESET_N", 7), ("11", "DAA_INT_N", 8),
                        ("14", "DAA_M0", 9), ("15", "DAA_RGDT_N", 10), ("16", "DAA_OFHK_N", 11)):
        conn(net, (U1, GPIO_PIN[g]), (UD, pin))
    conn("DAA_VA", (UD, "13"))
    passive("C", "100nF", V33, GND, "Si3056 VD (C50)")
    passive("C", "100nF", "DAA_VA", GND, "Si3056 VA (C51)")
    for net in ("DAA_RGDT_N", "DAA_OFHK_N", "DAA_INT_N"):   # R51-R53: ring idle, on hook, no interrupt
        passive("R", "4.7k", V33, net, f"{net} pull-up")
    conn("DAA_C1A", (UD, "10")); conn("DAA_C2A", (UD, "9"))
    lp("R", "56.2R", "DAA_C1A", "DAA_C1A_R")                 # R12
    lp("R", "56.2R", "DAA_C2A", "DAA_C2A_R")                 # R13
    # the isolation barrier: C1, C2 (and C8, C9 below) are all that cross it
    lp("C", "33pF Y2", "DAA_C1A_R", "LS_C1B")
    lp("C", "33pF Y2", "DAA_C2A_R", "LS_C2B")

    block("line")  # line side: its own ground (IGND), no plane. LINE_*: nets at the line's voltage
                   # (TIP, RING and the bridge's +); LS_*: the low-voltage side of the Si3018
    UL = lp("U", "Si3018", ref="U6", pins=SI3018, assembly="hand")
    for pin, net in (("1", "LS_QE"), ("2", "LS_DCT"), ("3", "LS_RX"), ("4", "LS_IB"), ("5", "LS_C1B"), ("6", "LS_C2B"),
                     ("7", "LS_VREG"), ("8", "LS_RNG1"), ("9", "LS_RNG2"), ("10", "LS_VREG2"), ("11", "LS_IGND"),
                     ("12", "LS_QE2"), ("13", "LS_QB"), ("14", "LS_DCT3"), ("15", "LS_IGND"), ("16", "LS_DCT2")):
        conn(net, (UL, pin))
    lp("R", "1.07k 0.5W", "LS_DCT", "LS_TOP")                # R1
    lp("C", "1uF 50V", "LS_TOP", "LS_RX")                    # C4
    lp("R", "1M", "LS_IB", "LS_IGND")                        # R9
    lp("C", "100nF", "LS_VREG", "LS_IGND")                   # C5
    lp("C", "100nF", "LS_VREG2", "LS_IGND")                  # C6
    lp("C", "2.7nF", "LS_TOP", "LS_IGND")                    # C7
    lp("R", "536R 0.25W", "LS_TOP", "LS_E")                  # R10
    lp("R", "3.65k 0.5W", "LS_HB", "LS_DCT2")                # R3
    lp("R", "150R", "LS_DCT2", "LS_Q5B")                     # R2
    lp("R", "73.2R 0.5W", "LS_E", "LS_Q5C")                  # R11
    lp("R", "2.49k 0.5W", "LS_QB", "LS_HB")                  # R4
    lp("R", "100k", "LS_E", "LS_HB")                         # R5
    lp("C", "10nF", "LS_Q2B", "LINE_VP")                       # C10
    lp("R", "100k", "LS_Q2B", "LINE_VP")                       # R6
    lp("C", "10nF 250V", "LS_IGND", "LINE_VP")                 # C3
    lp("R", "20M", "LS_RNG1", "LINE_TIP_F")                    # R7, caller ID
    lp("R", "20M", "LS_RNG2", "LINE_RING_F")                   # R8, caller ID
    z = lp("D", "43V zener", pins=DIODE)                     # Z1
    conn("LS_HB", (z, "1")); conn("LS_QE", (z, "2"))
    for key, b, e, c in (("MMBTA42", "LS_HB", "LS_E", "LINE_VP"),       # Q1
                         ("MMBTA92", "LS_Q2B", "LINE_VP", "LS_HB"),     # Q2 (PNP)
                         ("MMBTA42", "LS_DCT2", "LS_QE", "LS_Q2B"),   # Q3
                         ("MMBT2484", "LS_QB", "LS_QE2", "LS_E"),     # Q4
                         ("MMBT2484", "LS_Q5B", "LS_DCT3", "LS_Q5C")):  # Q5
        q = lp("Q", key, pins=BJT)
        conn(b, (q, "1")); conn(e, (q, "2")); conn(c, (q, "3"))
    # the bridge: two dual diodes, each pair's middle on one wire of the line
    for wire in ("LINE_TIP_F", "LINE_RING_F"):
        d = lp("D", "dual diode", pins=DUALDIODE)
        conn("LS_IGND", (d, "1")); conn("LINE_VP", (d, "2")); conn(wire, (d, "3"))
    lp("FB", "ferrite", "LINE_TIP_F", "LINE_TIP_M")              # FB1
    lp("FB", "ferrite", "LINE_RING_F", "LINE_RING_M")            # FB2
    lp("C", "680pF Y2", "LINE_TIP_M", GND)                     # C8: across the barrier, to the USB ground
    lp("C", "680pF Y2", "LINE_RING_M", GND)                    # C9
    lp("R", "0R line", "LINE_TIP_M", "LINE_TIP_P")               # R15
    lp("R", "0R line", "LINE_RING_M", "LINE_RING_P")             # R16
    lp("RV", "sidactor", "LINE_TIP_P", "LINE_RING_P")            # RV1, surge
    lp("F", "telecom fuse", "LINE_TIP", "LINE_TIP_P")          # power cross (datasheet appendix, Figure 37)
    JL = lp("J", "RJ11", ref="J2", pins=RJ, assembly="hand")          # through hole
    conn("LINE_RING", (JL, "3")); conn("LINE_TIP", (JL, "4"))
    nc(JL, "1", "2", "5", "6")
    nets["LINE_RING"] += nets.pop("LINE_RING_P")               # no fuse on RING: the jack's wire itself
    # GPIOs the stick doesn't use (22, 23: LEDs; 28: test pad; 29: VBUS sense)
    nc(U1, *[GPIO_PIN[g] for g in (0, 1, *range(12, 21), 24, 25, 26, 27)])

if WB:
    # --- SPEC-WB §3: the bare pair, TLV320AIC3204 codec + line transformer ---------
    # Parts: SPEC-WB §8. key -> (value, LCSC, footprint, description)
    WB_PARTS = {
        "codec": ("TLV320AIC3204", "C24109", "Package_DFN_QFN:QFN-32-1EP_5x5mm_P0.5mm_EP3.45x3.45mm",
                  "TI TLV320AIC3204IRHBR stereo codec, 96 kHz"),
        "xfmr": ("PE-65848NL", "C7261159", "pico-serial:Pulse_PE-65848",
                 "Pulse PE-65848NLT line transformer, 1500 Vrms"),
        "60R4": ("60.4R", "C2933247", "Resistor_SMD:R_0603_1608Metric", "1%, line drive"),
        "604R": ("604R", "C32183", "Resistor_SMD:R_0603_1608Metric", "1%, hybrid replica"),
        "1k21": ("1.21k", "C22835", "Resistor_SMD:R_0603_1608Metric", "1%, hybrid replica (cable R)"),
        "10nF C0G": ("10nF C0G", "C2971995", "Capacitor_SMD:C_0805_2012Metric", "hybrid replica (cable C), tune per cable"),
        "1uF 250V": ("1uF 250V", "C381468", "Capacitor_SMD:C_1812_4532Metric", "X7R, DC block (two in series)"),
        "tvs": ("ESDSLC5V0LB", "C2762104", "Diode_SMD:D_0402_1005Metric", "5 V bidirectional TVS, 0.8 pF, DFN1006"),
        "bav99": ("BAV99", "C2500", "Package_TO_SOT_SMD:SOT-23", "two diodes in series, clamp to 3.3 V and ground"),
        "ferrite": LINE_PARTS["ferrite"], "sidactor": LINE_PARTS["sidactor"],
        "telecom fuse": LINE_PARTS["telecom fuse"], "RJ11": LINE_PARTS["RJ11"],
    }

    def wp(prefix, key, a=None, b=None, ref=None, pins=TWO, assembly="jlc"):
        v, lcsc, fp, desc = WB_PARTS[key]
        r = part(prefix, v, pins, fp, lcsc, desc=desc, ref=ref, assembly=assembly)
        if a:
            conn(a, (r, "1"))
        if b:
            conn(b, (r, "2"))
        return r

    block("codec")   # the RP2040's side: 3.3 V, the USB ground
    UC = wp("U", "codec", ref="U5", pins=AIC3204)
    conn(V33, (UC, "6"), (UC, "26"), (UC, "30"))           # IOVDD, LDOIN/HPVDD, LDO_SELECT (D-LDO on)
    conn(GND, (UC, "7"), (UC, "17"), (UC, "28"), (UC, "33"), (UC, "12"), (UC, "8"))   # grounds; I2C mode; MFP3 unused
    for pin, net, g in (("1", "CODEC_MCLK", 21), ("2", "CODEC_BCLK", 2), ("3", "CODEC_WCLK", 3),
                        ("5", "CODEC_DOUT", 4), ("4", "CODEC_DIN", 5), ("10", "CODEC_SDA", 6),
                        ("9", "CODEC_SCL", 7), ("31", "CODEC_RESET_N", 8), ("32", "CODEC_MFP5", 9)):
        conn(net, (U1, GPIO_PIN[g]), (UC, pin))            # I2S on GP2-5 (one PIO block), I2C1 on GP6/7
    nc(UC, "11", "19", "22", "23")                          # MISO/MFP4, MICBIAS, LOL, LOR
    passive("R", "4.7k", V33, "CODEC_SDA", "I2C pull-up")
    passive("R", "4.7k", V33, "CODEC_SCL", "I2C pull-up")
    passive("R", "10k", "CODEC_RESET_N", GND, "codec held in reset until the firmware starts")
    conn("CODEC_AVDD", (UC, "24")); conn("CODEC_DVDD", (UC, "29")); conn("CODEC_REF", (UC, "18"))
    passive("C", "100nF", V33, GND, "codec IOVDD")
    passive("C", "100nF", V33, GND, "codec LDOIN")
    passive("C", "10uF", V33, GND, "codec LDOIN, headphone driver supply")
    passive("C", "100nF", "CODEC_AVDD", GND, "A-LDO output")
    passive("C", "10uF", "CODEC_AVDD", GND, "A-LDO output")
    passive("C", "100nF", "CODEC_DVDD", GND, "D-LDO output")
    passive("C", "10uF", "CODEC_DVDD", GND, "D-LDO output")
    passive("C", "10uF", "CODEC_REF", GND, "reference filter (datasheet 10.2.1.1)")

    block("hybrid")   # SPEC-WB §3: drive, replica, and the codec's mixer subtracts one from the other
    conn("HP_L", (UC, "25")); conn("HP_R", (UC, "27"))
    wp("R", "60R4", "HP_L", "XF_A")                         # line arm: 2 x 60.4 R ~ the pair's 120 R
    wp("R", "60R4", "HP_R", "XF_B")
    wp("R", "604R", "HP_L", "REP_A")                        # replica arm: ten times the impedance
    wp("R", "604R", "HP_R", "REP_B")
    wp("R", "1k21", "REP_A", "REP_M")                       # Zb: the cable's R and C, times ten
    wp("C", "10nF C0G", "REP_M", "REP_B")
    # each mixer input through 1k (current limit for the clamps) and 1 uF (the codec wants AC coupling)
    for node, pin, what in (("XF_A", "13", "IN1_L: P, line +"), ("REP_B", "14", "IN1_R: P, replica -"),
                            ("XF_B", "16", "IN2_R: M, line -"), ("REP_A", "21", "IN3_R: M, replica +")):
        mid = f"MIX_{pin}"
        passive("R", "1k", node, mid, f"{what}: input series R")
        passive("C", "1uF", mid, f"CODEC_IN{pin}", f"{what}: AC coupling")
        conn(f"CODEC_IN{pin}", (UC, pin))
    conn("CODEC_IN_NC", (UC, "15"), (UC, "20"))             # IN2_L, IN3_L unused: together, to ground by 100 nF
    passive("C", "100nF", "CODEC_IN_NC", GND, "unused inputs (datasheet 10.2.2.1)")
    # codec-side protection: whatever the transformer passes of a surge
    d = wp("D", "tvs", "XF_A", "XF_B")
    for node in ("XF_A", "XF_B"):
        c = wp("D", "bav99", pins=DUALDIODE)
        conn(GND, (c, "1")); conn(V33, (c, "2")); conn(node, (c, "3"))

    block("pair")   # line side: no ground. LINE_*: the pair's own voltage; only the transformer crosses
    T1 = wp("T", "xfmr", ref="T1", pins=XFMR8)
    conn("XF_A", (T1, "1")); conn("XF_MID", (T1, "2"), (T1, "3")); conn("XF_B", (T1, "4"))
    conn("LINE_TIP_X", (T1, "8")); conn("LINE_BLK1", (T1, "7")); conn("LINE_BLK2", (T1, "6"))
    conn("LINE_RING_X", (T1, "5"))
    wp("C", "1uF 250V", "LINE_BLK1", "LINE_BLKM")           # DC block: 0.5 uF, 500 V, in the split winding
    wp("C", "1uF 250V", "LINE_BLKM", "LINE_BLK2")
    wp("FB", "ferrite", "LINE_TIP_P", "LINE_TIP_X")
    wp("FB", "ferrite", "LINE_RING", "LINE_RING_X")
    wp("RV", "sidactor", "LINE_TIP_P", "LINE_RING")         # surge
    wp("F", "telecom fuse", "LINE_TIP", "LINE_TIP_P")       # power cross
    JL = wp("J", "RJ11", ref="J2", pins=RJ, assembly="hand")
    conn("LINE_RING", (JL, "3")); conn("LINE_TIP", (JL, "4"))
    nc(JL, "1", "2", "5", "6")
    # GPIOs the stick doesn't use (22, 23: LEDs; 28: test pad; 29: VBUS sense)
    nc(U1, *[GPIO_PIN[g] for g in (0, 1, *range(10, 21), 24, 25, 26, 27)])

# --- §4.8 LEDs: optional on the hood board; fitted on W (SPEC-W §3.2-3.3) -------
block("led")
if W:
    LEDS = (("BT", (U1, GPIO_PIN[22])), ("TR", (U1, GPIO_PIN[26])), ("CD", (U1, GPIO_PIN[27])),
            ("RD", (RM, "18")), ("SD", (RM, "17")))
elif LINE:   # SPEC-L §4: off hook, ringing
    LEDS = (("OH", (U1, GPIO_PIN[22])), ("RI", (U1, GPIO_PIN[23])))
elif WB:     # SPEC-WB: carrier up, data
    LEDS = (("LINK", (U1, GPIO_PIN[22])), ("DATA", (U1, GPIO_PIN[23])))
else:
    LEDS = tuple((name, (U1, GPIO_PIN[g])) for g, name in zip(range(22, 28), ("PWR", "TR", "CD", "SD", "RD", "RI")))
for name, node in LEDS:
    fitted = W or STICK
    led = part("D", f"LED_{name}", DIODE, "LED_SMD:LED_0603_1608Metric", "C2286", dnp=not fitted,
               desc=f"{name} status LED" + ("" if fitted else ", optional"))
    conn(f"LED_{name}", node)
    passive("R", "1k", f"LED_{name}", f"LED_{name}_A", f"{name} LED current", dnp=not fitted)
    conn(f"LED_{name}_A", (led, "2")); conn(GND, (led, "1"))

# --- test pads ----------------------------------------------------------------
block("tp")
if not W:
    conn("GP28", (U1, GPIO_PIN[28]))
SERIAL_TPS = ((("DAA_SCLK", "SCLK"), ("DAA_FSYNC", "FSYNC"), ("DAA_SDO", "SDO"), ("DAA_SDI", "SDI")) if LINE else
              (("CODEC_BCLK", "BCLK"), ("CODEC_WCLK", "WCLK"), ("CODEC_DOUT", "DOUT"), ("CODEC_DIN", "DIN")) if WB else
              (("A_TX", "A_TX"), ("A_RX", "A_RX"), ("B_TX", "B_TX"), ("B_RX", "B_RX")))
for net, label in ((VBUS, "VBUS"), (V33, "3V3"), (V11, "1V1"), (GND, "GND"), ("SWCLK", "SWCLK"),
                   ("SWDIO", "SWDIO"), ("RUN", "RUN"), ("GP28", "GP28")) + SERIAL_TPS:
    if not (W and net == "GP28"):
        tp(net, label)

if W:
    # RM2 data-out and host-wake share GP24 through resistors, as on Pico W
    block("radio")
    passive("R", "470R", "WL_DOUT", "WL_D", "RM2 data out to the shared GP24")
    conn("WL_DOUT", (RM, "6"))
    passive("R", "10k", "WL_IRQ", "WL_D", "RM2 host wake to the shared GP24")
    conn("WL_IRQ", (RM, "10"))
    passive("C", "10uF", V33, GND, "RM2 Vin")
    passive("C", "100nF", V33, GND, "RM2 Vin")
    passive("C", "22uF", V33, GND, "RM2 bulk, for Wi-Fi transmit peaks")
    # SPEC-W §4.5 pairing button, reached through a pinhole in the hood
    SW3 = part("SW", "PAIR", SW, "Button_Switch_SMD:SW_SPST_TS-1088-xR020", "C720477",
               desc="XUNPU TS-1088-AR02016, pairing")
    conn("PAIR_BTN", (U1, GPIO_PIN[28]), (SW3, "1")); conn(GND, (SW3, "2"))


# ===========================================================================
# Checks
# ===========================================================================
def pin_type(ref, pin):
    return parts[ref]["pins"][pin][1]


def check():
    errs, warns = [], []
    on_net = {n for members in nets.values() for n in members}
    for ref, p in parts.items():
        for pin, (name, ty) in p["pins"].items():
            if (ref, pin) not in on_net and (ref, pin) not in noconnect:
                errs.append(f"{ref}.{pin} ({name}) is not connected and not marked NC")
            if (ref, pin) in on_net and (ref, pin) in noconnect:
                errs.append(f"{ref}.{pin} ({name}) is marked NC but on a net")
            if ty == NC and (ref, pin) in on_net:
                errs.append(f"{ref}.{pin} is a no-connect pin but on a net")
    for net, members in nets.items():
        refs = {r for r, _ in members}
        if len(members) < 2:
            errs.append(f"net {net} has only one pin: {members}")
        elif len(refs) < 2 and net not in SUPPLIES:
            warns.append(f"net {net} only joins pins of {refs.pop()}")
        drivers = [f"{r}.{p}" for r, p in members if pin_type(r, p) in (O, PO)]
        if len(drivers) > 1:
            errs.append(f"net {net} has {len(drivers)} outputs: {drivers}")
        for r, p in members:
            if pin_type(r, p) == PI and net not in SUPPLIES:
                errs.append(f"{r}.{p} is a power input on non-supply net {net}")
    for net, *_ in ([] if STICK else RS232):
        kinds = sorted(pin_type(r, p) for r, p in nets[net] if r in (UA, UB))
        if kinds != [I, O]:
            errs.append(f"RS-232 line {net} needs one driver and one receiver, has {kinds}")
    return errs, warns


def sym_text(libdir, lib, name):
    """One symbol's text, from a KiCad 9 single-file library or a KiCad 10 .kicad_symdir."""
    d = os.path.join(libdir, f"{lib}.kicad_symdir", f"{name}.kicad_sym")
    if os.path.exists(d):
        return open(d).read()
    t = open(os.path.join(libdir, f"{lib}.kicad_sym")).read()
    i = t.index(f'\n\t(symbol "{name}"') + 2
    depth = 0
    for j in range(i, len(t)):
        depth += {"(": 1, ")": -1}.get(t[j], 0)
        if depth == 0:
            return t[i:j + 1]
    raise ValueError(name)


def parse_sym(libdir, lib, name):
    t = sym_text(libdir, lib, name)
    m = re.search(r'\(extends "([^"]+)"\)', t)
    if m:
        return parse_sym(libdir, lib, m.group(1))
    return {m.group(3): m.group(2) for m in
            re.finditer(r'\(pin (\w+) \w+.*?\(name "([^"]*)".*?\(number "([^"]*)"', t, re.S)}


def verify_libs(symdir, fpdir):
    errs = []
    done = set()
    for ref, p in parts.items():
        key = (id(p["pins"]), p["footprint"])
        if key in done:
            continue
        done.add(key)
        if symdir:
            sym = SYMBOLS.get(id(p["pins"]))
            if sym:
                lib_pins = parse_sym(symdir, *sym)
                if set(lib_pins) != set(p["pins"]):
                    errs.append(f"{ref}: pin numbers differ from {sym}: {sorted(set(lib_pins) ^ set(p['pins']))}")
                for num, (name, _) in p["pins"].items():
                    if num in lib_pins and lib_pins[num] not in (name, "~", "") and name != "~":
                        errs.append(f"{ref}.{num}: name {name!r} but KiCad {sym[1]} says {lib_pins[num]!r}")
        if fpdir:
            lib, fp = p["footprint"].split(":")
            path = os.path.join(LOCAL_FP if lib == "pico-serial" else fpdir, f"{lib}.pretty", f"{fp}.kicad_mod")
            if not os.path.exists(path):
                errs.append(f"{ref}: footprint {p['footprint']} not found")
                continue
            pads = set(re.findall(r'\(pad "([^"]+)"', open(path).read()))
            missing = set(p["pins"]) - pads
            if missing:
                errs.append(f"{ref}: footprint {fp} has no pad for pins {sorted(missing)}")
            extra = pads - set(p["pins"])
            if extra:
                errs.append(f"{ref}: footprint {fp} has pads with no pin: {sorted(extra)}")
    return errs


# ===========================================================================
# Output
# ===========================================================================
def q(s):
    return '"' + str(s).replace("\\", "\\\\").replace('"', '\\"') + '"'


def natural(s):
    return [int(t) if t.isdigit() else t for t in re.split(r"(\d+)", s)]


def write_kicad(path):
    ns = uuid.UUID("6a1f6c1e-6f1d-4a43-9a52-0c0de5e2a1aa")
    out = ["(export (version \"E\")",
           f"  (design (source \"build_netlist.py\") (date {q(DATE)}) "
           "(tool \"pico-serial build_netlist.py\"))",
           "  (components"]
    for ref in sorted(parts, key=natural):
        p = parts[ref]
        sym = SYMBOLS.get(id(p["pins"])) or ("pico-serial", p["value"])
        if p["pins"] is TWO:
            sym = ("Device", "R" if ref.startswith("R") else "C" if ref.startswith("C") else "Polyfuse")
        if p["pins"] is DIODE:
            sym = ("Device", "LED" if p["value"].startswith("LED") else "D_Zener")
        fields = [f"(field (name \"LCSC\") {q(p['lcsc'])})"] if p["lcsc"] else []
        if p["dnp"]:
            fields.append("(field (name \"DNP\") \"DNP\")")
        if p["desc"]:
            fields.append(f"(field (name \"Description\") {q(p['desc'])})")
        out.append(f"    (comp (ref {q(ref)}) (value {q(p['value'])}) (footprint {q(p['footprint'])})"
                   + (f" (fields {' '.join(fields)})" if fields else "")
                   + f" (libsource (lib {q(sym[0])}) (part {q(sym[1])}) (description \"\"))"
                   + " (sheetpath (names \"/\") (tstamps \"/\"))"
                   + f" (tstamps {q(uuid.uuid5(ns, ref))}))")
    out.append("  )")
    out.append("  (nets")
    for code, net in enumerate(sorted(nets, key=natural), 1):
        out.append(f"    (net (code {q(code)}) (name {q('/' + net if net not in SUPPLIES else net)})")
        for r, pin in sorted(nets[net], key=lambda m: (natural(m[0]), natural(m[1]))):
            name, ty = parts[r]["pins"][pin]
            out.append(f"      (node (ref {q(r)}) (pin {q(pin)}) (pinfunction {q(name)}) (pintype {q(ty)}))")
        out.append("    )")
    out.append("  )")
    out.append(")")
    open(path, "w").write("\n".join(out) + "\n")


def write_md(path):
    L = ["<!-- SPDX-License-Identifier: CERN-OHL-S-2.0 -->", "<!-- Copyright (C) 2026 D-Modem Authors -->",
         f"# pico-serial{' W' if W else ' Line' if LINE else ' WB' if WB else ''} netlist", "",
         "Generated by `build_netlist.py`; edit that script, not this file.", "",
         f"{len(parts)} parts, {len(nets)} nets. DNP = not fitted by default.", "",
         "## Nets", "", "| Net | Pins |", "|---|---|"]
    for net in sorted(nets, key=natural):
        pins = ", ".join(f"{r}.{p} ({parts[r]['pins'][p][0]})" if parts[r]["pins"] is not TWO else f"{r}.{p}"
                         for r, p in sorted(nets[net], key=lambda m: (natural(m[0]), natural(m[1]))))
        L.append(f"| `{net}` | {pins} |")
    L += ["", "## Parts", "", "| Ref | Value | LCSC | Footprint | Note |", "|---|---|---|---|---|"]
    for ref in sorted(parts, key=natural):
        p = parts[ref]
        note = "; ".join(x for x in (p["desc"], p["note"], "DNP" if p["dnp"] else "",
                                     "hand-soldered" if p["assembly"] == "hand" else "") if x)
        L.append(f"| {ref} | {p['value']} | {p['lcsc']} | `{p['footprint']}` | {note} |")
    L += ["", "## Not connected (on purpose)", ""]
    for ref, pin in sorted(noconnect, key=lambda m: (natural(m[0]), natural(m[1]))):
        L.append(f"- {ref}.{pin} ({parts[ref]['pins'][pin][0]})")
    open(path, "w").write("\n".join(L) + "\n")


def write_bom(path):
    groups = defaultdict(list)
    for ref, p in parts.items():
        if p["dnp"] or p["assembly"] != "jlc":
            continue
        groups[(p["value"], p["footprint"], p["lcsc"])].append(ref)
    L = ["Comment,Designator,Footprint,LCSC Part #"]
    for (value, fp, lcsc), refs in sorted(groups.items(), key=lambda kv: natural(sorted(kv[1], key=natural)[0])):
        L.append(f"{value},\"{','.join(sorted(refs, key=natural))}\",{fp.split(':')[1]},{lcsc}")
    open(path, "w").write("\n".join(L) + "\n")


def write_pins_header(path):
    """GPIO numbers for the firmware, from the same nets the board is built from."""
    by_net = {}
    for net, members in nets.items():
        for r, pin in members:
            if r == U1 and pin in GPIO_PIN.values():
                g = next(n for n, pp in GPIO_PIN.items() if pp == pin)
                by_net[net] = g
    L = ["/*", " * SPDX-License-Identifier: AGPL-3.0-only", " * Copyright (C) 2026 D-Modem Authors", " */",
         "// Generated by hardware/netlist/build_netlist.py from the board's nets. Do not edit.",
         "#pragma once", ""]
    for net, g in sorted(by_net.items(), key=lambda kv: kv[1]):
        L.append(f"#define PIN_{net:<16} {g:>2}   // GP{g}")
    if W:   # the radio module's own GPIOs, driven through the CYW43 driver
        L += ["", "// RM2 (CYW43439) GPIOs: cyw43_arch_gpio_get/put"]
        for net, members in sorted(nets.items()):
            for r, pin in members:
                if r == "U7" and RM2[pin][0].startswith("GPIO"):
                    L.append(f"#define WLGPIO_{net:<14} {RM2[pin][0][4:]:>2}   // RM2 pin {pin}")
    os.makedirs(os.path.dirname(path), exist_ok=True)
    open(path, "w").write("\n".join(L) + "\n")


def main():
    ap = argparse.ArgumentParser(description=__doc__.split("\n")[0])
    ap.add_argument("--kicad-sym", help="kicad-symbols checkout, to verify pin tables")
    ap.add_argument("--kicad-fp", help="kicad-footprints checkout, to verify footprints")
    ap.add_argument("--variant", choices=VARIANTS, default=VARIANT, help="which board (default: hood)")
    a = ap.parse_args()
    errs, warns = check()
    if a.kicad_sym or a.kicad_fp:
        errs += verify_libs(a.kicad_sym, a.kicad_fp)
    for w in warns:
        print("warning:", w)
    for e in errs:
        print("ERROR:", e)
    if errs:
        sys.exit(1)
    write_kicad(os.path.join(HERE, f"pico-serial{SUFFIX}.net"))
    write_md(os.path.join(HERE, f"NETLIST{SUFFIX}.md"))
    write_bom(os.path.join(HERE, f"bom-jlc{SUFFIX}.csv"))
    write_pins_header(os.path.join(HERE, "..", "..", "firmware", "src", "generated",
                                   f"board_pins{SUFFIX.replace('-', '_')}.h"))
    fitted = sum(1 for p in parts.values() if not p["dnp"])
    print(f"ok ({VARIANT}): {len(parts)} parts ({fitted} fitted), {len(nets)} nets, "
          f"{sum(len(m) for m in nets.values())} connections, {len(noconnect)} pins left open on purpose")


if __name__ == "__main__":
    main()
