D-Modem/hardware/firmware/src/core/core.h

/*
 * SPDX-License-Identifier: AGPL-3.0-only
 * Copyright (C) 2026 D-Modem Authors
 */
// The serial core: which role the board is in, what the modem lines do,
// flow control, and the bytes between the host link and the RS-232 port.
// Portable: hardware access goes through hal.h. See SPEC.md section 5.
#pragma once
#include <stdbool.h>
#include <stdint.h>
#include "autobaud.h"
#include "hal.h"
#include "protocol.h"
#include "ring.h"

#define CORE_DETECT_PERIOD_MS 50u    // sample the detect lines this often
#define CORE_DETECT_CONFIRM 3u       // ... this many times in a row before switching on
#define CORE_LOST_MS 1000u           // peer gone this long: back to detecting
#define CORE_SETTLE_MS 100u          // after switching off, before detecting again
#define CORE_SAVE_DELAY_MS 500u      // settle before writing settings to flash
#define CORE_LED_PULSE_MS 30u
#define CORE_AB_ERRORS 3u            // this many framing errors...
#define CORE_AB_WINDOW_MS 2000u      // ...this close together: learn the baud rate again
#define CORE_AB_TRY_MS 20u           // while data keeps coming, look for the rate this often
#define CORE_AB_LONG_MS 10000u       // a run this long is just "long" (the timer would wrap)
#define CORE_RUNS 128u               // runs from the interrupt, waiting for core_poll

// LEDs, in the order of the front panel
#define CORE_LED_PWR 0x01
#define CORE_LED_TR 0x02
#define CORE_LED_CD 0x04
#define CORE_LED_SD 0x08
#define CORE_LED_RD 0x10
#define CORE_LED_RI 0x20

// CDC SERIAL_STATE bits (USB CDC PSTN 6.5.4)
#define SS_DCD 0x01
#define SS_DSR 0x02
#define SS_BREAK 0x04
#define SS_RI 0x08
#define SS_FRAMING 0x10
#define SS_PARITY 0x20
#define SS_OVERRUN 0x40
#define SS_EVENTS (SS_BREAK | SS_FRAMING | SS_PARITY | SS_OVERRUN)

// UART receive error flags, from the interrupt
#define RX_ERR_FRAMING 0x01
#define RX_ERR_PARITY 0x02
#define RX_ERR_BREAK 0x04
#define RX_ERR_OVERRUN 0x08

typedef struct {
    uint8_t mode;   // ps_mode
    uint8_t flow;   // ps_flow
    uint8_t baud;   // ps_baud
} core_settings_t;

typedef enum { ST_DETECT, ST_ACTIVE, ST_SETTLE } core_state_t;
typedef enum { AB_OFF, AB_LEARNING, AB_LOCKED } core_ab_state_t;

typedef struct {
    core_settings_t settings;
    core_state_t state;
    uint8_t role;
    uint32_t t_state;       // when the current state began
    uint32_t t_sample;      // last detect sample
    uint8_t seen_dce, seen_dte;
    uint32_t t_lost;        // peer missing since (0 = present)

    uint8_t host_lines;     // PS_LINE_DTR / RTS from the host
    int8_t host_dcd;        // DCE: -1 = DCD follows the host's DTR; 0/1 = set by the link (link.h)
    uint8_t override_mask, override_value;
    uint8_t outputs, inputs;
    bool rx_room;           // hysteresis on the to-host buffer
    bool cts_latched;       // FLOW_AUTO: the far end has used its flow line
    bool hw_cts;

    uart_format_t format;   // as the host set it
    uart_format_t uart;     // what the UART runs at: the host's, or with the learned baud
    uint8_t info_flags;
    uint32_t break_until;   // 0 = no timed break
    bool break_on;

    uint16_t serial_state_sent;
    bool serial_state_valid;
    volatile uint8_t rx_errors;   // set by the UART interrupt

    bool settings_dirty;
    uint32_t t_dirty;

    uint32_t t_sd, t_rd;    // LED pulses
    uint32_t seen_to_rs232, seen_from_rs232;
    ps_stats_t stats;

    // baud-rate learning
    volatile uint8_t ab_state;   // core_ab_state_t; read by the UART interrupt
    uint32_t ab_baud;            // learned rate, 0 = none yet
    ab_t ab;                     // runs collected while learning
    uint32_t ab_seen;            // runs added since the last try
    uint32_t ab_found;           // the rate they fit, 0 = not sure yet
    uint32_t t_ab_try, t_run;
    volatile uint8_t ab_fe;      // framing errors while locked (from the interrupt)
    uint8_t ab_fe_seen, ab_win_n;
    uint32_t t_ab_win;
    uint32_t runs[CORE_RUNS];    // from the timing interrupt
    volatile uint32_t runs_head, runs_tail;
    volatile bool runs_lost;

    ring_t to_host;         // RS-232 -> host
    ring_t to_rs232;        // host -> RS-232
} core_t;

extern core_t g_core;

// Reset the core, load the saved settings (or defaults: auto mode, auto flow,
// auto baud) and apply the mode. Call once at startup.
void core_init(core_t *c);
// Call often from the main loop.
void core_poll(core_t *c);

// Host link events
// The host's DTR and RTS (mapped to the RS-232 lines in core_poll).
void core_host_lines(core_t *c, bool dtr, bool rts);
// DCD driven by a link in DCE mode instead of following DTR; -1: follow DTR (the default).
void core_host_dcd(core_t *c, int8_t dcd);
// The host's line coding (CDC values). Unsupported parts (1.5 stop bits,
// mark/space parity, odd data bits) are adjusted and flagged in GET_INFO; a
// learned baud rate stays in force.
void core_host_format(core_t *c, uint32_t baud, uint8_t stop_bits_cdc, uint8_t parity_cdc, uint8_t data_bits);
// Send a break for duration_ms; 0 ends it, 0xFFFF holds it until 0 is sent.
void core_host_break(core_t *c, uint16_t duration_ms);
// Queue data for the RS-232 port and start the UART; returns bytes accepted.
uint32_t core_host_write(core_t *c, const uint8_t *data, uint32_t len);
// Take up to max bytes received from the RS-232 port; returns how many.
uint32_t core_host_read(core_t *c, uint8_t *data, uint32_t max);
// SERIAL_STATE to send to the host; true if it changed (or events are pending).
bool core_serial_state(core_t *c, uint16_t *state);

// Vendor requests. IN: returns length written to buf, or -1 to stall.
int core_vendor_in(core_t *c, uint8_t req, uint16_t value, uint8_t *buf, uint16_t max);
// OUT: false to stall.
bool core_vendor_out(core_t *c, uint8_t req, uint16_t value);

// From the UART interrupt: a received byte and its RX_ERR_* flags. Dropped
// while learning the baud rate (the UART is at the wrong speed); breaks are
// recorded but not passed on as data.
static inline void core_isr_rx(core_t *c, uint8_t byte, uint8_t errors) {
    if (c->ab_state == AB_LEARNING) return;   // received at a rate that's about to change
    if (errors & RX_ERR_FRAMING && c->ab_state == AB_LOCKED) c->ab_fe++;
    if (errors) c->rx_errors |= errors;
    if (!(errors & RX_ERR_BREAK)) {
        if (!ring_put(&c->to_host, byte)) c->stats.dropped++;
        else c->stats.from_rs232++;
    }
}
// The UART can send: hand it the next queued byte, false if there's none.
static inline bool core_isr_tx(core_t *c, uint8_t *byte) {
    if (!ring_get(&c->to_rs232, byte)) return false;
    c->stats.to_rs232++;
    return true;
}

// From the line-timing interrupt (hal_autobaud): one run of a level.
static inline void core_isr_run(core_t *c, bool high, uint32_t ticks) {
    uint32_t h = c->runs_head;
    if (h - c->runs_tail >= CORE_RUNS) { c->runs_lost = true; return; }
    c->runs[h % CORE_RUNS] = (high ? 0x80000000u : 0) | (ticks > AB_IDLE ? AB_IDLE : ticks);
    c->runs_head = h + 1;
}

// Settings blob (for flash), with a checksum.
#define CORE_SETTINGS_BLOB 16u
// Settings -> blob: "PSER", version 1, mode, flow, baud mode, CRC-32.
void core_settings_pack(const core_settings_t *s, uint8_t out[CORE_SETTINGS_BLOB]);
// Blob -> settings; false (settings untouched) if it isn't a valid version-1
// blob or a value is out of range.
bool core_settings_unpack(core_settings_t *s, const uint8_t in[CORE_SETTINGS_BLOB]);
