D-Modem/hardware/firmware/boards/pico_serial_w.h

/*
 * SPDX-License-Identifier: AGPL-3.0-only
 * Copyright (C) 2026 D-Modem Authors
 */
// pico-serial W (SPEC-W.md): the hood board's circuit plus a Raspberry Pi
// RM2 (CYW43439) wired exactly as on Pico W, so the SDK's CYW43 defaults apply.
#ifndef _BOARDS_PICO_SERIAL_W_H
#define _BOARDS_PICO_SERIAL_W_H

pico_board_cmake_set(PICO_PLATFORM, rp2040)
pico_board_cmake_set(PICO_CYW43_SUPPORTED, 1)

#define PICO_SERIAL_W

// No UART/I2C/SPI defaults: every UART pin belongs to the RS-232 transceivers.

// W25Q128JV works with the generic W25Q080 boot stage 2
#define PICO_BOOT_STAGE2_CHOOSE_W25Q080 1
#ifndef PICO_FLASH_SPI_CLKDIV
#define PICO_FLASH_SPI_CLKDIV 2
#endif
pico_board_cmake_set_default(PICO_FLASH_SIZE_BYTES, (16 * 1024 * 1024))
#ifndef PICO_FLASH_SIZE_BYTES
#define PICO_FLASH_SIZE_BYTES (16 * 1024 * 1024)
#endif

// SPEC.md 4.2: margin for the crystal to start
#ifndef PICO_XOSC_STARTUP_DELAY_MULTIPLIER
#define PICO_XOSC_STARTUP_DELAY_MULTIPLIER 64
#endif

#ifndef PICO_RP2040_B0_SUPPORTED
#define PICO_RP2040_B0_SUPPORTED 0
#endif
#ifndef PICO_RP2040_B1_SUPPORTED
#define PICO_RP2040_B1_SUPPORTED 0
#endif

// Bluetooth bonds (BTstack's flash bank): the two sectors below the last
// one, which holds the firmware's settings.
#ifndef PICO_FLASH_BANK_STORAGE_OFFSET
#define PICO_FLASH_BANK_STORAGE_OFFSET (PICO_FLASH_SIZE_BYTES - 3 * 4096)
#endif

// RM2: SPEC-W.md 3.1 (same pins as Pico W)
#ifndef CYW43_WL_GPIO_COUNT
#define CYW43_WL_GPIO_COUNT 3
#endif
#ifndef CYW43_PIN_WL_DYNAMIC
#define CYW43_PIN_WL_DYNAMIC 0
#endif
#ifndef CYW43_DEFAULT_PIN_WL_REG_ON
#define CYW43_DEFAULT_PIN_WL_REG_ON 23u
#endif
#ifndef CYW43_DEFAULT_PIN_WL_DATA_OUT
#define CYW43_DEFAULT_PIN_WL_DATA_OUT 24u
#endif
#ifndef CYW43_DEFAULT_PIN_WL_DATA_IN
#define CYW43_DEFAULT_PIN_WL_DATA_IN 24u
#endif
#ifndef CYW43_DEFAULT_PIN_WL_HOST_WAKE
#define CYW43_DEFAULT_PIN_WL_HOST_WAKE 24u
#endif
#ifndef CYW43_DEFAULT_PIN_WL_CLOCK
#define CYW43_DEFAULT_PIN_WL_CLOCK 29u
#endif
#ifndef CYW43_DEFAULT_PIN_WL_CS
#define CYW43_DEFAULT_PIN_WL_CS 25u
#endif
#endif
