D-Modem/hardware/firmware/test/fake_hal.h

/*
 * SPDX-License-Identifier: AGPL-3.0-only
 * Copyright (C) 2026 D-Modem Authors
 */
#pragma once
#include "../src/core/hal.h"

typedef struct {
    uint32_t now;
    uint8_t xcvr, route;
    int xcvr_calls;
    bool peer_dce, peer_dte;
    uart_format_t format;
    int format_calls;
    bool hw_cts, brk;
    int kicks;
    uint8_t out_role, out, in;
    uint8_t leds;
    uint8_t flash[64];
    bool flash_valid;
    int saves;
    uint8_t ab_role;     // hal_autobaud: which RX line is being timed
    int ab_calls, rx_flushes;
} fake_hw_t;

#define FAKE_AB_HZ 62500000u

extern fake_hw_t hw;
// Back to a fresh board: nothing recorded, clock at 1000 ms.
void fake_reset(void);
