D-Modem/hardware/(commit log)

2026-10-17 Hardware spec: RP2040 USB-C to DB25 (DCE) serial adapter
    Draft spec for a bare-RP2040 board (no Pico module): parts, RP2040
    support circuit, USB-C, MAX3238E DCE wiring and DB25 pinout, firmware
    signal mapping, dmodem-android compatibility, layout, open questions.
    Claude-Session: https://claude.ai/code/session_013PRsUCpxazyipPn5UGGkF8
2026-10-17 Spec 0.2: DCE and DTE on one DB25, sourced parts
    - both roles on one female DB25: a TRS3238E (DCE) and a MAX3243E (DTE)
    on the same pins, one powered at a time, the role auto-detected from
    what's attached (ROUT1B / INVALID still work in shutdown); DTE through
    a male-male gender changer
    - parts checked stocked and buyable at qty 1 (DigiKey/LCSC), with second
    sources and the parts avoided and why
    - solder-cup DB25 straddling the board, Adam Tech hood, target outline
    - LEDs optional, not fitted by default
    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
2026-10-17 Spec 0.3: everything from one LCSC order
    - DCE transceiver: MaxLinear SP3238EEA-L/TR (the only 5T/3R with real
    LCSC stock); its STATUS works in shutdown, so auto-detect reads each
    chip's status output; TI TRS3238E from DigiKey as the fallback if its
    off-state leakage disappoints
    - DTE: TI MAX3243EIDBR; USB-C: HRO TYPE-C-31-M-12
    - DB25 MHDB25SS solder cup and MHDPPK25-K hood from LCSC (qty 1),
    hand-fitted; DigiKey parts kept as backups
    - LCSC part numbers and stock for every line; samples to buy first
    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
2026-10-17 Spec: record why the board has two RS-232 chips
    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
2026-10-17 Hardware netlist: the whole board, generated and checked
    hardware/netlist/build_netlist.py defines every part and connection
    (SPEC 0.3) and writes a KiCad netlist, a readable net list and a JLC
    parts list with LCSC numbers. It refuses to write if a pin is left
    unaccounted for, a net has one pin or two outputs, an RS-232 line lacks
    one driver and one receiver, or a power pin is off a supply; with KiCad
    library checkouts it also checks pin names/numbers against KiCad's
    symbols and pads against the footprints. The two RS-232 chips' pin
    tables come from their datasheets (KiCad has no symbols for them).
    81 parts (69 fitted, 6 LEDs + resistors DNP), 82 nets. Adds a 10k RUN
    pull-up. Not yet import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
    [bom-jlc.csv]
2026-10-17 Schematic: generated from the netlist script, checked against it
    hardware/schematic/build_schematic.py draws pico-serial.kicad_sch (KiCad 9
    format, one A2 sheet) from hardware/netlist/build_netlist.py: parts
    grouped into blocks by function, each pin a short wire to a net label or
    power symbol, no-connect flags on unused pins, PWR_FLAGs on GND and VBUS.
    It refuses to write unless the connectivity read back from the drawing
    matches the netlist exactly and nothing overlaps. The SP3238E and
    MAX3243E get their own symbol library (KiCad has neither); other
    symbols are cached from kicad-symbols 9.0 so it runs offline.
    The netlist now targets KiCad 9.0 libraries: pin names as KiCad 9 has
    them (SWD,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
    [pico-serial.kicad_sch]
2026-10-17 Spec: wireless variant (BLE for iPhone, SPP for Android)
    SPEC-W.md: Raspberry Pi RM2 (CYW43439) wired exactly like a Pico W so the
    SDK's defaults work; its 35.5 x 18.5 mm antenna keep-out doesn't fit a
    DB25 hood, so a separate small-case board is proposed. BLE Nordic UART
    Service for data (generic iOS apps work, no MFi), a control service for
    modem lines/line coding/mode, optional L2CAP channel; classic SPP server
    so dmodem-android's existing Bluetooth client mode works unchanged, with
    DCD-from-result-codes for Android's missing modem lines; pairing window,
    bonding, LE Secure Connections; USB > first wireless link port ownership.
    Claud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
2026-10-17 SPEC-W: enclosure order, avoiding a 3D-printed case
    Try the hood with a Pico W range test first, then a DB25-to-RJ45 modular
    adapter housing (L-com RBA258F or similar), then a Hammond 1551KBK with a
    cut-out; 3D printing only if all fail.
    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
2026-10-17 W hood: 3D-printed DB25 hood, board outline and fit checks
    hardware/enclosure/w_hood.py (CadQuery) models a two-piece printed hood
    (61 x 56 x 15 mm) for the wireless board: DB25 flange captured in a slot,
    captive Keystone 2400 thumbscrews in finger pockets (4.5 mm engagement),
    three M2 self-tapping screws through the board, RM2 at the rear corner
    with its 35.5 x 18.5 mm keep-out in air inside the hood, USB-C beside it,
    LED light tubes and a pairing pinhole on top. Writes STEP/STL for
    printing, an assembly STEP, the board outline and keep-out as DXF, and
    placement rules for the layout; refuses on any collision, metal in the
    keep-out or short thumbscrew engagement (checked by planting faults).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
    [assembly.step, board-outline.dxf, hood-bottom.step, hood-bottom.stl, hood-top.step, hood-top.stl, rf-keepout.dxf]
2026-10-17 Firmware v0.1: USB CDC to RS-232 with DCE/DTE auto-detect
    firmware/: Pico SDK 2.3.1 + TinyUSB 0.21.0 (for CDC SERIAL_STATE).
    - portable core (src/core): role detection from chip A STATUS / chip B
    INVALID with both chips off (3 x 50 ms samples, 1 s loss), modem-line
    mapping (DCE: host DTR -> DCD+DSR, RTS -> CTS; DTE: DTR/RTS through),
    hold-off at 3/4 buffer, FLOW_AUTO latch for 3-wire cables, SERIAL_STATE
    with one-shot error events, line coding with flagged adjustments,
    timed break, settings in flash with CRC
    - RP2040 layer: GPIO with the transceivers' inversion, UART with IRQs and
    per-byte error flags, UART pins routed to the active chip, flash
    settings, watchdog; USB composite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
    [board_config.h, build_netlist.py, core.c, core.h, fake_hal.c, fake_hal.h, hal.h, hal_rp2040.c]
2026-10-18 Licensing: firmware under AGPL-3.0-only or a commercial licence
    Same arrangement as the rest of D-Modem: LICENSING.md, the AGPL text in
    firmware/COPYING, and an SPDX-License-Identifier line in every firmware
    source file (and the generated pin header, via build_netlist.py). Notes
    the third-party parts (Pico SDK, picotool, TinyUSB, rp2040js, the boot
    ROM, KiCad symbols). The hardware's licence is not yet decided.
    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
2026-10-18 Licensing: hardware under CERN-OHL-S-2.0 or a commercial licence
    - hardware/LICENSE: CERN-OHL-S-2.0 text (SPDX license-list-data)
    - SPDX lines on the hardware scripts and specs, and in the generated
    NETLIST.md and placement.md; the schematic's title block names the
    licence and the Source Location
    - Notice under section 4: products display the Source Location; the hood
    has github.com/Neo-Desktop/pico-serial and CERN-OHL-S-2.0 debossed
    underneath, and SPEC.md asks for both on the silkscreen
    - LICENSING.md: hardware section, Source Location, what's covered, the
    KiCad library exception, Available Components; notes the repository
    must be public before products are shared
    Co-Authored-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
    [assembly.step, board-outline.dxf, hood-bottom.step, hood-bottom.stl, hood-top.step, pico-serial.kicad_sch, rf-keepout.dxf]
2026-10-18 Firmware: learn the far end's baud rate (auto-baud)
    As DCE the board now works out the computer's baud rate from what it
    types, like a Hayes modem, so the host's speed setting doesn't have to
    match the terminal's.
    - PIO (autobaud.pio) times each low/high stretch on the RX pin while the
    UART keeps the pin.
    - src/core/autobaud.c decodes those timings at every standard rate
    (110-230400) and picks the one they fit: bit length vs the shortest
    stretch, edges on bit boundaries, framing/parity, then the slowest rate
    whose edges score near the best.
    - The characters it learned from ("AT") are decoded and passed on; the
    UART switches only once the line is idle.
    - Re-learns on 3 framing erro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
    [autobaud.c, autobaud.h, core.c, core.h, fake_hal.c, fake_hal.h, hal.h, hal_rp2040.c]
2026-10-18 Auto-baud: don't lock on a single character
    A rate too fast can split one character (a lone CR, as Enter sends on
    many terminals) into two "characters", which passed the 2-character
    rule: a lone CR locked onto the wrong rate in 80% of trials. Now the
    rate is chosen first, and the 2 characters are counted only at that
    rate, so one character waits.
    Tests: one-character cases (CR, LF, 0x55, 0xFF...) at every rate must
    not decide; CR LF and CR CR must lock and decode at every rate. Docs
    note that Enter (CR LF), or Enter twice on a CR-only terminal, is
    enough to learn the rate.
    Claude-Session: https://claude.ai/code/session_013PRsUCpxazyip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
    [autobaud.c, test_autobaud.c]
2026-10-18 Hardware: start the PCB (placed, not yet routed)
    - hardware/schematic -> hardware/kicad, so the schematic and PCB are one
    KiCad project.
    - kicad/build_pcb.py lays out the board from the netlist script with
    KiCad 9's Python module: outline (SPEC 7.2, inferred), JLC 4-layer
    rules and net classes, footprints linked to their schematic symbols,
    placement on both sides, a GND plane on In1, a via for every GND and
    +3V3 pad, silkscreen (licence and Source Location), and optional
    autorouting with Freerouting and fab outputs.
    - kicad/pico-serial.kicad_dru: edge rules for the DB25 cups and USB-C.
    - The committed board is placed but unrouted; routing comes next.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
    [pico-serial.kicad_pcb, pico-serial.kicad_sch]
2026-10-18 Hardware: route the PCB; DRC clean, matches the schematic
    - Routed with Freerouting 1.9 (rounds, each from the last) plus a small
    A* grid router in build_pcb.py for what it leaves; deterministic, and
    it tries a few pass counts if one leaves anything.
    - In1.Cu solid GND; In2.Cu signals then a +3V3 pour; GND pours top and
    bottom. Every GND/+3V3 pad has its own via (U1's +3V3 inward, under
    the package); USB-C D+/D- corridor kept clear of vias.
    - Net names come from KiCad's own export of the schematic, so DRC's
    schematic parity check passes; DNP/BOM flags match the symbols.
    - Edge keep-out band (Freerouting ignores KiCad's edge clearance) and
    keep-outs around the USB-C's plastic pegs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
    [pico-serial.kicad_pcb]
2026-10-18 hardware: lay out and route the 4-layer PCB
    build_pcb.py builds the board from the schematic: outline, JLC rules,
    net classes, placement on both sides, GND/+3V3 fanout, Freerouting 1.9
    plus a rip-up finisher, then pours. DRC, ERC and schematic parity are
    clean. Adds Gerbers, drill and JLC placement files, renders, docs, and a
    CI workflow that checks ERC, DRC and parity.
    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
    [pico-serial.kicad_pcb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]
2026-10-18 hardware: W variant netlist and schematic (RM2 Bluetooth)
    build_netlist.py and build_schematic.py take --variant w: the RM2 wired
    as on Pico W (GP23-25, GP29), fitted LEDs (two on the RM2's GPIOs), VBUS
    sense on RM2 GPIO0 and a pairing button on GP28. Adds the RM2 symbol and
    a footprint generated from the datasheet's Figure 6, and the W pin header
    for the firmware. The design date is now fixed, so regenerating on a
    later day leaves the files unchanged.
    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
    [bom-jlc-w.csv, pico-serial-w.kicad_sch]
2026-10-18 hardware: W board placement, keep-outs and CI checks
    build_pcb.py takes --variant w: the outline, RM2, USB-C, LEDs, pairing
    button and screw holes come from the printed hood's script; the antenna
    keep-out has no copper on any layer. The front half is placed as on the
    hood board. CI now checks both boards. Routing follows.
    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
2026-10-18 hardware: M2 screw-hole footprint for the W board; footprint script renamed
    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
2026-10-18 firmware: Bluetooth for pico-serial W (BLE NUS, SPP, pairing)
    PS_BOARD=w builds for the W board: the RM2 wired as on Pico W, with
    BTstack polled from the main loop.
    - Classic SPP server ("pico-serial", RFCOMM 1) with credit-based flow
    control; LE Nordic UART Service plus the pico-serial control service
    (line coding, outputs, inputs, mode, break, flow, credits, info).
    - Port ownership (SPEC-W 4.6) in a new portable links layer
    (src/core/link.c): USB with its port open, else the first wireless
    link, else USB. The wired boards behave as before.
    - Over SPP, DCD follows the phone's CONNECT / NO CARRIER.
    - Pairing only in a 2-minute window (at power-up with no bonds, PAIR
    button, or a n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
2026-10-18 hardware: finisher treats oval pads as stadiums, not rectangles
    A link started at a rectangle's corner, off the oval's copper, and never
    counted as connected (the W board's USB-C shield legs).
    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
2026-10-18 docs: pico-serial W board in the hardware README; SPEC-W next steps
    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
2026-10-18 hardware: route pico-serial W; fab files and renders
    Fully routed (Freerouting at 50 passes, then the finisher): DRC 0
    violations, 0 unconnected, matches its schematic; ERC clean. No copper in
    the antenna keep-out. Gerbers and the JLC placement file in fab/.
    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
    [pico-serial-w.kicad_pcb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]
2026-10-18 firmware: document every core function; add a check for it
    tools/check_docs.py lists functions with no comment (public ones count
    as documented by their header prototype); CI runs it.
    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
2026-10-22 Line stick: spec, netlist and schematic (Si3056 + Si3018 DAA)
    pico-serial Line, a USB-C phone-line stick shaped like Apple's USB Modem:
    a softmodem whose modem is D-Modem-RE on the host. SPEC-L.md covers the
    architecture, the DAA (Si3056 for 9600 Hz sampling, so D-Modem's V.90
    works), the USB interface, mechanics and compliance.
    build_netlist.py and build_schematic.py take --variant line: the Si3056
    datasheet's typical application (Figure 17) with a 1.25 A telecom fuse,
    parts checked against JLCPCB stock. New footprints for the RJ11 and the
    fuse; the symbol cache now keeps every board's symbols. ERC clean.
    Claude-Session: https://clau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
    [bom-jlc-line.csv, pico-serial-line.kicad_sch]
2026-10-22 Line stick: 3D-printed shell and PCB placement
    enclosure/stick.py makes the 82 x 24 x 20 mm stick: RJ11 flush with one
    end, USB-C in an overmould opening at the other, two LED light tubes, one
    M2 screw on the USB side of the isolation gap; it checks the fit and
    writes the board outline and placement.
    build_pcb.py --variant line places the board on that outline: the line
    side (no planes) toward the RJ11, a 2.5 mm isolation gap that only the four
    Y2 capacitors cross, the Si3056 and the RP2040 core toward USB-C. A DRU rule
    holds 2.5 mm between line and USB-side copper. Fanout vias now respect
    every no-via rule area (unchanged for the hood and W boards).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
    [assembly.step, board-outline.dxf, stick-bottom.step, stick-bottom.stl, stick-top.step, stick-top.stl]
2026-10-22 docs: the Line stick in the hardware and enclosure READMEs
    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
2026-10-22 firmware: phone-line stick (PS_BOARD=line), Si3056 DAA over USB
    pico-serial Line's firmware: a USB front end for its Si3056 + Si3018 DAA,
    the modem itself being D-Modem on the host (SPEC-L.md).
    - Si3056 bring-up: 48 MHz MCLK from the USB PLL on GPIO21, reset in
    serial mode 0, PLL1 N = 125 / M = 256, 9600 Hz, 16-bit mode, line side
    powered up; FDT checked.
    - si3056.pio: the RP2040 as the serial port's slave; every word through
    the portable frame engine (daa_frame.c) from the PIO's interrupt.
    Register accesses ride in secondary frames (LSB flag, then FC pin).
    - USB: one vendor interface shaped like the SmartUSB56's (alt 1:
    isochronous OUT/IN at 1 ms, IN lengths set by the codec's cl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
    [board_config.h, daa.c, daa.h, daa_frame.c, daa_frame.h, line_dev.c, line_dev.h, line_hal.h]
2026-10-22 Line stick: line-voltage net class; the finisher keeps out of rule areas
    The finishing router ignored rule areas: on the Line board it ran tracks
    through the isolation gap and a screw's keep-out. It now treats every
    no-track / no-via rule area as blocked (the hood and W boards had none of
    their tracks there).
    TIP, RING and the bridge's + (now LINE_*) keep 0.4 mm clearance; the
    Si3018's low-voltage side (LS_*) gets 0.25 mm, so the line side can route.
    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
    [pico-serial-line.kicad_sch]
2026-10-22 build_pcb: finisher fixes found on the Line board
    - Clearance to another net is the larger of the two nets' classes, as in
    KiCad's DRC (it used the routed net's own: 0.25 mm next to TIP/RING).
    - A failed rip-up restores every track as it was before it, rebuilt from
    a record: undoing one level re-added its own ripped tracks over routes a
    deeper level had made (shorts), and re-adding removed objects across
    nested levels crashed KiCad's Python binding.
    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
    [build_pcb.py]
2026-10-22 build_pcb: rip-up records copy coordinates (KiCad's vectors are views into the object)
    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
2026-10-22 Line stick: Microsoft OS 2.0 descriptors, so Windows binds WinUSB itself
    The stick is now USB 2.1 with a BOS descriptor whose Microsoft OS 2.0
    platform capability names vendor request 0x4D (LP_REQ_MS_OS_20). Windows
    reads the descriptor set with it (device, IN, wIndex 7). The set gives
    both interfaces the compatible ID WINUSB and a DeviceInterfaceGUID:
    - the line interface gets D-Modem's {0463C853-BB62-4057-9E76-D14B0E3ACAFD},
    the GUID its dmodem-usb.inf uses;
    - the reset interface gets the Pico SDK's, so picotool works too.
    dmodemd --usb (libusb) and picotool then work on Windows with no INF and
    no Zadig.
    Checked: the line firmware builds (SDK 2.3.1, TinyUSB 0.21.0), the BOS and
    descrip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
    [line_proto.h]
2026-10-22 build_pcb: the finisher may use In1 where the Line board has no plane (the line side)
    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
2026-10-22 Line stick: routed PCB, fab files, renders; CI checks its DRC
    Fully routed: DRC 0 errors, 0 unconnected, matches its schematic (the
    2.5 mm isolation rule included). Gerbers and the JLC placement file in
    fab/; the two Skyworks chips and the RJ11 are hand-fitted.
    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
    [pico-serial-line.kicad_pcb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]
2026-10-27 SPEC-WB: verified parts; run at 96 kHz (codec ADC passband 37 kHz)
    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
2026-10-27 netlist: wb variant, the wideband bare-pair stick (SPEC-WB)
    TLV320AIC3204 codec (I2S on GP2-5, I2C1 on GP6/7, MCLK on GP21),
    headphone drive through 60.4 R into a Pulse PE-65848 transformer,
    a x10 replica arm subtracted in the codec's mixer, 0.5 uF/500 V DC
    block in the split line winding, sidactor and TeleLink fuse.
    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
    [bom-jlc-wb.csv]
2026-10-27 schematic: wb variant (TLV320AIC3204, PE-65848 footprint and symbol)
    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
    [pico-serial-line.kicad_sch, pico-serial-wb.kicad_sch]
2026-10-27 wb: PCB placement and rules, shell variant
    build_pcb.py --variant wb: the Line stick's USB end, the transformer
    across a 4 mm isolation gap, codec and hybrid behind it; ground vias in
    the codec's exposed pad. stick.py --variant wb: LINK/DATA labels and
    the transformer in the collision check (out-wb/).
    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
    [assembly.step, board-outline.dxf, stick-bottom.step, stick-bottom.stl, stick-top.step, stick-top.stl]
2026-10-27 firmware: share the sticks' USB device and sample streams
    Ahead of the wideband stick, which needs the same USB device and the
    same sample streams as the Line stick:
    - src/core/sstream.c: the two sample streams (head start, under- and
    overruns, counters), out of daa_frame.c; line_stream_t is now the
    frames plus an sstream_t.
    - src/stick/usb_stick.c (was src/line/usb_line.c): descriptors, class
    driver and Microsoft OS 2.0 set, with the stick's numbers and requests
    behind stick.h; the Line stick's part is src/line/line_stick.c. The
    descriptors are the same bytes as before.
    - sfifo.h: SFIFO_SIZE can be set per build.
    Line builds; host tests (test_line unchanged but for field paths) a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
2026-10-27 firmware: the wideband stick (PS_BOARD=wb), TLV320AIC3204 over USB
    pico-serial WB (SPEC-WB.md): the Line stick's USB device in front of a
    TLV320AIC3204 codec at 96 kHz (48 and 192 kHz for tests), USB 1209:0003.
    - Clocks (SPEC-WB 4): MCLK is the 12 MHz crystal on GPIO21 (GPOUT0);
    the codec's PLL P=1 R=1 J.D=8.1920 makes 98.304 MHz; NDAC=NADC=
    MDAC=MADC=4; 96 kHz: DOSR=AOSR=64, PRB_P7/PRB_R7, BCLK N=4 (6.144
    MHz, 64 a frame); 192 kHz: 32, PRB_P17/PRB_R13, N=2; 48 kHz: 128,
    PRB_P1/PRB_R1, N=8. The codec is the I2S master, 32-bit words.
    - Bring-up (src/core/wb_codec.c) in SLAA557's order: pin and software
    reset, PLL, dividers, I2S, INT1 on MFP5, weak AVDD off then the A-LDO
    at 1.77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
    [aic3204.h, board_config.h, codec.c, codec.h, main.c, pico_serial_wb.h, test_wb.c, tusb_config.h]
2026-10-27 wb: wait for the MicPGAs' gain flags too before calling the codec up
    SLAA557: the PGA soft-steps from mute after power-up; page 0 register
    36 D7/D3 say when it has reached the programmed gain. The bring-up now
    waits for them with the ADCs' power flags (200 ms at most), and a test
    covers a codec whose MicPGAs never get there.
    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
2026-10-27 firmware docs: the WB stick (PROTOCOL.md, README)
    PROTOCOL.md "WB stick": finding it (1209:0003, subclass 0x57, the Line
    stick's endpoints and Microsoft OS 2.0 set; 480-byte packets), the
    samples (mono S16, the hybrid or the line channel), the requests,
    loopbacks, levels, the structures, and the codec's clocks per rate.
    README: the board in the build list and layout, a "WB stick" section
    (clocks, bring-up, the hybrid's routing, frames, LEDs, tests), and two
    findings for the spec: the differential drive on AVDD gives about +3 dBm
    for a full-scale sine (+4.8 dBm where it clips), short of SPEC-WB's
    +8 dBm, since SLAA557 allows a differential headphone load only on AVDD;
    and the A-LDO's 1.77 V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
2026-10-27 SPEC-WB: transmit level and replica capacitor as built
    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
2026-10-27 wb: screw to one side, LEDs forward, test pads in the middle
    Opens the board's centre between the codec and the RP2040 for routing.
    The WB shell's boss and light tubes follow (stick.py --variant wb).
    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
    [assembly.step, board-outline.dxf, stick-bottom.step, stick-bottom.stl, stick-top.step, stick-top.stl]
2026-10-27 WB stick: routed PCB, fab files, renders; CI checks it
    Fully routed, DRC 0 errors / 0 unconnected with schematic parity, ERC
    clean. Gerbers and the JLC placement file in hardware/kicad/fab/; the
    RJ11 is hand-fitted. CI now regenerates and checks all four boards.
    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
    [pico-serial-wb.kicad_pcb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]
2026-10-29 Point repository references at the D-Modem organisation
    The repositories moved from Neo-Desktop to the D-Modem GitHub
    organisation: D-Modem-RE is now D-Modem/D-Modem, pico-serial is
    D-Modem/hardware, modemmenu (PBX-Modem) is D-Modem/menu, bbs-sec is
    D-Modem/bbs and go3270-sec is D-Modem/go3270. Update links, module
    paths, submodule URLs and source-location strings to match. Copyright
    notices still name Neo-Desktop.
    Claude-Session: https://claude.ai/code/session_01B82eRUwD2JJ5d6fgHmpVTw
    [pico-serial-line.kicad_sch, pico-serial-w.kicad_pcb, pico-serial-w.kicad_sch, pico-serial-wb.kicad_sch, pico-serial.kicad_pcb, pico-serial.kicad_sch]
2026-10-29 Name the D-Modem Authors as the copyright holder
    Copyright lines, licensing texts and metadata named Neo-Desktop; they
    now name the D-Modem Authors, and the licensing contact points at the
    D-Modem organisation.
    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
    [pico-serial-line.kicad_sch, pico-serial-w.kicad_sch, pico-serial-wb.kicad_sch, pico-serial.kicad_sch]
2026-10-30 SPEC-S0: an ISDN S/T (S0) stick, draft 0.1
    An XHFC-1SU behind the RP2040: B-channels over its PCM bus in PIO,
    the D-channel's HDLC frames over SPI, TE and NT mode, switchable
    terminations. The USB interface follows the Line stick's; LAPD, Q.931
    and CAPI stay in dmodemd. A software S0 in PIO is the analysed fallback.
    Claude-Session: https://claude.ai/code/session_01B82eRTei4CQRzN1vNsNV5s
2026-10-30 SPEC-FX: an FPGA line board for ADSL or ISDN, feasibility study
    ECP5-25F with a USB 2.0 HS ULPI PHY, an AD9866 front end, a THS6222
    line driver and a Si5351 sample clock; one gateware streams samples
    for ADSL, ISDN U and WB modes run in D-Modem on the host, plus a soft
    S0 port in logic.
    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
2026-10-30 SPEC-S0 0.2: software S0 on the RP2040, no ISDN chip
    Sydney chose the software S0 for rev A. The line is driven by a
    74LVC2G125 through the transmit transformer and read by a TLV3202
    against a PWM-set threshold; PIO moves the bits, core 1 runs I.430
    (clock and frame recovery, the TE's two-bit offset, D-channel access,
    activation), core 0 USB and HDLC. 96 MHz gives 500 cycles a bit. Adds
    bench test signals and a conformance plan; the XHFC-1SU becomes the
    fallback. SPEC-FX points at the new sections.
    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
2026-11-01 CI: cache apt and Homebrew downloads
    Package installs sometimes stall on GitHub's runners. A local action
    (.github/actions/apt, and .github/actions/brew where macOS builds) caches
    the downloaded packages, and apt's package lists with them, keyed on the
    runner image and the package list. A cache hit installs offline; a miss
    installs as before, with retries and timeouts, and saves the cache.
    Claude-Session: https://claude.ai/code/session_01B82eRUAp3wTZAV7UCEiC4S
2026-11-05 README as a landing page; current names; CI skips doc-only changes
    The README now introduces all four boards (it said spec only and listed
    only the W variant), with a quick start, a docs index (docs/README.md)
    and the suite's repositories. D-Modem-RE and dmodem-android become
    D-Modem and the D-Modem app, as in brand's naming guide. The firmware
    and hardware workflows skip changes to their hand-written Markdown; the
    generated NETLIST*.md and placement.md files still trigger them.
    Claude-Session: https://claude.ai/code/session_01B82eRSqjp9Pn2KBr9N9LAn
2026-11-06 Add the site, with a protocol reference made from the headers (#10)
    firmware/tools/protocol_ref.py writes docs/protocol-reference.md from
    protocol.h, line_proto.h and wb_proto.h: every request, constant and
    enum, and each wire struct's fields with their offsets and sizes (checked
    against the headers' _Static_asserts). The firmware workflow and the new
    Pages workflow fail if the page is out of date.
    The site is docs/, the README, the specs and the firmware, hardware,
    enclosure and net list pages (extra.site_include), on brand's theme.
    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
