D-Modem/hardware/(notices)

Notices in the files:
hardware/kicad/pico-serial-wb.kicad_sch:
CERN-OHL-S-2.0 (or commercial licence from Neo-Desktop)
